Mounted-project/AugMounted-electronics/README.md

# AugMounted-electronics
Electronic repo for the AugMounted line-up
