Mounted-project/AugMounted-electronics/prototype_v1.0.0/AugMounted_Prototype_2_2023-Feb-03_08-58-28AM-000_CustomizedView646584446.png

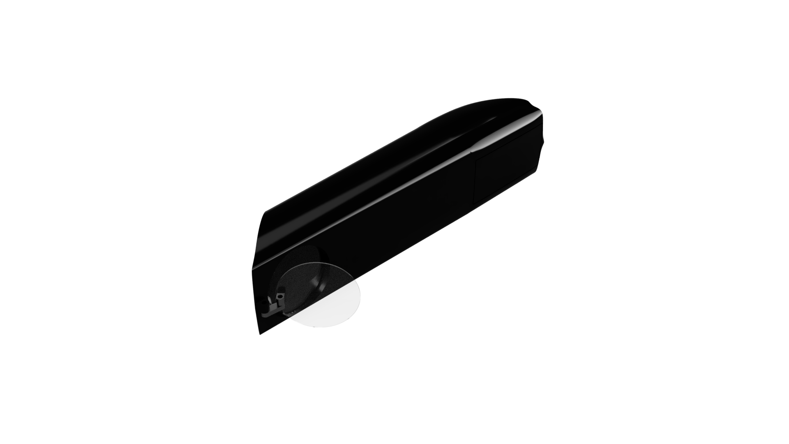
prototype_v1.0.0/AugMounted_Prototype_2_2023-Feb-03_08-58-28AM-000_CustomizedView646584446.png
