Mounted-project/AugMounted-electronics/R&D/HMI-PlugBoard_v1.0.0/00_RESOURCES/BQ24296MRGER.png

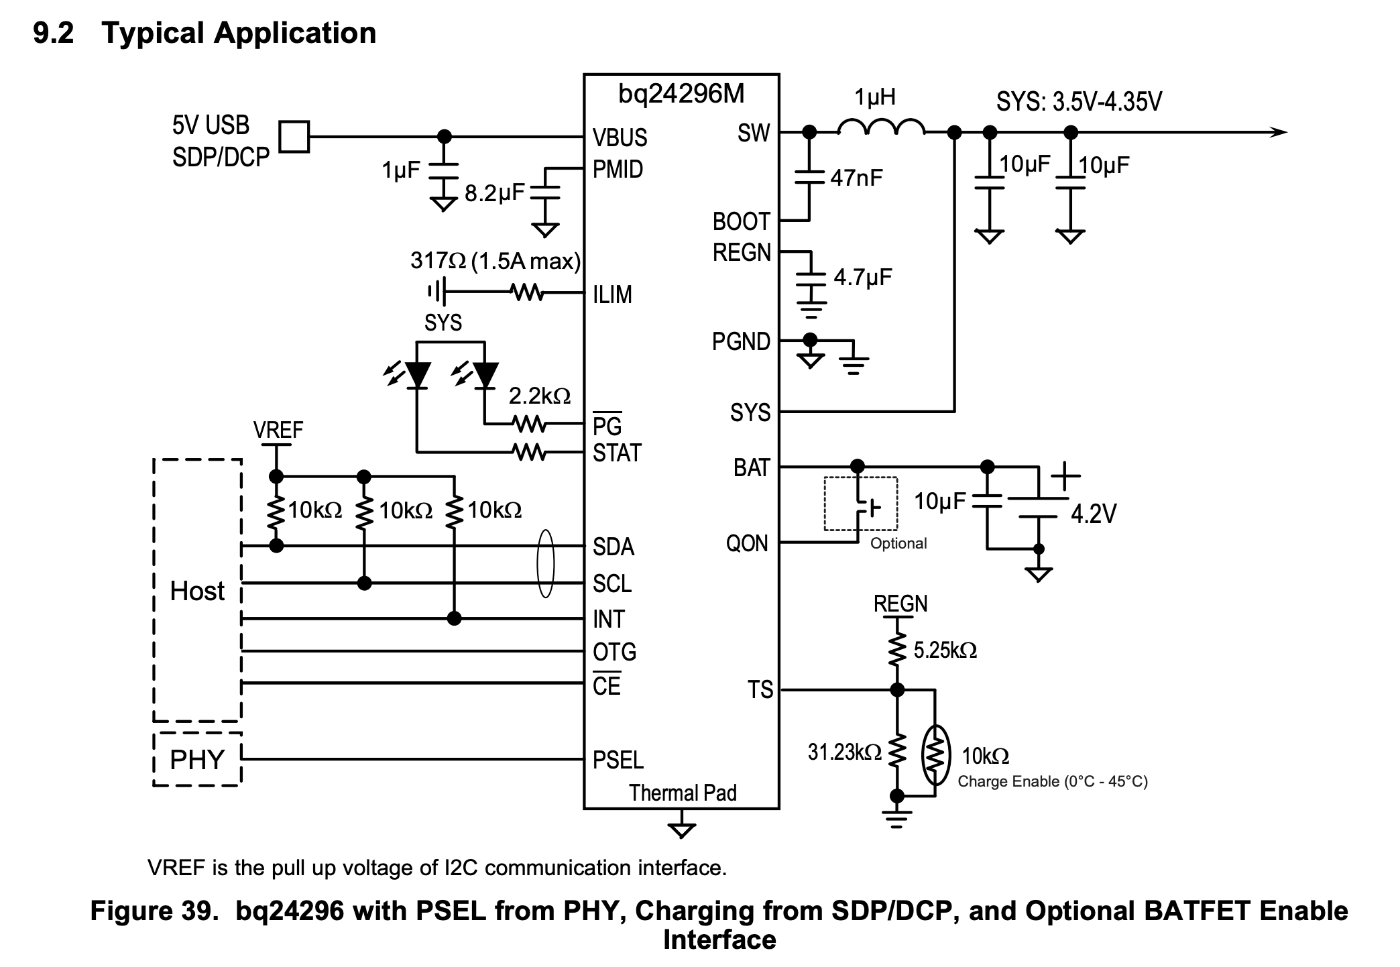
R&D/HMI-PlugBoard_v1.0.0/00_RESOURCES/BQ24296MRGER.png
