Mounted-project/AugMounted-electronics/R&D/HMI-PlugBoard_v1.0.0/00_RESOURCES/LP3987H-18B5F.png

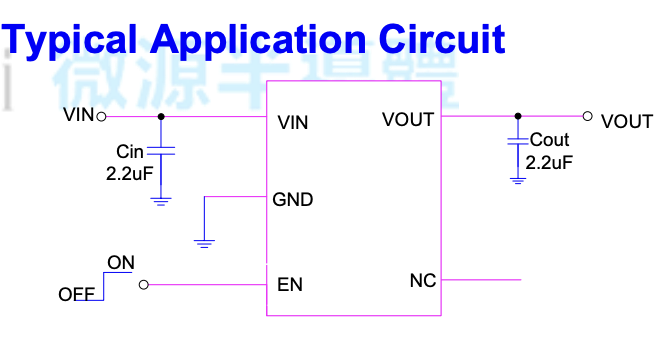
R&D/HMI-PlugBoard_v1.0.0/00_RESOURCES/LP3987H-18B5F.png
