Mounted-project/AugMounted-electronics/R&D/HMI-PlugBoard_v1.0.0/00_RESOURCES/MAX17048.png

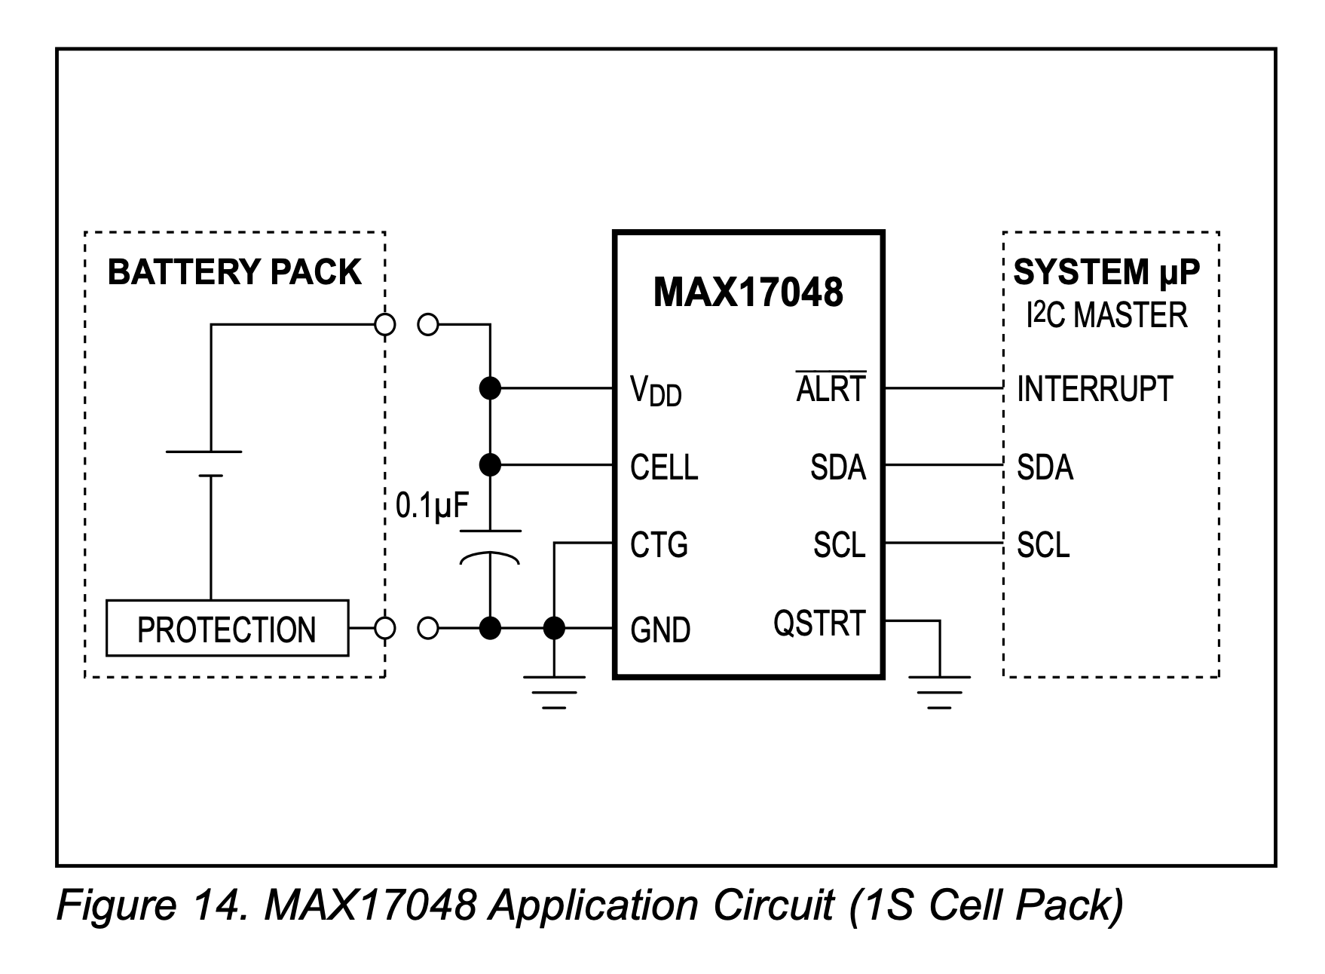
R&D/HMI-PlugBoard_v1.0.0/00_RESOURCES/MAX17048.png
