Mounted-project/AugMounted-electronics/R&D/HMI-PlugBoard_v1.0.0/00_RESOURCES/TPS63001DRCR.png

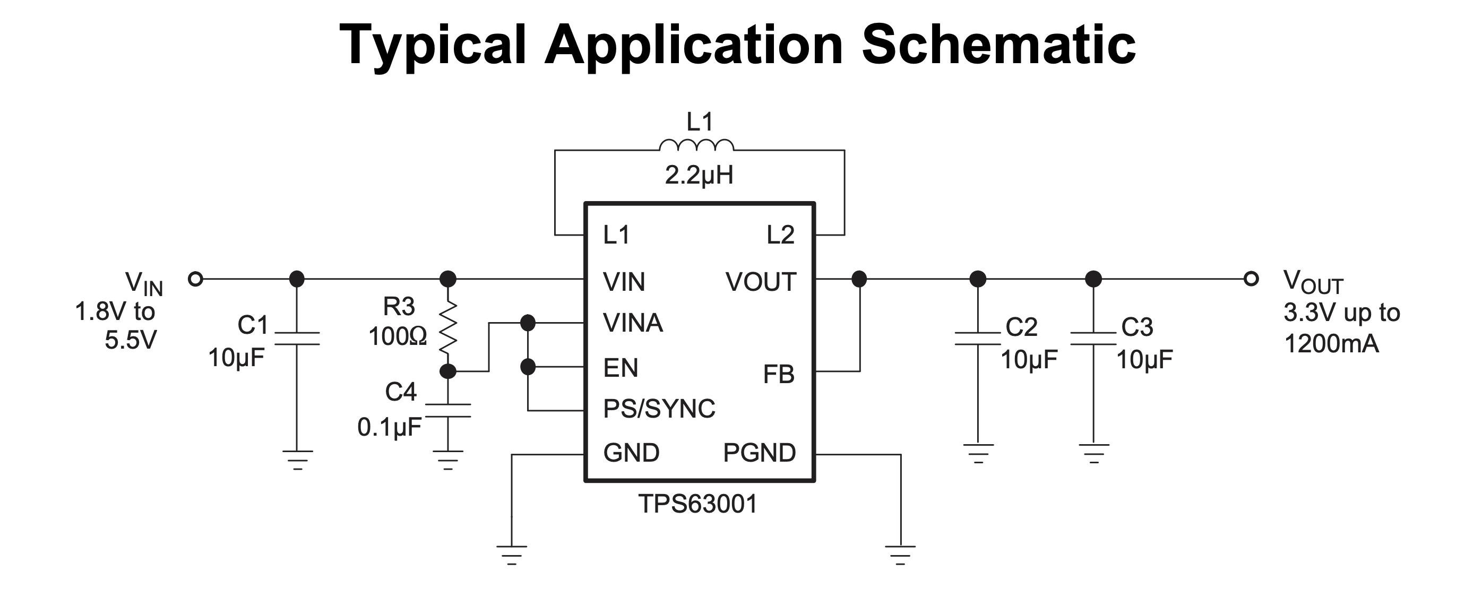
R&D/HMI-PlugBoard_v1.0.0/00_RESOURCES/TPS63001DRCR.png
