Mounted-project/AugMounted-electronics/R&D/HMI-PlugBoard_v1.0.0/00_RESOURCES/TXB0108.png

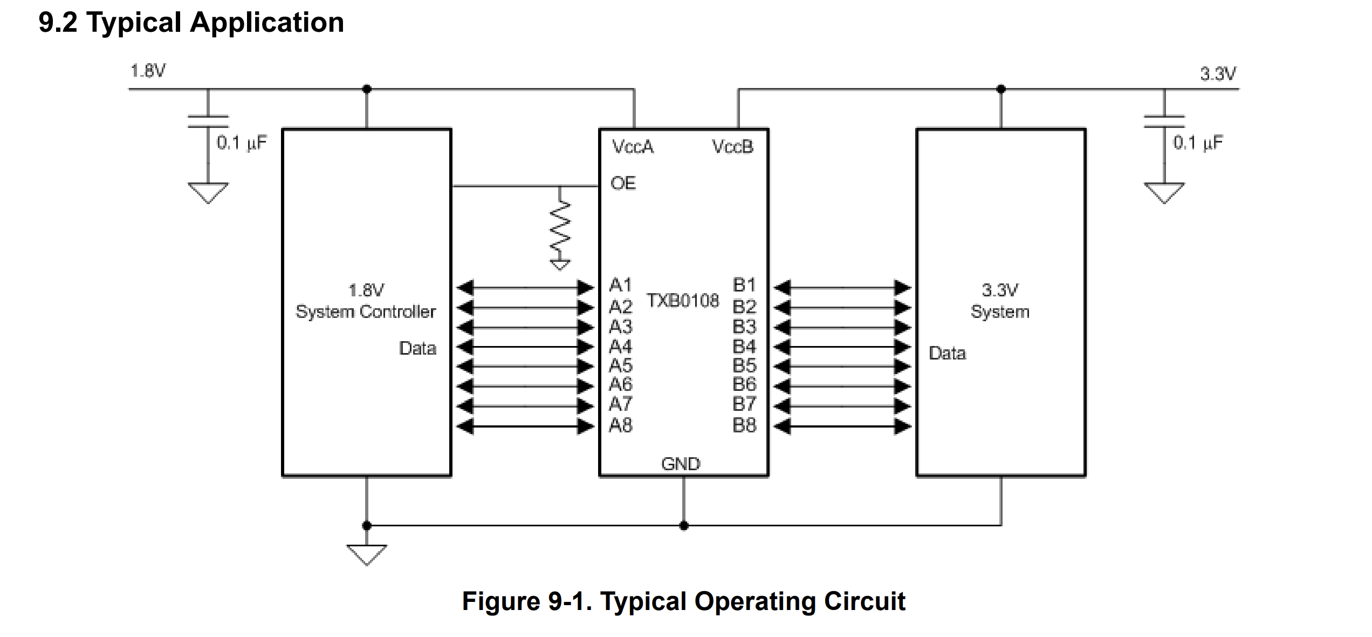
R&D/HMI-PlugBoard_v1.0.0/00_RESOURCES/TXB0108.png
