Mounted-project/AugMounted-electronics/R&D/HMI-PlugBoard_v1.0.0/00_RESOURCES/25mm.3mf

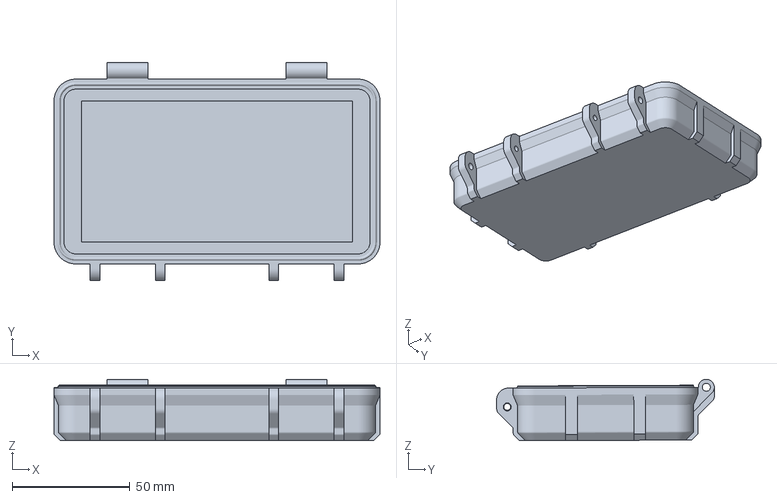
[picture p9: CAD file, 2023-11-28]
R&D/HMI-PlugBoard_v1.0.0/00_RESOURCES/25mm.3mf
138.5 x 92.5 x 26.1 mm
