Mounted-project/AugMounted-electronics/R&D/HMI_v1.0.0/02_OUTPUTS/03_MECHANICAL/HMI_A.step

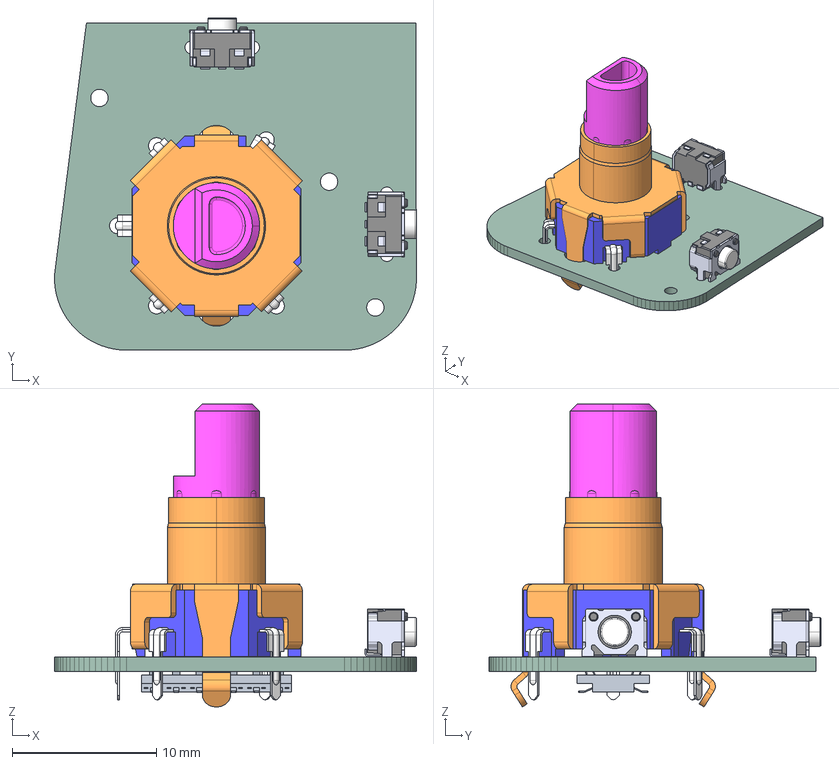
[picture p10: CAD file, 2024-01-17]
R&D/HMI_v1.0.0/02_OUTPUTS/03_MECHANICAL/HMI_A.step
25.1 x 23.0 x 21.0 mm
HMI PCB
