Mounted-project/AugMounted-electronics/mounted-lib/3D/U_MP34DT05TR-A.step

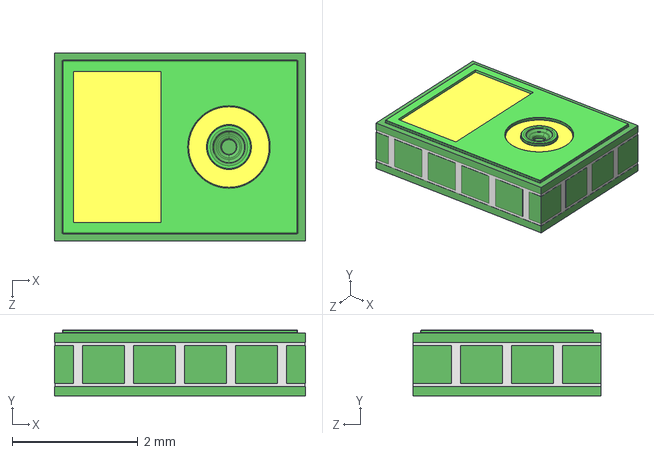
[picture p11: CAD file, 2023-11-28]
mounted-lib/3D/U_MP34DT05TR-A.step
4.00 x 1.05 x 3.00 mm
