Mounted-project/AugMounted-electronics/R&D/HMI-PlugBoard_v1.0.0/00_RESOURCES/outline8.dxf

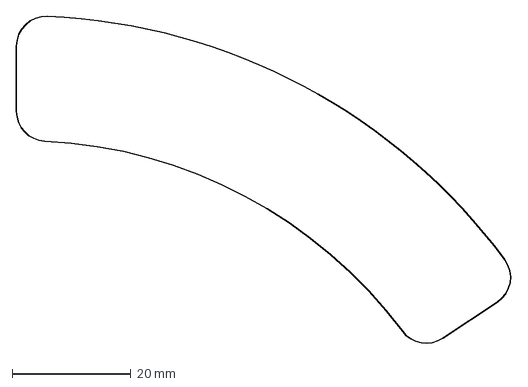
[picture p12: CAD file, 2023-11-24]
R&D/HMI-PlugBoard_v1.0.0/00_RESOURCES/outline8.dxf
83.4 x 55.8 mm
