Mounted-project/AugMounted-electronics/R&D/Zoka-MainBoard_v1.0.0/00_RESOURCES/outline6.dxf

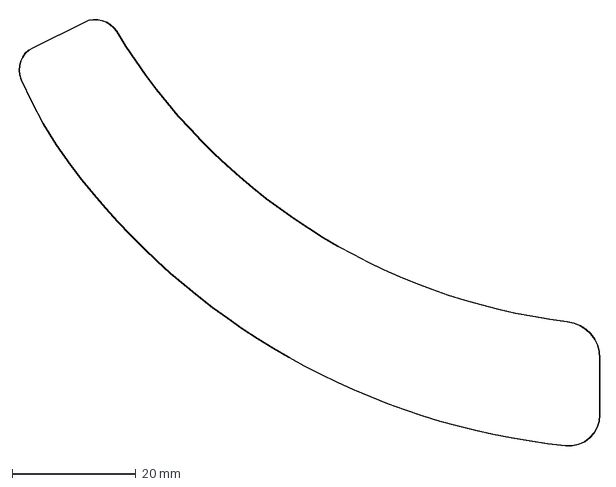
[picture p13: CAD file, 2023-11-24]
R&D/Zoka-MainBoard_v1.0.0/00_RESOURCES/outline6.dxf
94.4 x 69.5 mm
