Mounted-project/AugMounted-electronics/mounted-lib/3D/VQFN-20_TEXAS_INSTRUMENTS.step

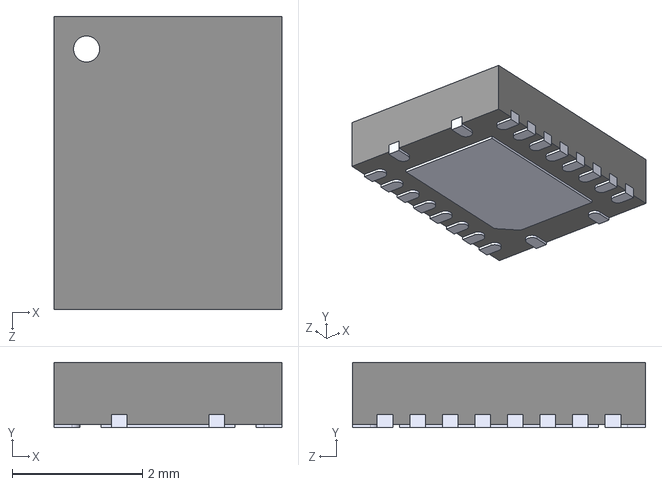
[picture p14: CAD file, 2023-11-24]
mounted-lib/3D/VQFN-20_TEXAS_INSTRUMENTS.step
3.50 x 1.00 x 4.50 mm
