Mounted-project/AugMounted-electronics/mounted-lib/3D/R_0402_1005Metric.step

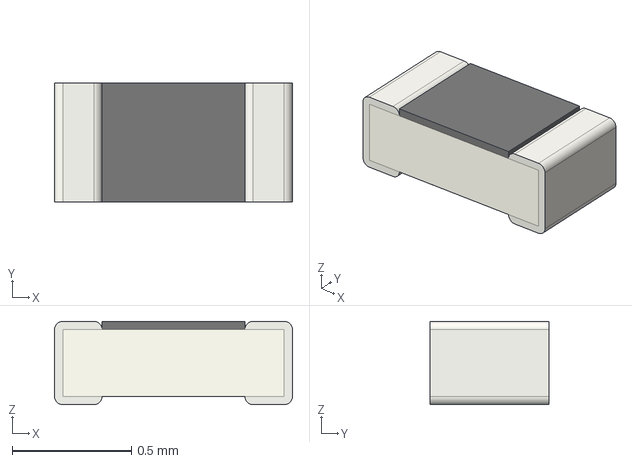
[picture p15: CAD file, 2023-11-24]
mounted-lib/3D/R_0402_1005Metric.step
1.00 x 0.5 x 0.35 mm
