Mounted-project/AugMounted-electronics/R&D/HMI-PlugBoard_v1.0.0/00_RESOURCES/outline5.dxf

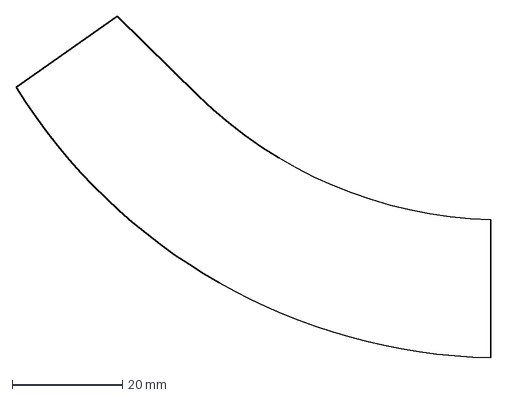
[picture p16: CAD file, 2023-11-23]
R&D/HMI-PlugBoard_v1.0.0/00_RESOURCES/outline5.dxf
86.0 x 61.8 mm
