Mounted-project/AugMounted-electronics/R&D/HMI_v1.0.0/00_RESOURCES/outlne6.dxf

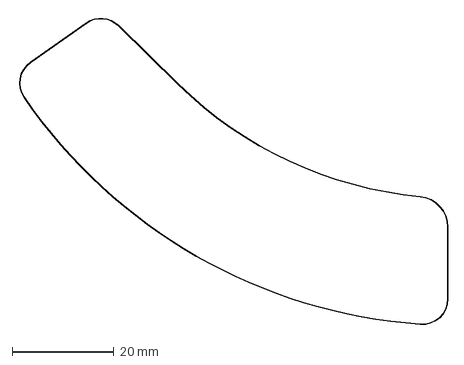
[picture p17: CAD file, 2023-11-23]
R&D/HMI_v1.0.0/00_RESOURCES/outlne6.dxf
84.8 x 60.7 mm
