Mounted-project/AugMounted-electronics/mounted-lib/3D/LED_LTW-010DCG.step

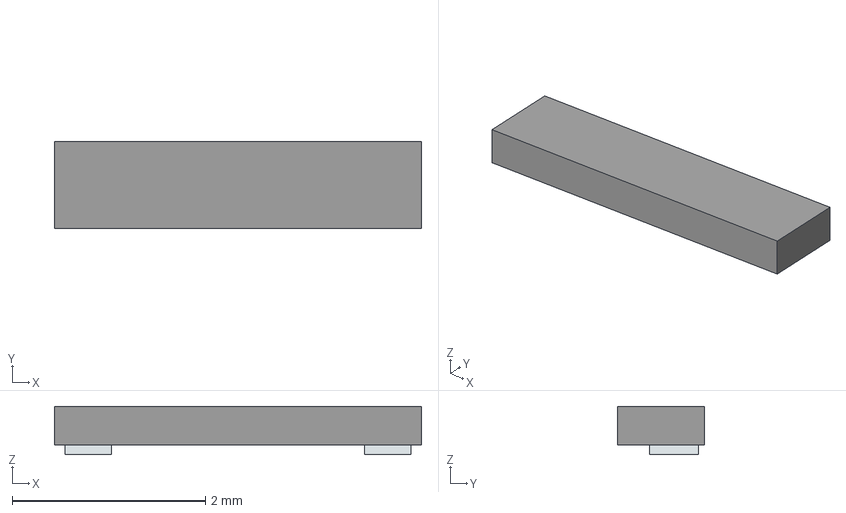
[picture p18: CAD file, 2023-11-23]
mounted-lib/3D/LED_LTW-010DCG.step
3.80 x 0.9 x 0.5 mm
Pins
