Mounted-project/AugMounted-electronics/mounted-lib/3D/LED_MHPC3528CRGBCT.step

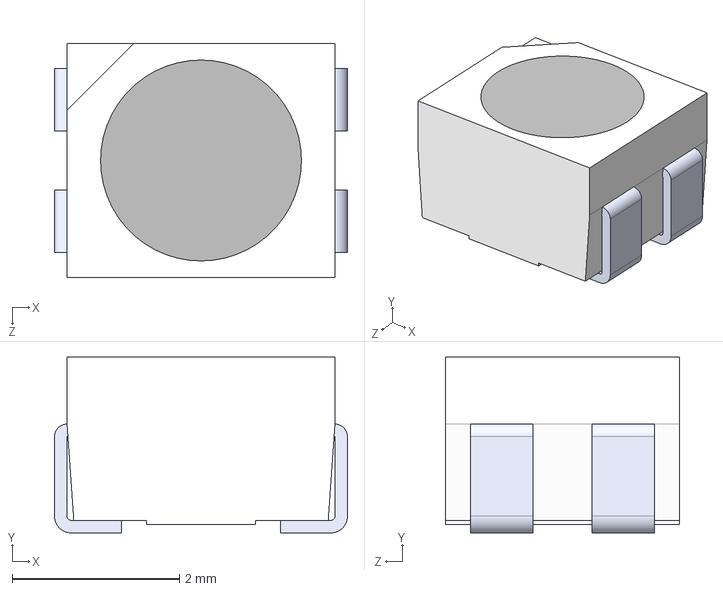
[picture p19: CAD file, 2023-11-23]
mounted-lib/3D/LED_MHPC3528CRGBCT.step
3.50 x 2.10 x 2.80 mm
