Mounted-project/AugMounted-electronics/R&D/HMI-PlugBoard_v1.0.0/00_RESOURCES/outline2.dxf

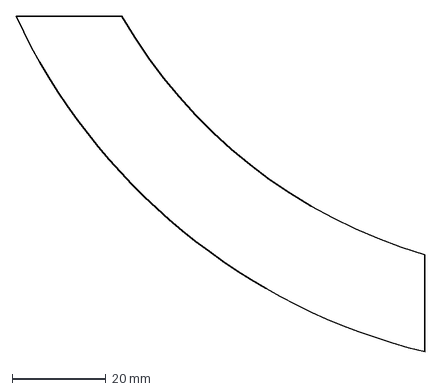
[picture p20: CAD file, 2023-11-23]
R&D/HMI-PlugBoard_v1.0.0/00_RESOURCES/outline2.dxf
87.1 x 71.5 mm
