Mounted-project/AugMounted-electronics/R&D/HMI_v1.0.0/00_RESOURCES/outline3.dxf

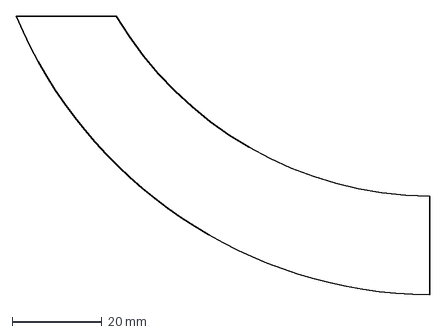
[picture p21: CAD file, 2023-11-23]
R&D/HMI_v1.0.0/00_RESOURCES/outline3.dxf
92.0 x 62.1 mm
