Mounted-project/AugMounted-electronics/R&D/Zoka-MainBoard_v1.0.0/00_RESOURCES/outline4.dxf

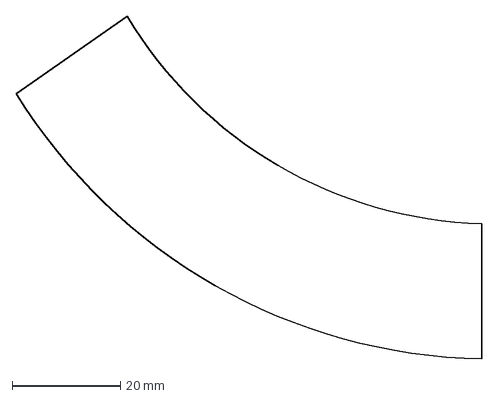
[picture p22: CAD file, 2023-11-23]
R&D/Zoka-MainBoard_v1.0.0/00_RESOURCES/outline4.dxf
86.0 x 63.3 mm
