Mounted-project/AugMounted-electronics/mounted-lib/3D/J_788641001.stp

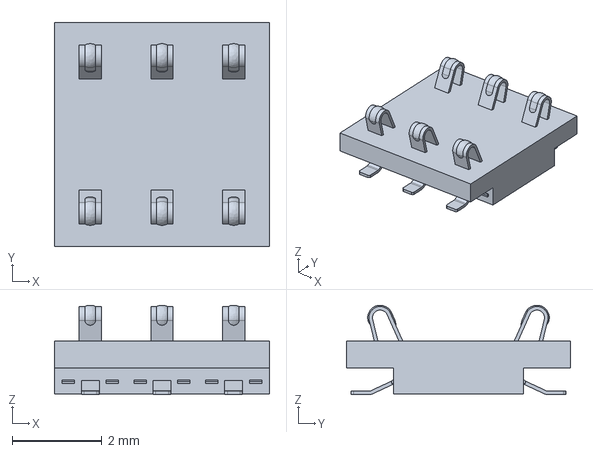
[picture p23: CAD file, 2023-11-23]
mounted-lib/3D/J_788641001.stp
4.80 x 5.00 x 2.00 mm
