Mounted-project/AugMounted-electronics/R&D/Zoka-MainBoard_v1.0.0/00_RESOURCES/outline.dxf

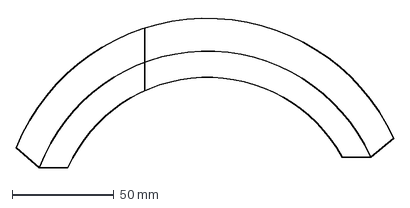
[picture p24: CAD file, 2023-11-23]
R&D/Zoka-MainBoard_v1.0.0/00_RESOURCES/outline.dxf
185.1 x 74.2 mm
