Mounted-project/AugMounted-electronics/mounted-lib/3D/LGA-12_2x2mm_P0.5mm_ST.step

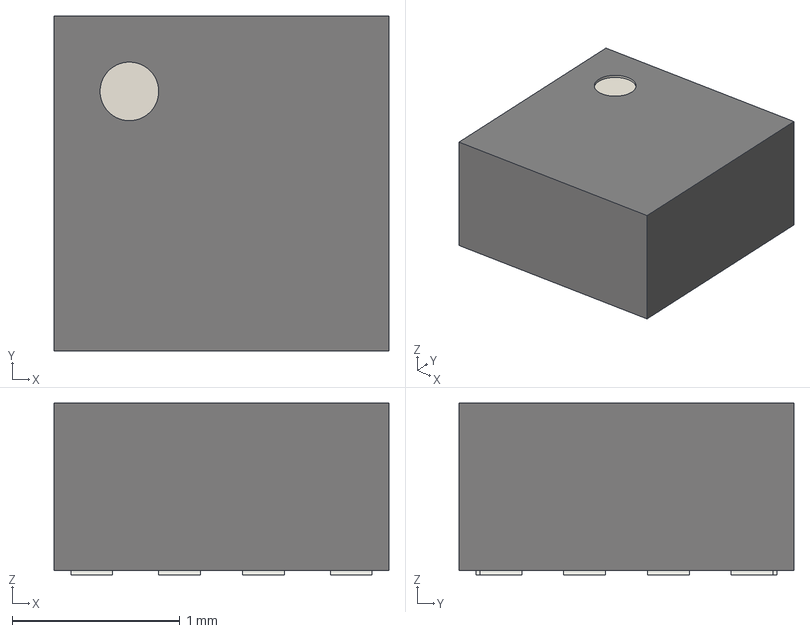
[picture p25: CAD file, 2023-11-17]
mounted-lib/3D/LGA-12_2x2mm_P0.5mm_ST.step
2.00 x 2.00 x 1.02 mm
