Mounted-project/AugMounted-electronics/mounted-lib/3D/SW_SKRTLAE010.step

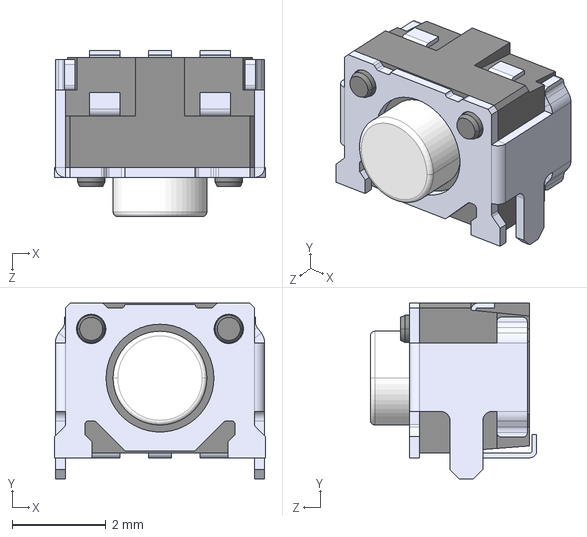
[picture p26: CAD file, 2023-11-16]
mounted-lib/3D/SW_SKRTLAE010.step
4.50 x 3.75 x 3.55 mm
