Mounted-project/AugMounted-electronics/mounted-lib/3D/QFN-28-1EP_6x6mm_P0.65mm_EP4.25x4.25mm_MICROCHIP.step

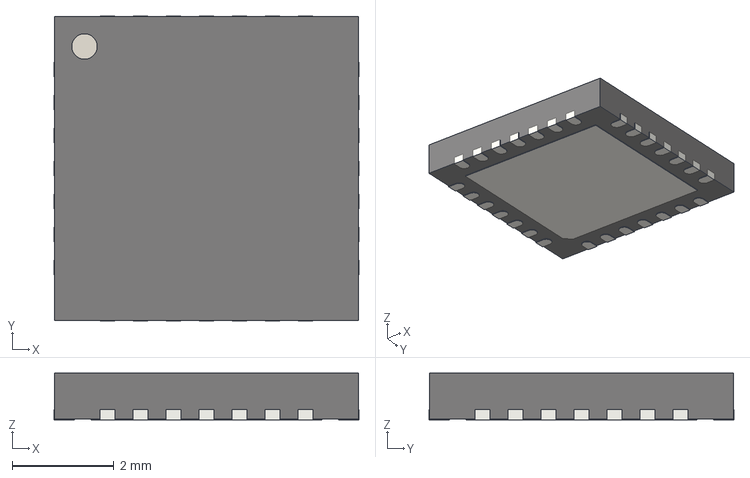
[picture p27: CAD file, 2023-11-16]
mounted-lib/3D/QFN-28-1EP_6x6mm_P0.65mm_EP4.25x4.25mm_MICROCHIP.step
6.00 x 6.00 x 0.92 mm
