Mounted-project/AugMounted-electronics/mounted-lib/3D/SW_EC12D1564404.step

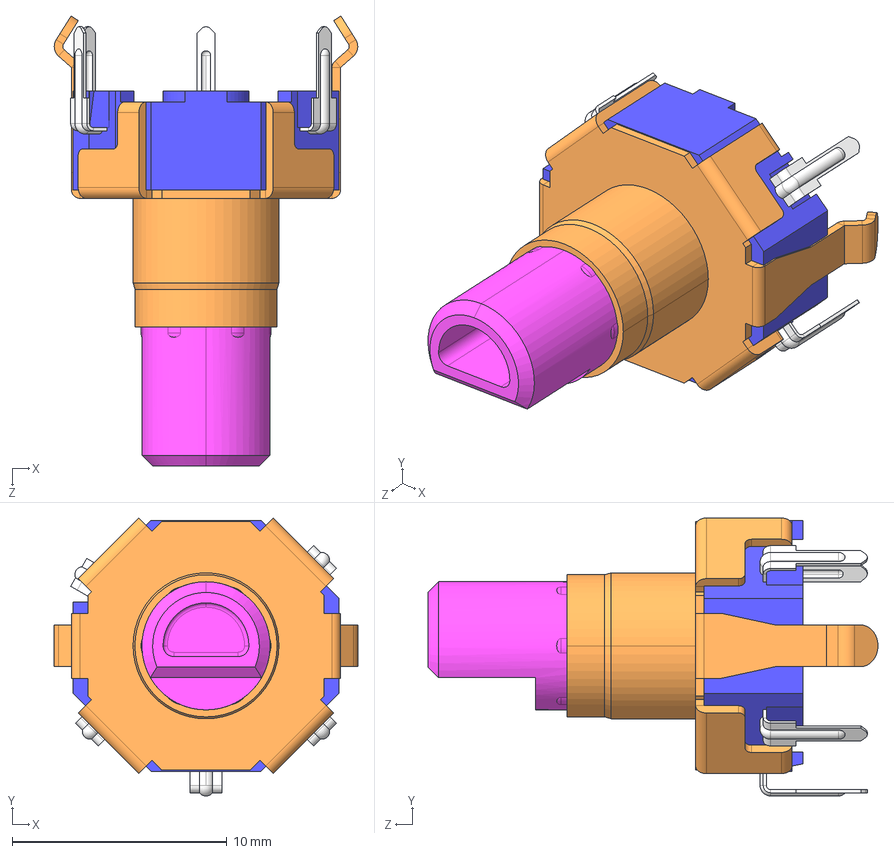
[picture p28: CAD file, 2023-11-15]
mounted-lib/3D/SW_EC12D1564404.step
14.1 x 13.0 x 21.0 mm
