Mounted-project/AugMounted-electronics/mounted-lib/3D/J_JST_S2B-PH-SM4-TB.step

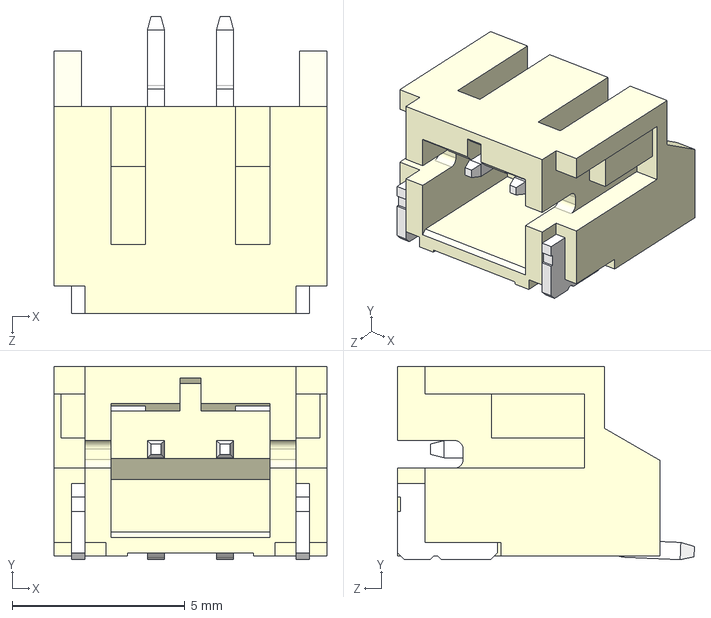
[picture p29: CAD file, 2023-11-15]
mounted-lib/3D/J_JST_S2B-PH-SM4-TB.step
7.90 x 5.60 x 8.60 mm
