Mounted-project/AugMounted-electronics/mounted-lib/3D/L_FNR3015S2R2MT.step

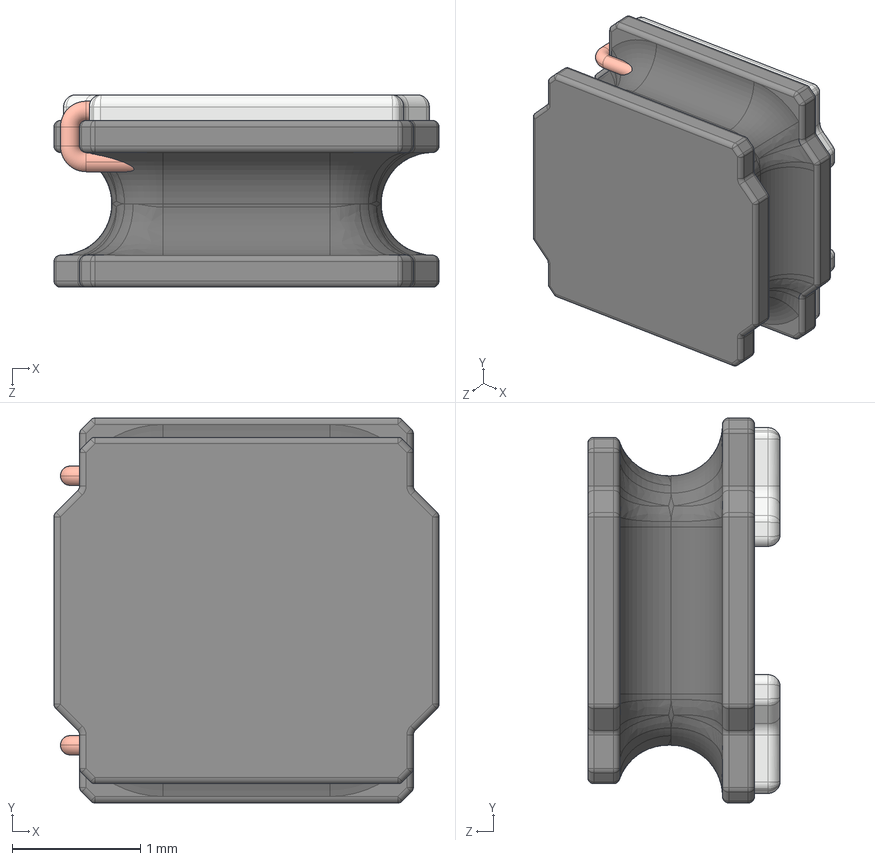
[picture p30: CAD file, 2023-11-15]
mounted-lib/3D/L_FNR3015S2R2MT.step
3.00 x 3.00 x 1.50 mm
