Mounted-project/AugMounted-electronics/mounted-lib/3D/VCNL4040_4X2X1.1_VISHAY.step

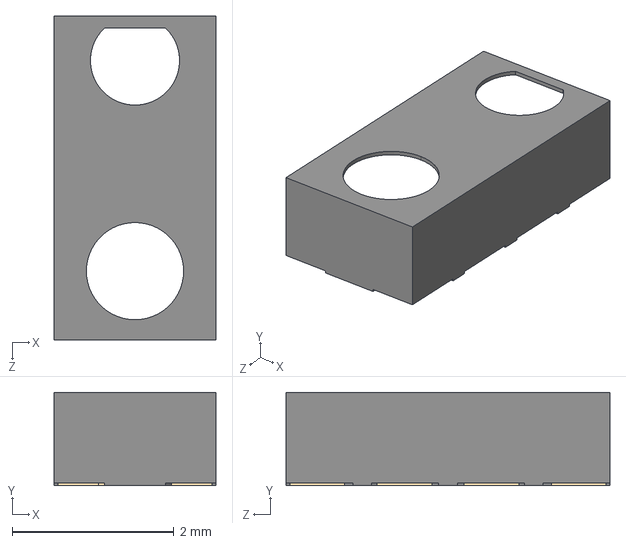
[picture p31: CAD file, 2023-11-15]
mounted-lib/3D/VCNL4040_4X2X1.1_VISHAY.step
2.00 x 1.15 x 4.00 mm
