Mounted-project/AugMounted-electronics/mounted-lib/3D/L_7447789003.step

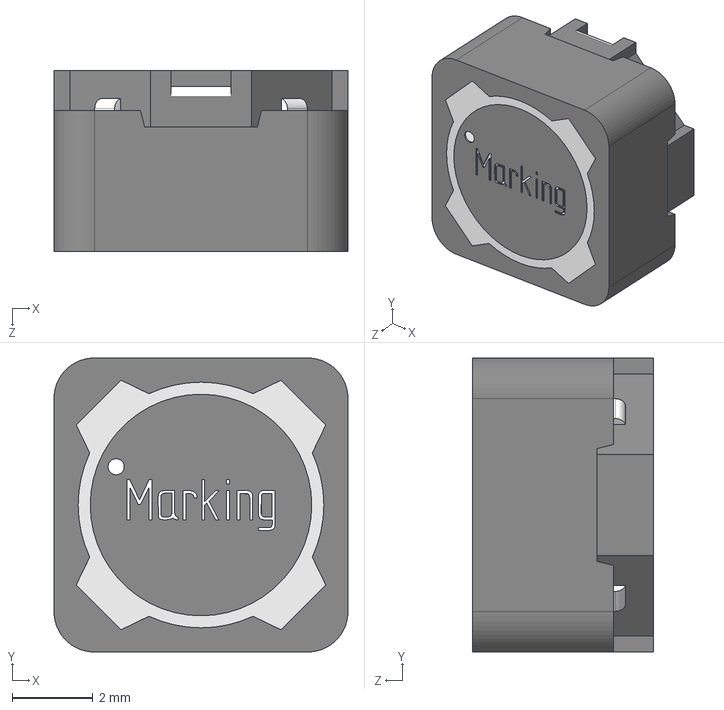
[picture p32: CAD file, 2023-11-08]
mounted-lib/3D/L_7447789003.step
7.30 x 7.30 x 4.50 mm
