Mounted-project/AugMounted-electronics/mounted-lib/3D/VQFN-24_TEXAS_INSTRUMENTS.step

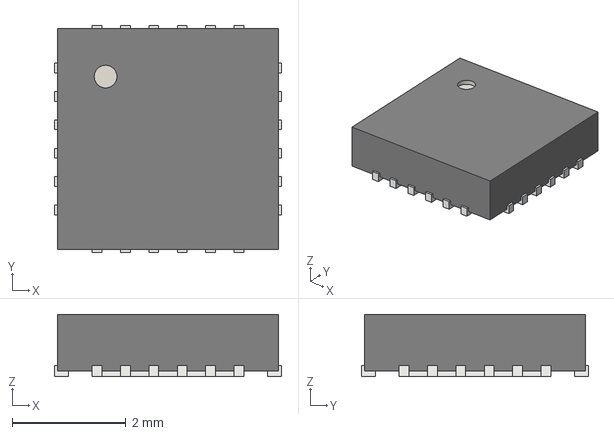
[picture p33: CAD file, 2023-11-05]
mounted-lib/3D/VQFN-24_TEXAS_INSTRUMENTS.step
4.00 x 4.00 x 1.10 mm
