Mounted-project/AugMounted-electronics/mounted-lib/3D/TDFN-8_MAXIM_INTEGRATED.step

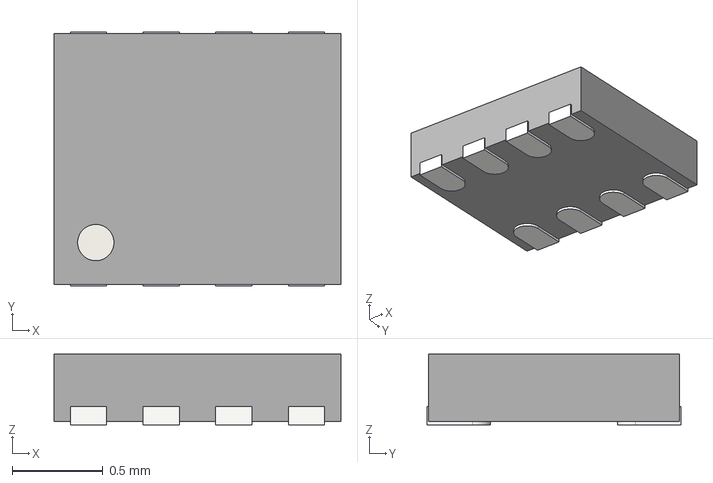
[picture p34: CAD file, 2023-11-05]
mounted-lib/3D/TDFN-8_MAXIM_INTEGRATED.step
1.58 x 1.40 x 0.39 mm
