Mounted-project/AugMounted-electronics/mounted-lib/3D/POWERPAK_SO-8_VISHAY.step

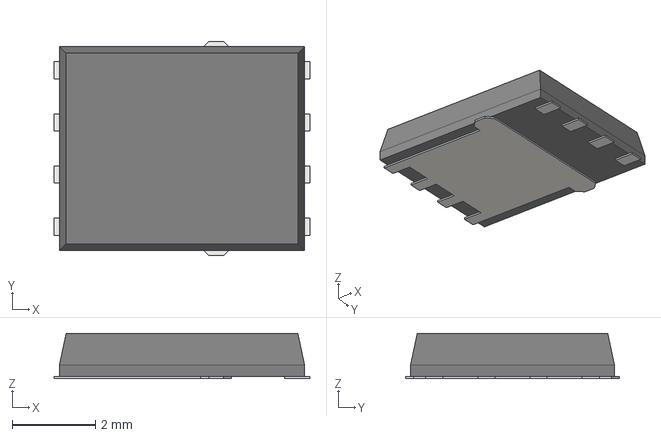
[picture p35: CAD file, 2023-11-05]
mounted-lib/3D/POWERPAK_SO-8_VISHAY.step
6.15 x 5.15 x 1.09 mm
