Mounted-project/AugMounted-electronics/mounted-lib/3D/SOT-323_SC-70_DIODES_INC.step

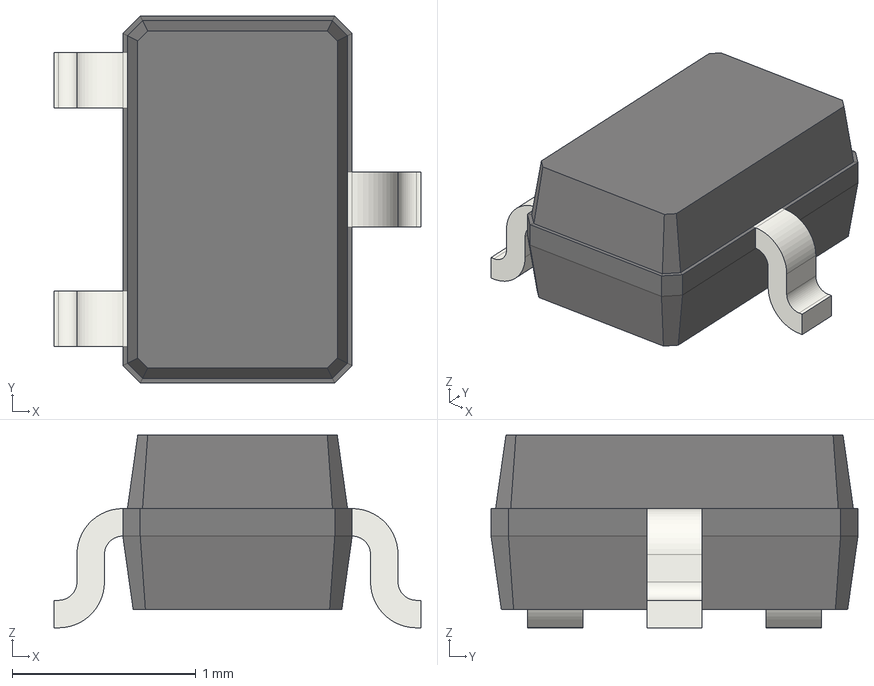
[picture p37: CAD file, 2023-11-05]
mounted-lib/3D/SOT-323_SC-70_DIODES_INC.step
2.00 x 2.00 x 1.05 mm
