Mounted-project/AugMounted-electronics/mounted-lib/3D/F_0684L9400-01.step

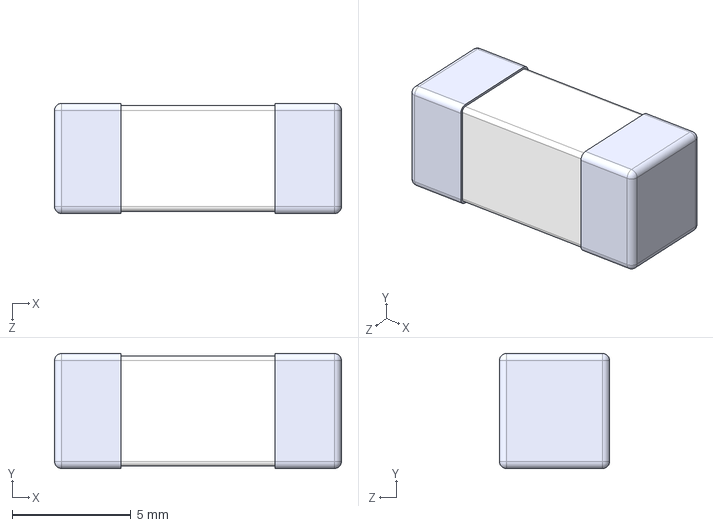
[picture p38: CAD file, 2023-11-05]
mounted-lib/3D/F_0684L9400-01.step
12.1 x 4.85 x 4.65 mm
