Mounted-project/AugMounted-electronics/mounted-lib/3D/C_0603_1608Metric.step

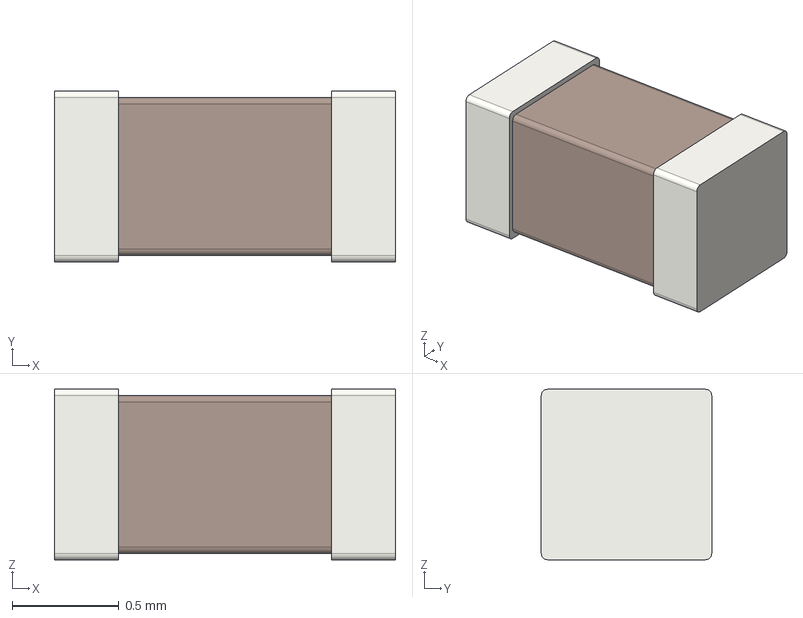
[picture p39: CAD file, 2023-11-05]
mounted-lib/3D/C_0603_1608Metric.step
1.60 x 0.8 x 0.8 mm
