Mounted-project/AugMounted-electronics/mounted-lib/3D/WSON-10_TEXAS_INSTRUMENT.step

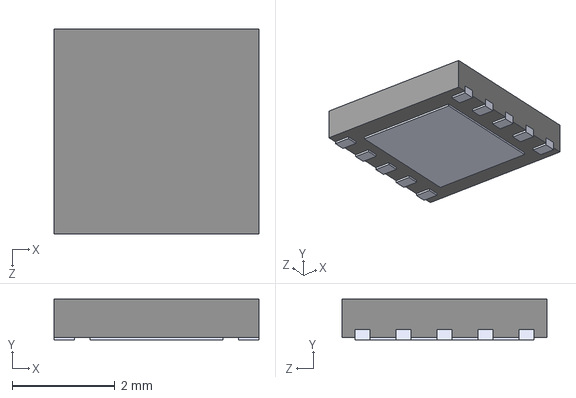
[picture p40: CAD file, 2023-11-05]
mounted-lib/3D/WSON-10_TEXAS_INSTRUMENT.step
4.00 x 0.8 x 4.00 mm
