Mounted-project/AugMounted-electronics/mounted-lib/3D/R_1210_3225Metric.step

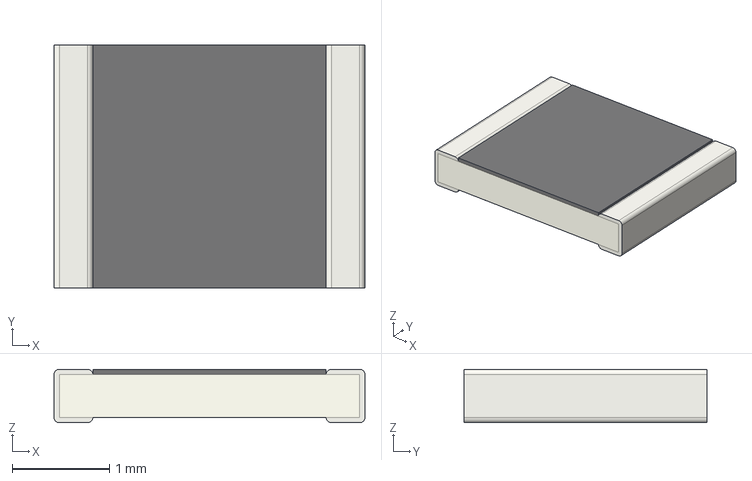
[picture p41: CAD file, 2023-11-05]
mounted-lib/3D/R_1210_3225Metric.step
3.20 x 2.50 x 0.55 mm
