Mounted-project/AugMounted-electronics/mounted-lib/3D/PVSON-N10_TEXAS_INSTRUMENTS.step

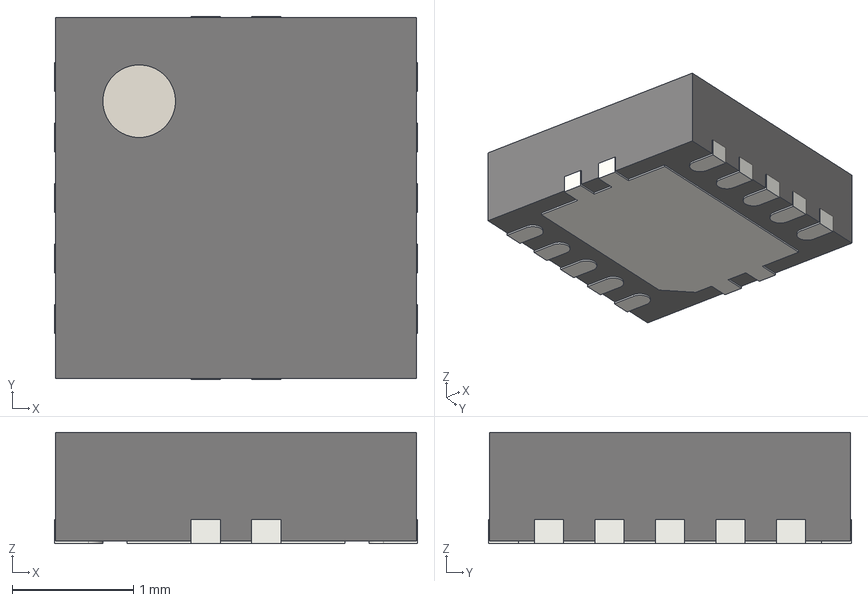
[picture p42: CAD file, 2023-11-05]
mounted-lib/3D/PVSON-N10_TEXAS_INSTRUMENTS.step
3.00 x 3.00 x 0.92 mm
