Mounted-project/AugMounted-electronics/mounted-lib/3D/CP_Elec_8x10.5_KNSCHA.step

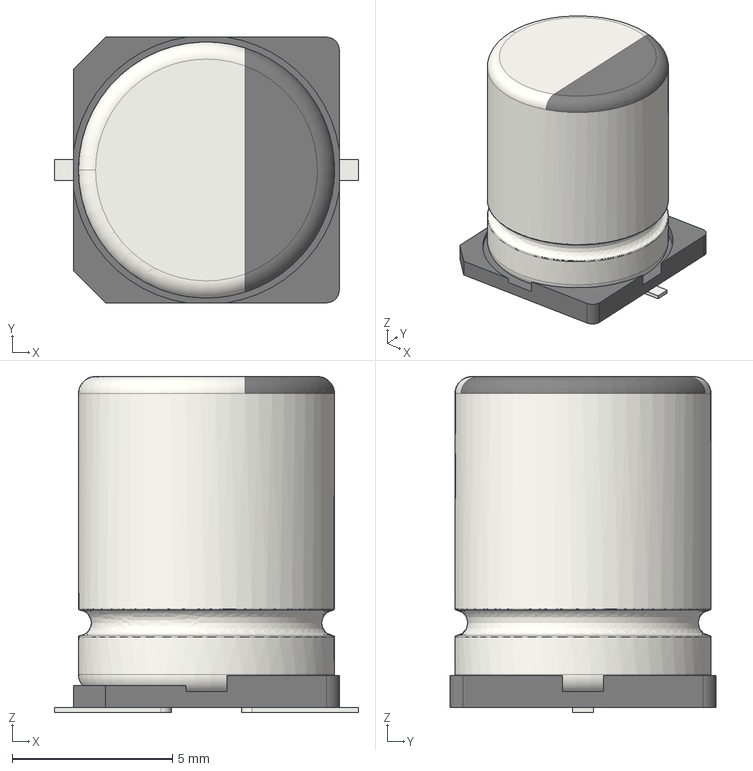
[picture p43: CAD file, 2023-11-05]
mounted-lib/3D/CP_Elec_8x10.5_KNSCHA.step
9.50 x 8.30 x 10.5 mm
