Mounted-project/AugMounted-electronics/mounted-lib/3D/TO-252-3_TabPin2_DIODES_INC.step

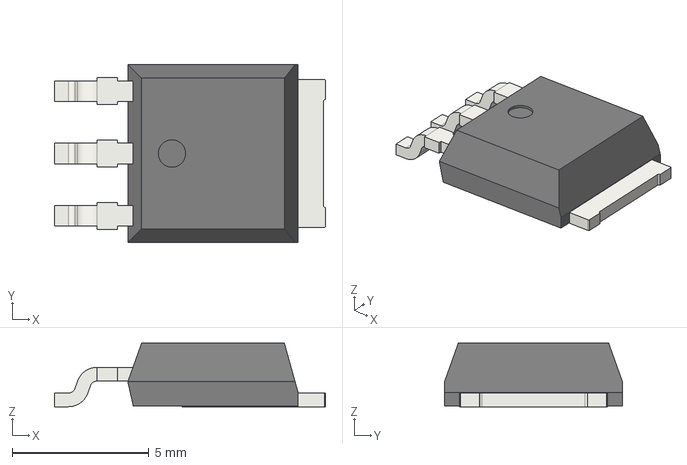
[picture p44: CAD file, 2023-11-05]
mounted-lib/3D/TO-252-3_TabPin2_DIODES_INC.step
9.90 x 6.50 x 2.32 mm
