Mounted-project/AugMounted-electronics/mounted-lib/3D/TL3301CFxxxxG.stp

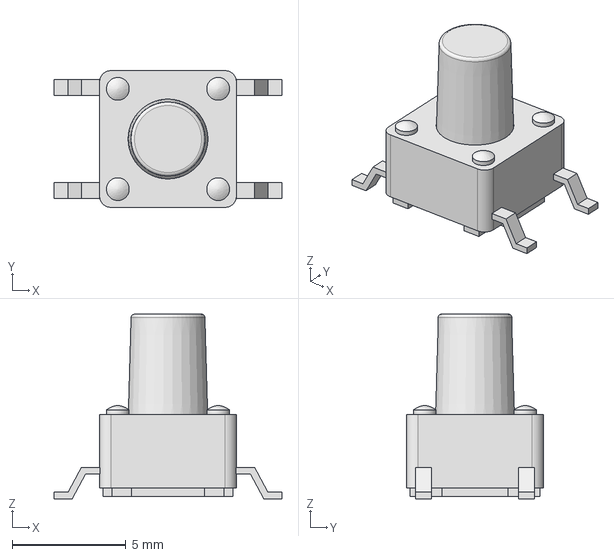
[picture p45: CAD file, 2023-11-05]
mounted-lib/3D/TL3301CFxxxxG.stp
10.00 x 6.00 x 8.10 mm
