Mounted-project/AugMounted-electronics/mounted-lib/3D/SOP-16_3.9x10mm_P1.27mm_WCH.step

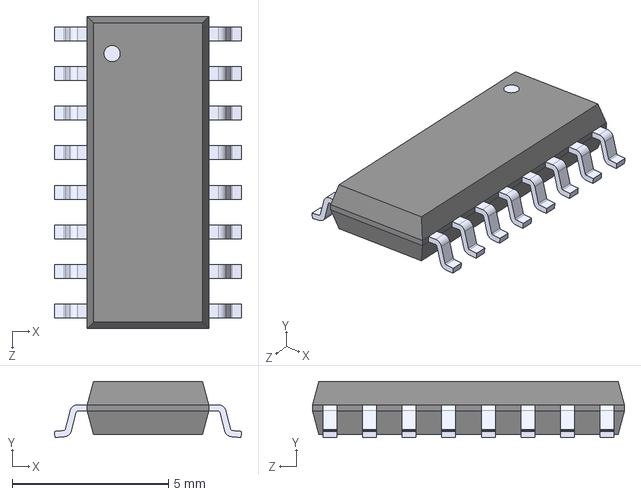
[picture p46: CAD file, 2023-11-05]
mounted-lib/3D/SOP-16_3.9x10mm_P1.27mm_WCH.step
6.00 x 1.80 x 10.0 mm
