Mounted-project/AugMounted-electronics/mounted-lib/3D/J_XT60-F.step

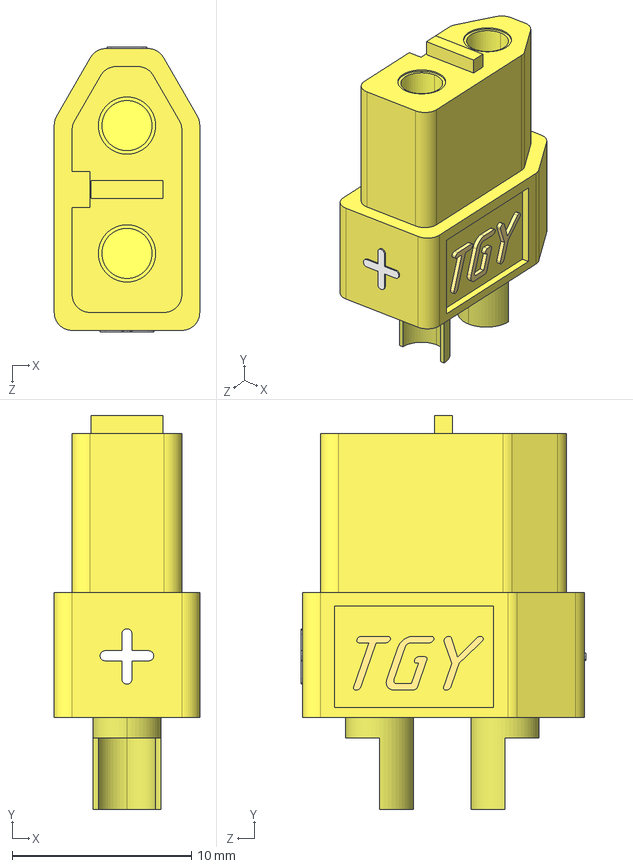
[picture p47: CAD file, 2023-11-05]
mounted-lib/3D/J_XT60-F.step
8.13 x 22.0 x 15.9 mm
