Mounted-project/AugMounted-electronics/mounted-lib/3D/PTS815_SJM_250_SMTR_LFS.stp

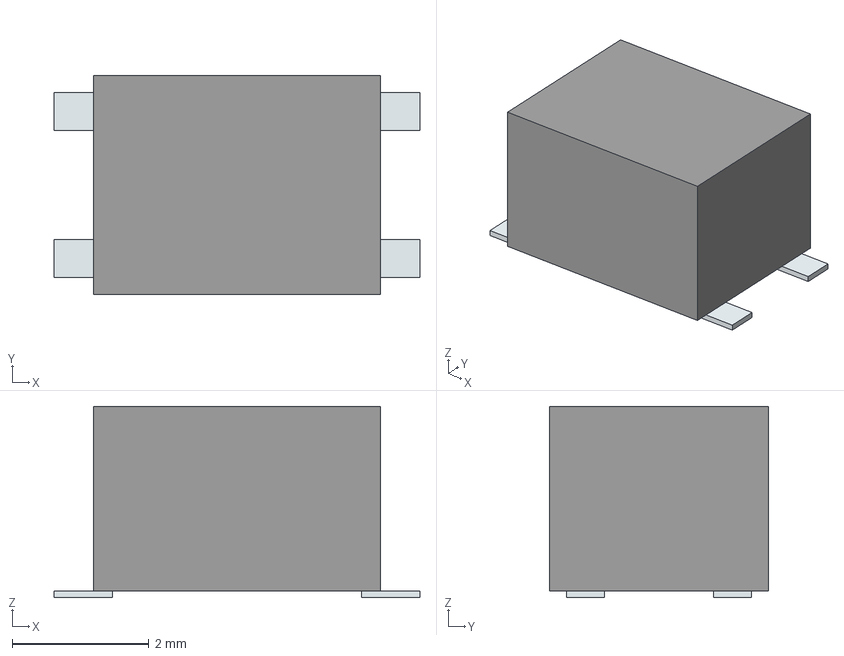
[picture p48: CAD file, 2023-11-05]
mounted-lib/3D/PTS815_SJM_250_SMTR_LFS.stp
5.36 x 3.20 x 2.80 mm
Pins
