Mounted-project/AugMounted-electronics/mounted-lib/3D/J_FH43B-61S-0.2SHW.stp

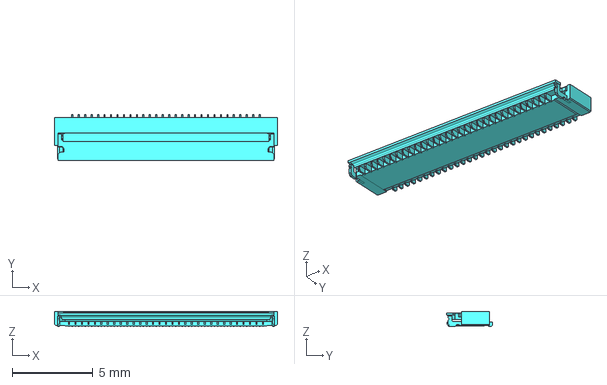
[picture p49: CAD file, 2023-11-05]
mounted-lib/3D/J_FH43B-61S-0.2SHW.stp
13.8 x 2.85 x 0.9 mm
