Mounted-project/AugMounted-electronics/mounted-lib/3D/R_2512_6332Metric.step

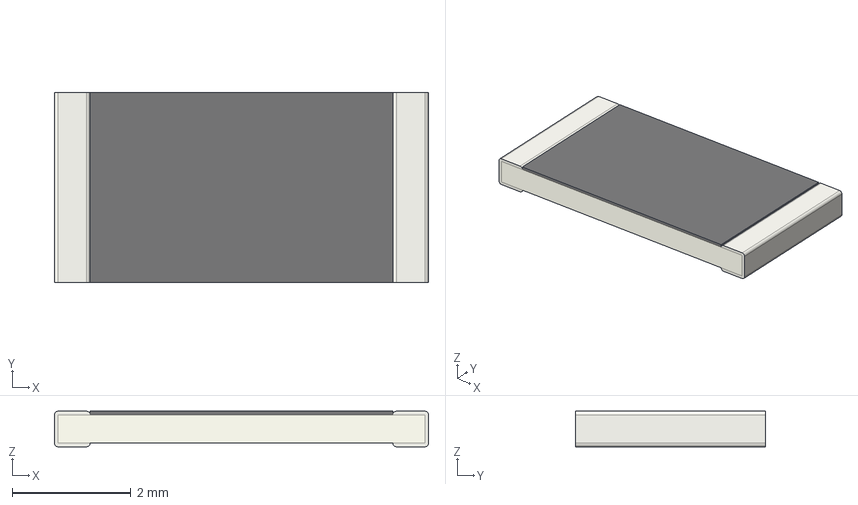
[picture p50: CAD file, 2023-11-05]
mounted-lib/3D/R_2512_6332Metric.step
6.30 x 3.20 x 0.6 mm
