Mounted-project/AugMounted-electronics/mounted-lib/3D/SOT-23-5_TI_DBV0005A.step

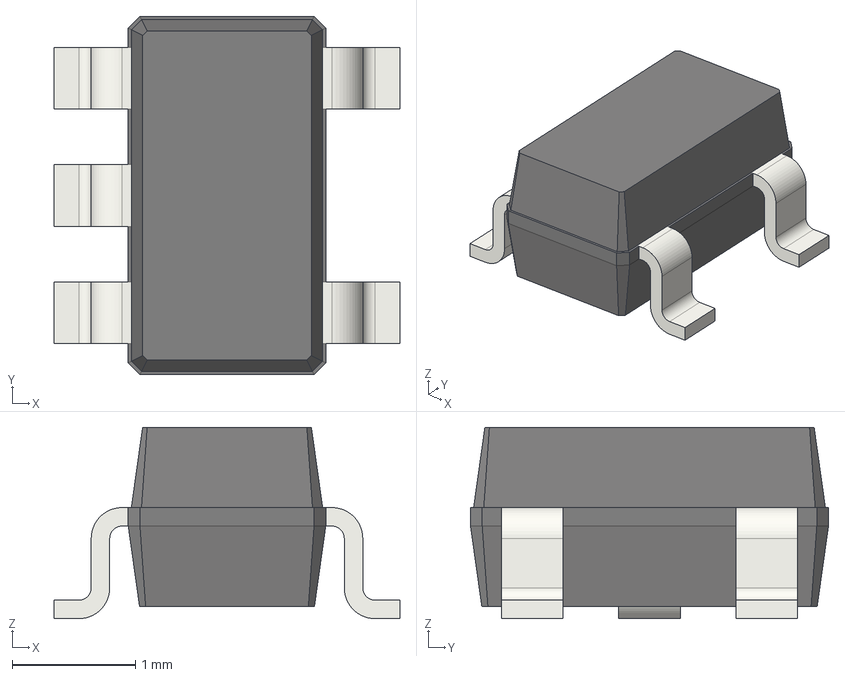
[picture p51: CAD file, 2023-11-05]
mounted-lib/3D/SOT-23-5_TI_DBV0005A.step
2.80 x 2.90 x 1.55 mm
