Mounted-project/AugMounted-electronics/mounted-lib/3D/SC-70-6_TI.step

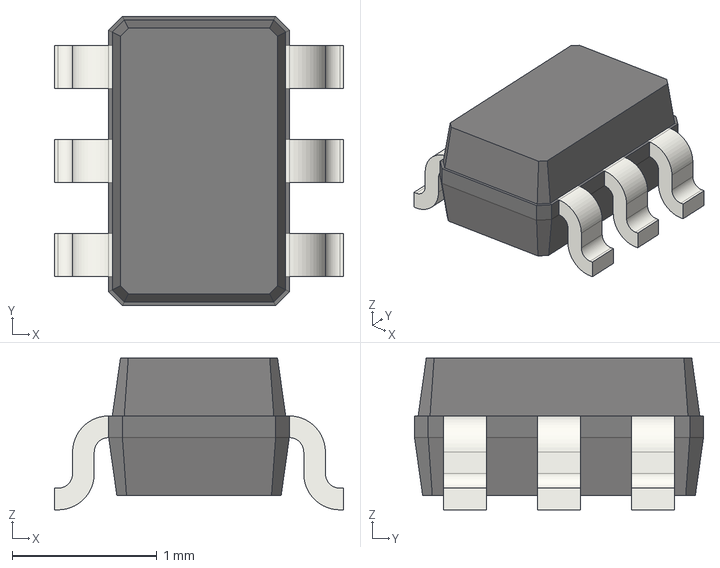
[picture p52: CAD file, 2023-11-05]
mounted-lib/3D/SC-70-6_TI.step
2.00 x 2.00 x 1.05 mm
