Mounted-project/AugMounted-electronics/mounted-lib/3D/P70-2300045X.step

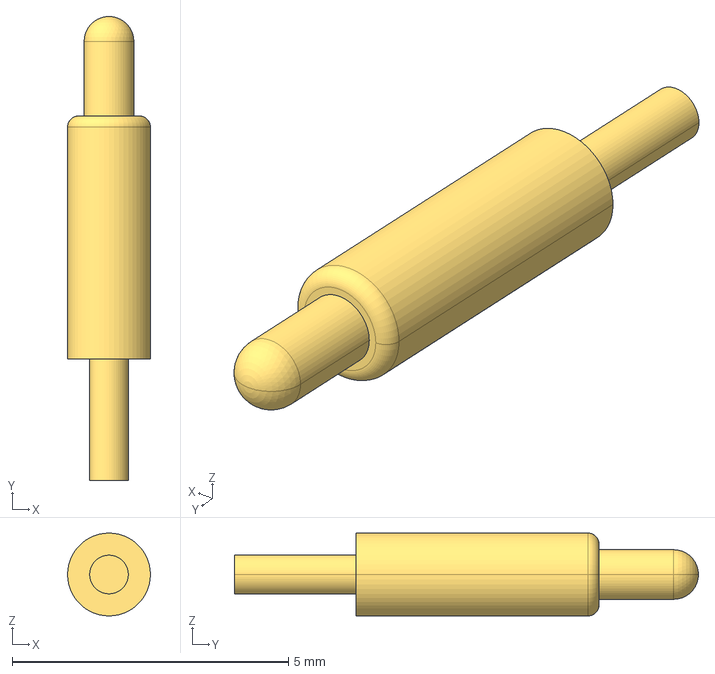
[picture p53: CAD file, 2023-11-05]
mounted-lib/3D/P70-2300045X.step
1.50 x 8.40 x 1.50 mm
