Mounted-project/AugMounted-electronics/mounted-lib/3D/TSSOP-20_4.4x6.5mm_P0.65mm_TEXAS_INSTRUMENTS.step

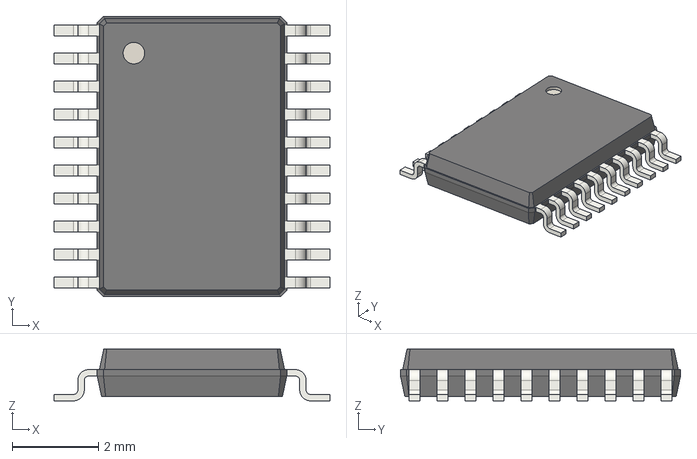
[picture p54: CAD file, 2023-11-05]
mounted-lib/3D/TSSOP-20_4.4x6.5mm_P0.65mm_TEXAS_INSTRUMENTS.step
6.40 x 6.50 x 1.20 mm
