Mounted-project/AugMounted-electronics/mounted-lib/3D/F_C1F_BELFUSE.STEP

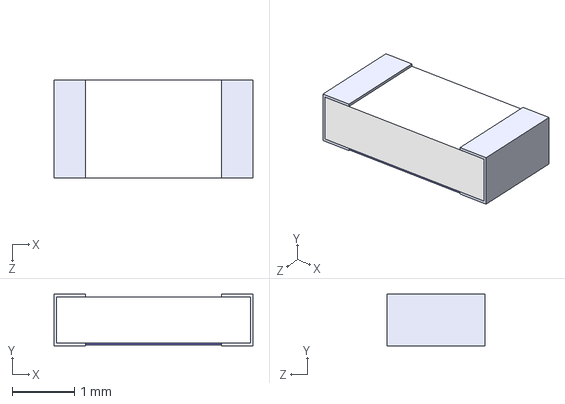
[picture p55: CAD file, 2023-11-05]
mounted-lib/3D/F_C1F_BELFUSE.STEP
3.20 x 0.83 x 1.58 mm
