Mounted-project/AugMounted-electronics/mounted-lib/3D/TQFP-48_7x7mm_P0.5mm.step

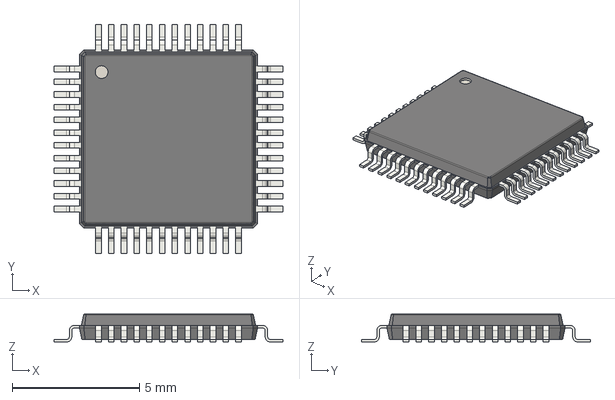
[picture p56: CAD file, 2023-11-05]
mounted-lib/3D/TQFP-48_7x7mm_P0.5mm.step
9.00 x 9.00 x 1.10 mm
