Mounted-project/AugMounted-electronics/mounted-lib/3D/SOIC-8_TI.step

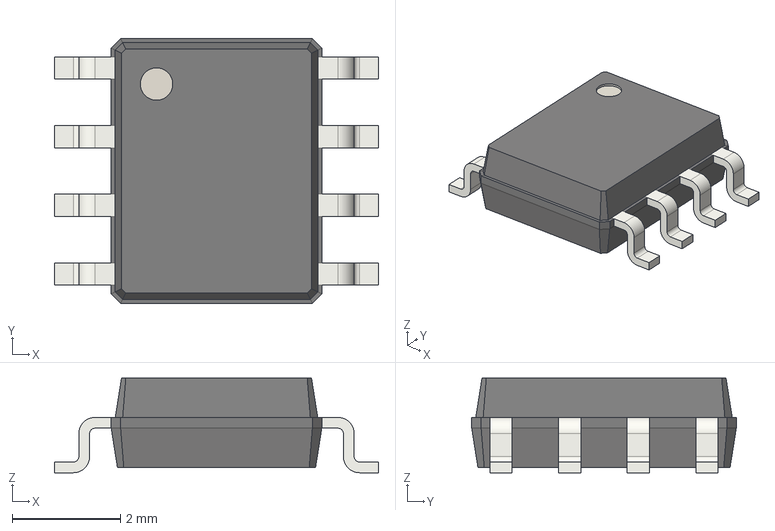
[picture p57: CAD file, 2023-11-05]
mounted-lib/3D/SOIC-8_TI.step
6.00 x 4.90 x 1.75 mm
