Mounted-project/AugMounted-electronics/mounted-lib/3D/ESP32-WROVER-E.STEP

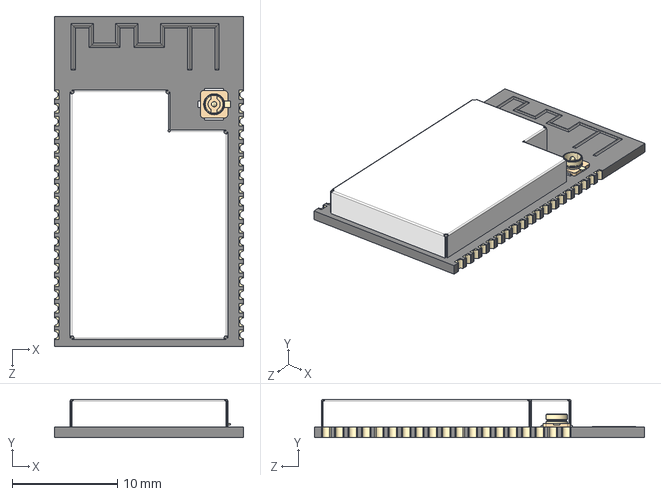
[picture p58: CAD file, 2023-11-05]
mounted-lib/3D/ESP32-WROVER-E.STEP
18.0 x 3.65 x 31.4 mm
