Mounted-project/AugMounted-electronics/mounted-lib/3D/J_GROVE_SMD_RIGHT_ANGLE.step

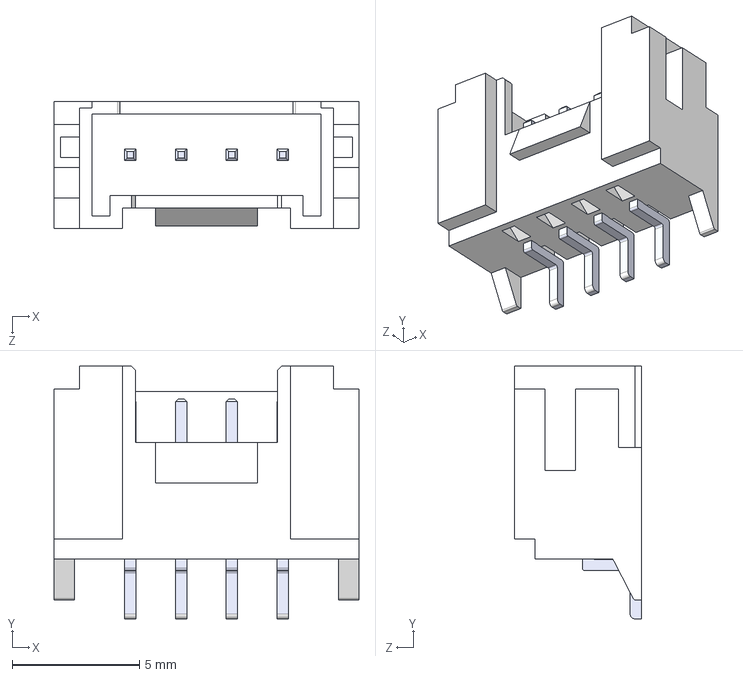
[picture p59: CAD file, 2023-11-05]
mounted-lib/3D/J_GROVE_SMD_RIGHT_ANGLE.step
12.0 x 9.95 x 5.00 mm
