Mounted-project/AugMounted-electronics/mounted-lib/3D/SRR1260.step

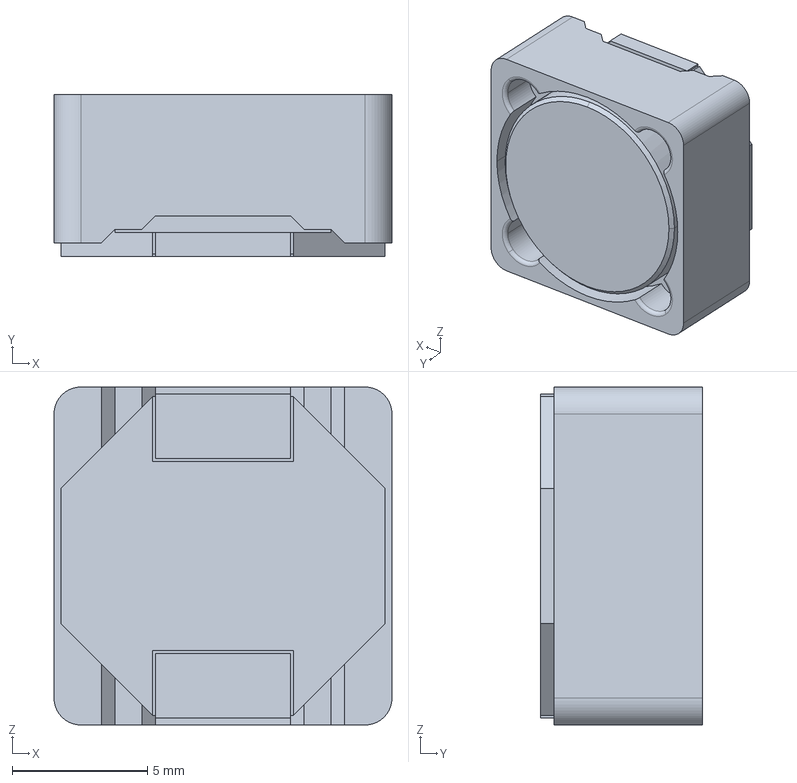
[picture p60: CAD file, 2023-11-05]
mounted-lib/3D/SRR1260.step
12.5 x 6.00 x 12.5 mm
