Mounted-project/AugMounted-electronics/mounted-lib/3D/SRN1060.step

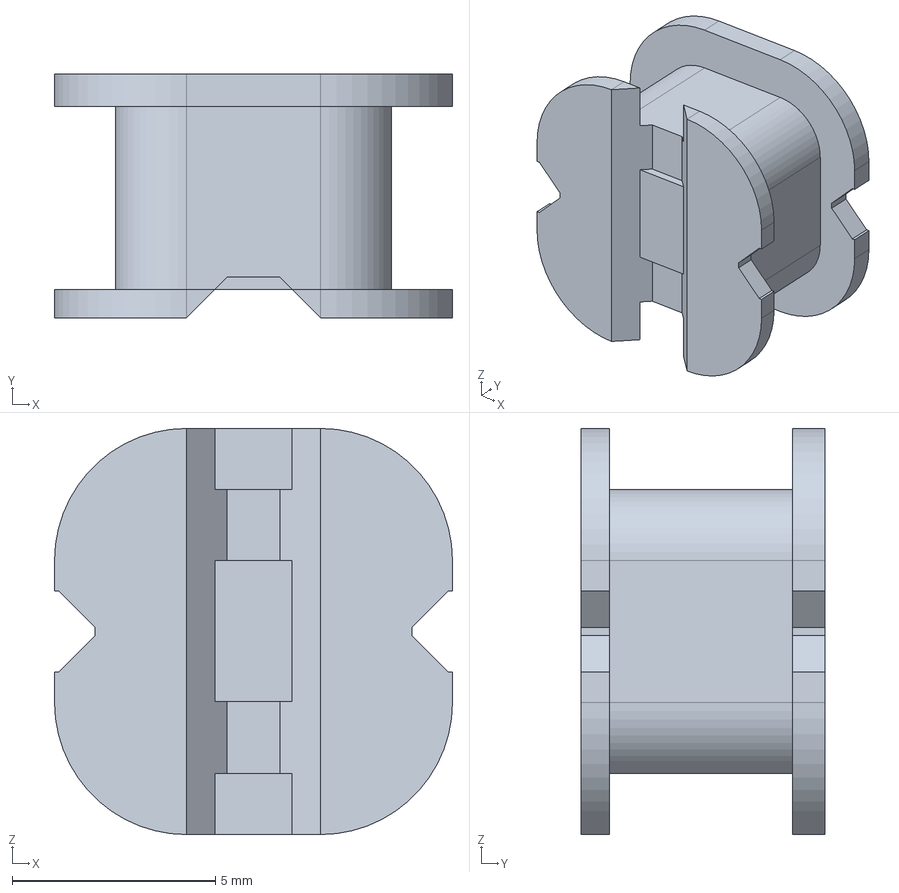
[picture p61: CAD file, 2023-11-05]
mounted-lib/3D/SRN1060.step
9.80 x 6.00 x 10.0 mm
