Mounted-project/AugMounted-electronics/mounted-lib/3D/SOT-23-6.stp

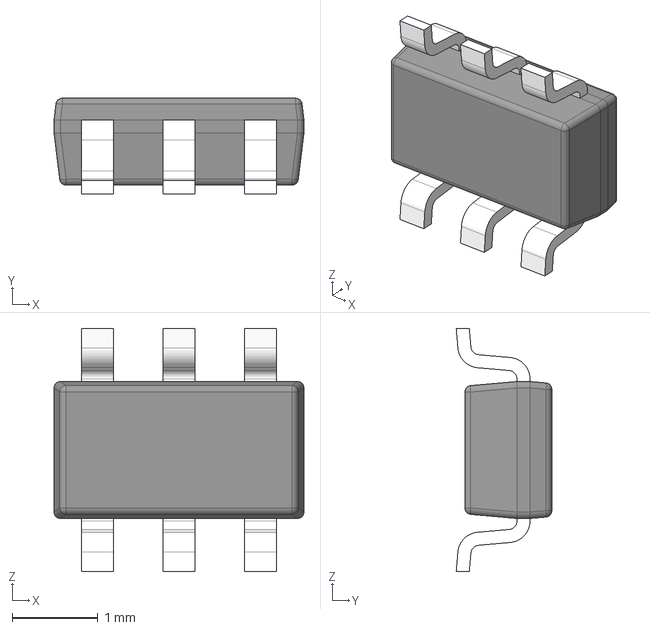
[picture p62: CAD file, 2023-11-05]
mounted-lib/3D/SOT-23-6.stp
2.92 x 1.12 x 2.84 mm
BODY_MF06A
LEAD_MF06A x 6
