Mounted-project/AugMounted-electronics/mounted-lib/3D/FE_0603_742792653.stp

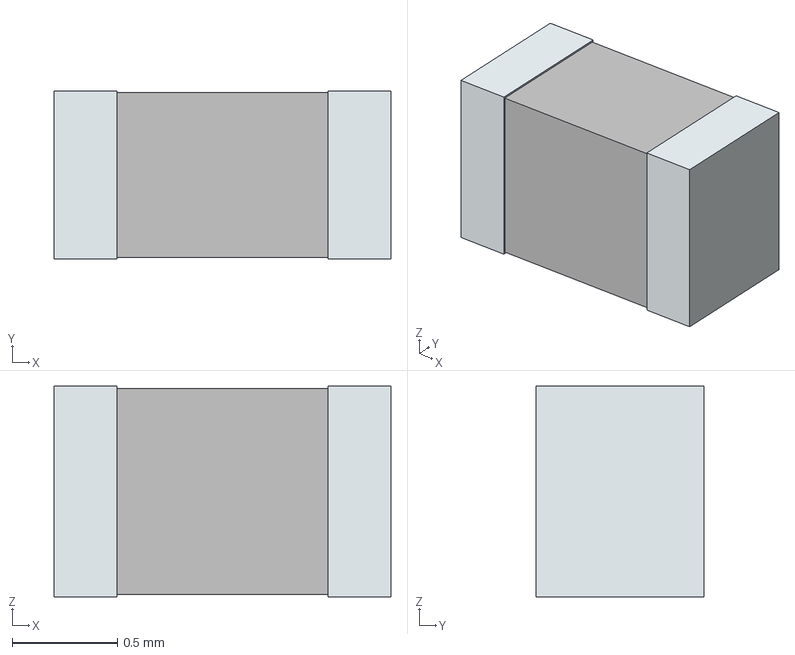
[picture p63: CAD file, 2023-11-05]
mounted-lib/3D/FE_0603_742792653.stp
1.60 x 0.8 x 1.00 mm
term1
term2
