Mounted-project/AugMounted-electronics/mounted-lib/3D/J_7-5530843-7_EDGE_SIDE.step

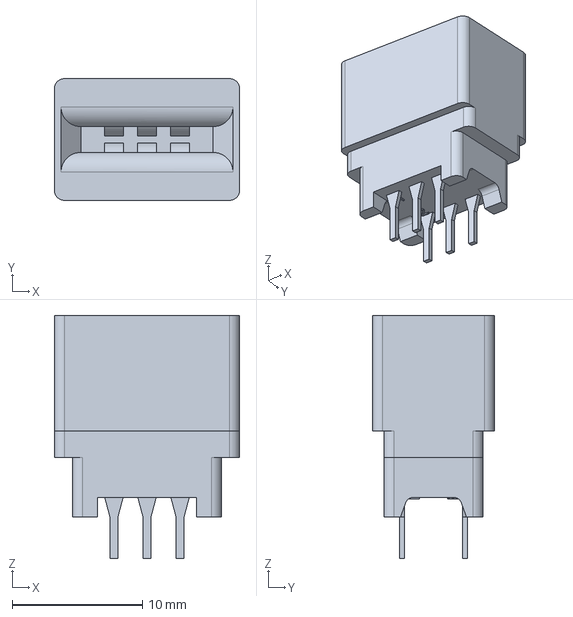
[picture p64: CAD file, 2023-11-05]
mounted-lib/3D/J_7-5530843-7_EDGE_SIDE.step
14.2 x 9.35 x 18.7 mm
