Mounted-project/AugMounted-electronics/mounted-lib/3D/BM04B-SRSS-TB.STEP

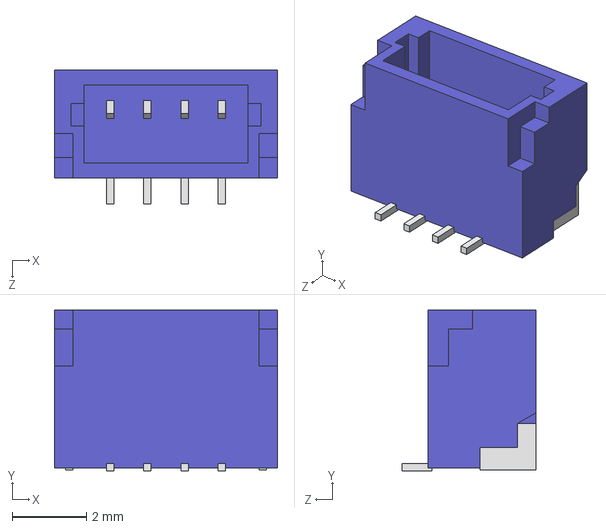
[picture p65: CAD file, 2023-11-05]
mounted-lib/3D/BM04B-SRSS-TB.STEP
6.00 x 4.32 x 3.60 mm
