Mounted-project/AugMounted-electronics/mounted-lib/3D/L_7447714101.step

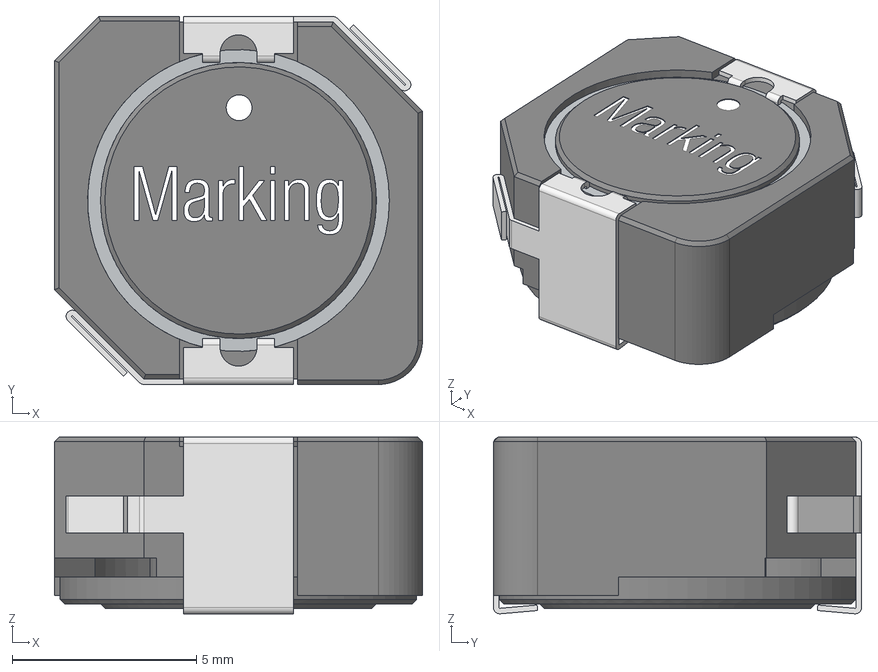
[picture p66: CAD file, 2023-11-05]
mounted-lib/3D/L_7447714101.step
10.0 x 10.0 x 4.80 mm
shielding ring
core
base x 2
glue
