Mounted-project/AugMounted-electronics/mounted-lib/3D/D_SOD-123_VISHAY.step

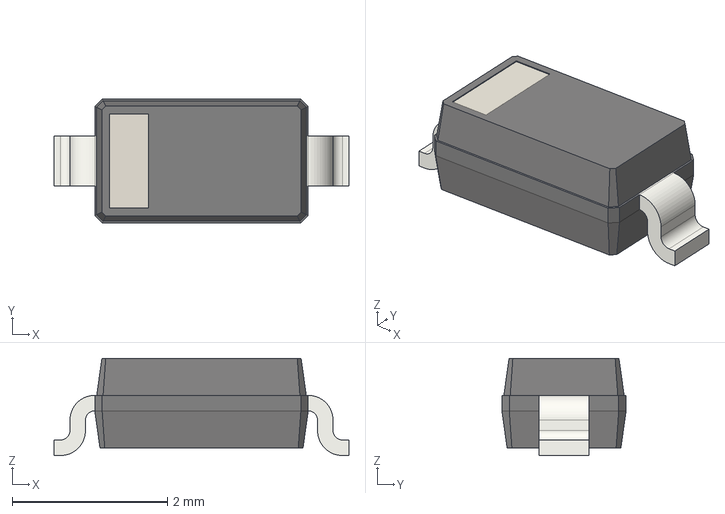
[picture p67: CAD file, 2023-11-05]
mounted-lib/3D/D_SOD-123_VISHAY.step
3.80 x 1.60 x 1.25 mm
