Mounted-project/AugMounted-electronics/mounted-lib/3D/D_SMA_BOURNS.step

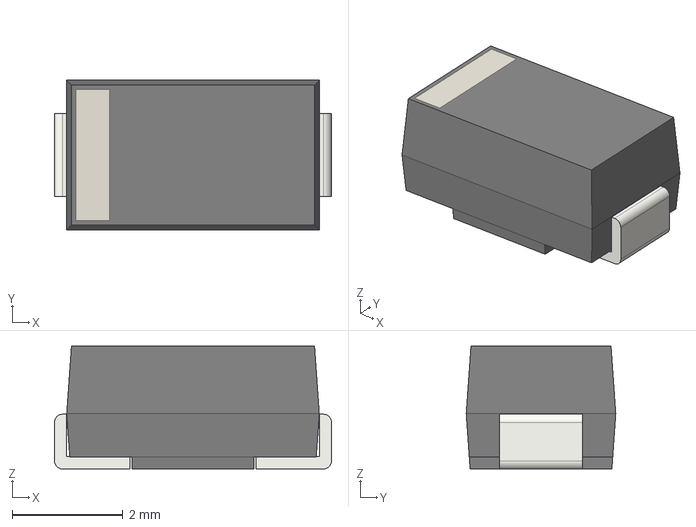
[picture p68: CAD file, 2023-11-05]
mounted-lib/3D/D_SMA_BOURNS.step
5.00 x 2.70 x 2.22 mm
