Mounted-project/AugMounted-electronics/mounted-lib/3D/J_217177-0001.step

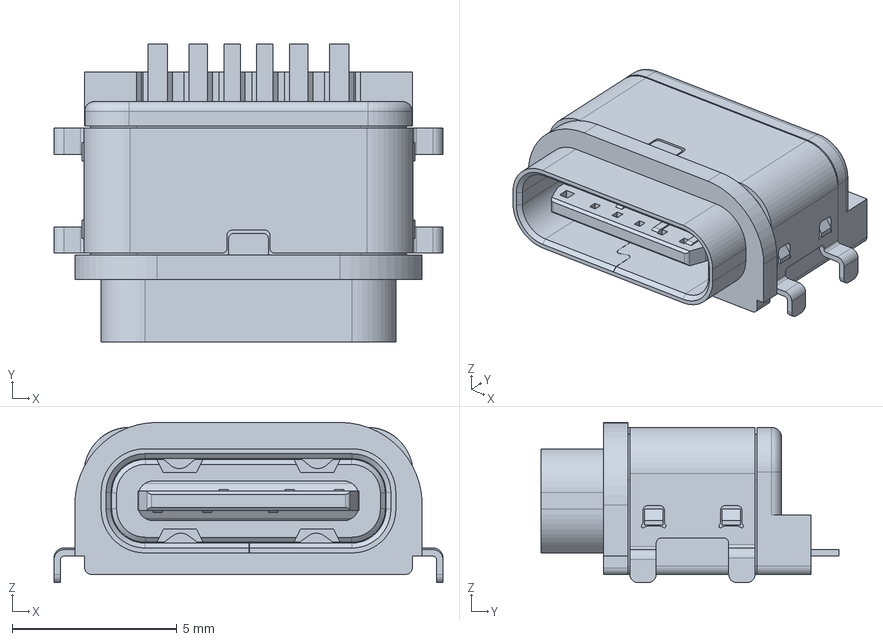
[picture p69: CAD file, 2023-11-05]
mounted-lib/3D/J_217177-0001.step
11.8 x 9.05 x 4.86 mm
