Mounted-project/AugMounted-electronics/mounted-lib/3D/HVSON-8.STEP

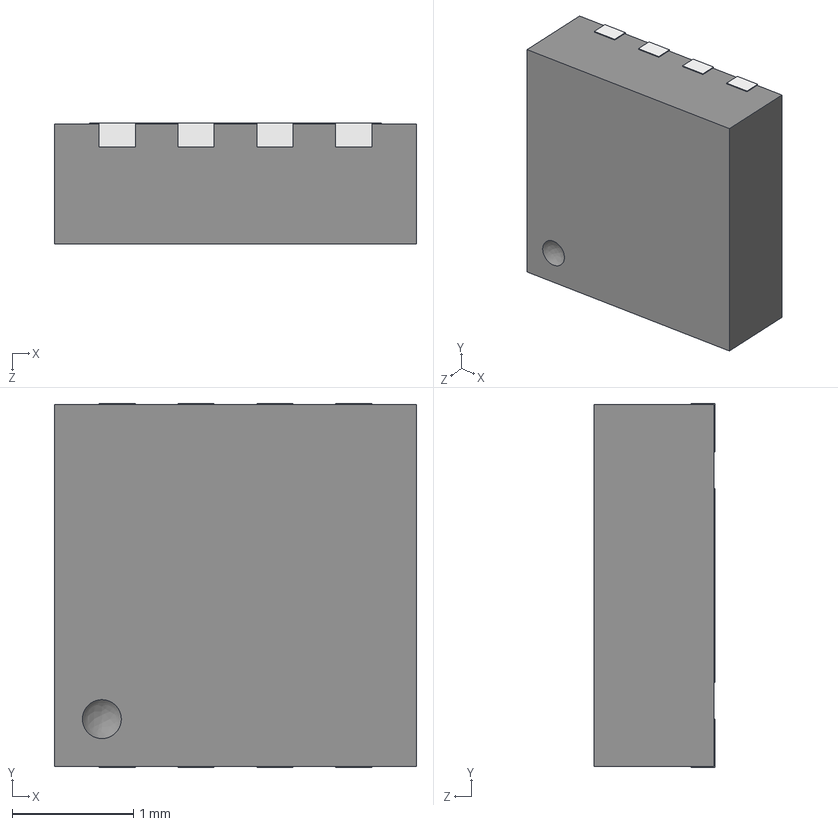
[picture p70: CAD file, 2023-11-05]
mounted-lib/3D/HVSON-8.STEP
2.98 x 3.00 x 1.00 mm
