Mounted-project/AugMounted-electronics/mounted-lib/3D/UDFN-8_MICROCHIP.step

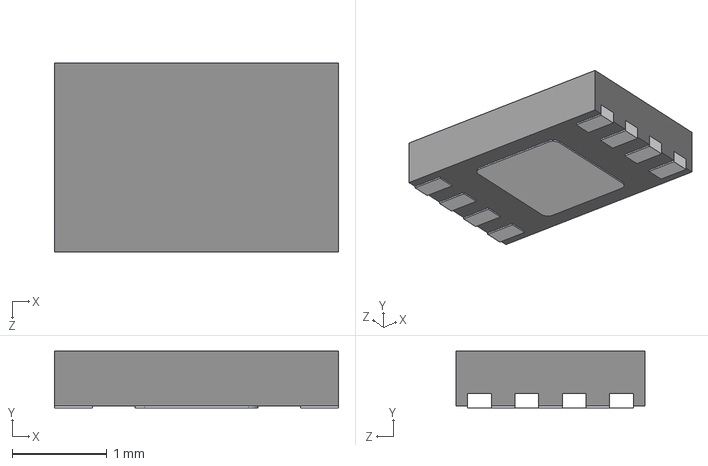
[picture p71: CAD file, 2023-11-05]
mounted-lib/3D/UDFN-8_MICROCHIP.step
3.00 x 0.6 x 2.00 mm
