Mounted-project/AugMounted-electronics/mounted-lib/3D/SOT-223-3_TabPin2_ONSEMI.step

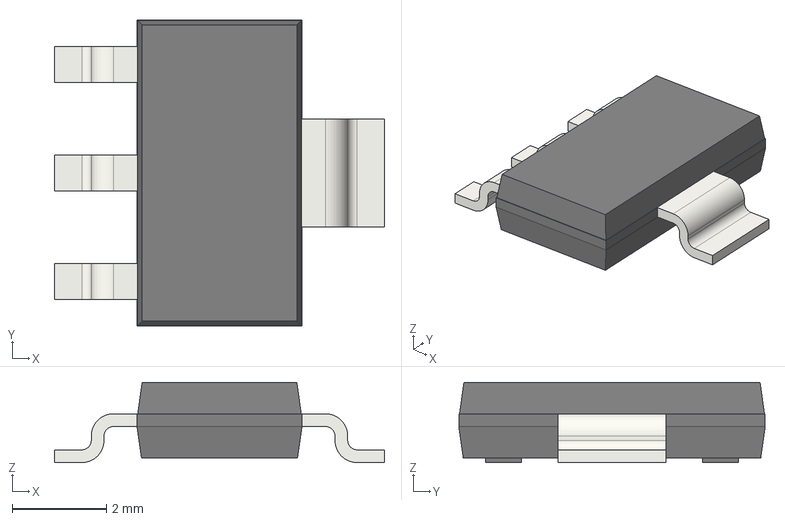
[picture p72: CAD file, 2023-11-05]
mounted-lib/3D/SOT-223-3_TabPin2_ONSEMI.step
7.00 x 6.50 x 1.70 mm
