Mounted-project/AugMounted-electronics/mounted-lib/3D/TYPE-C-31-M-13.STEP

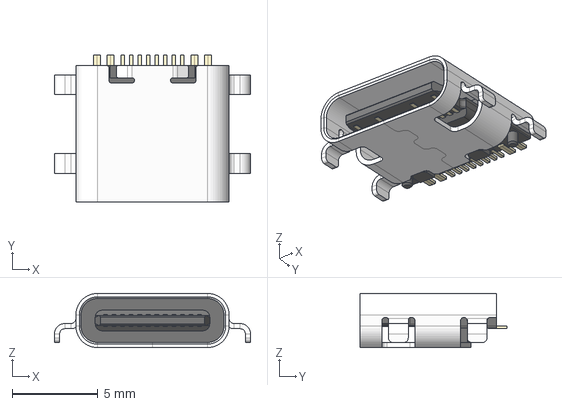
[picture p73: CAD file, 2023-11-05]
mounted-lib/3D/TYPE-C-31-M-13.STEP
11.5 x 8.56 x 3.16 mm
Shroud
Plastic Body & Connector
