Mounted-project/AugMounted-electronics/mounted-lib/3D/C_0805_2012Metric.step

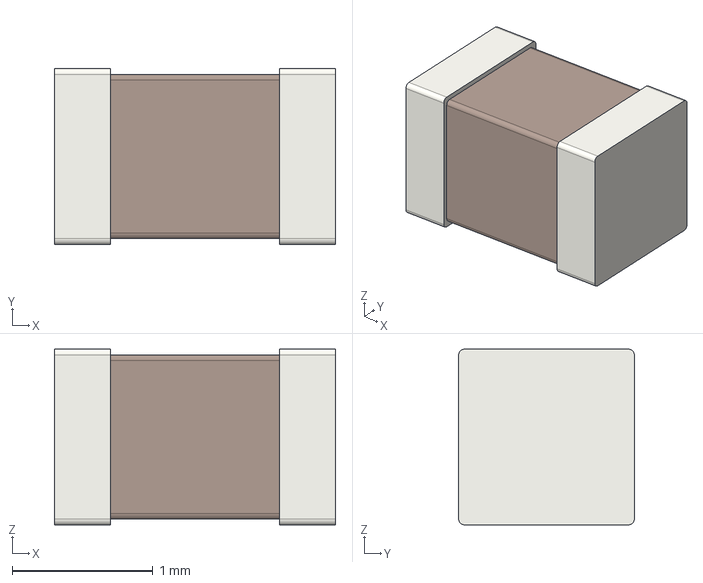
[picture p74: CAD file, 2023-11-05]
mounted-lib/3D/C_0805_2012Metric.step
2.00 x 1.25 x 1.25 mm
