Mounted-project/AugMounted-electronics/mounted-lib/3D/TSSOP-16-1EP_4.4x5mm_P0.65mm_TEXAS_INSTRUMENT.step

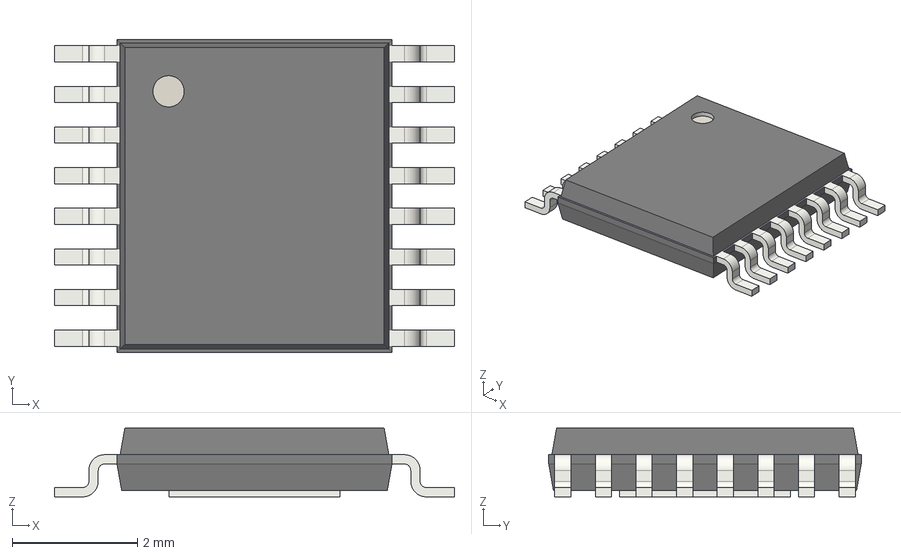
[picture p75: CAD file, 2023-11-05]
mounted-lib/3D/TSSOP-16-1EP_4.4x5mm_P0.65mm_TEXAS_INSTRUMENT.step
6.40 x 5.00 x 1.10 mm
