Mounted-project/AugMounted-electronics/mounted-lib/3D/J_XT60PB-F.step

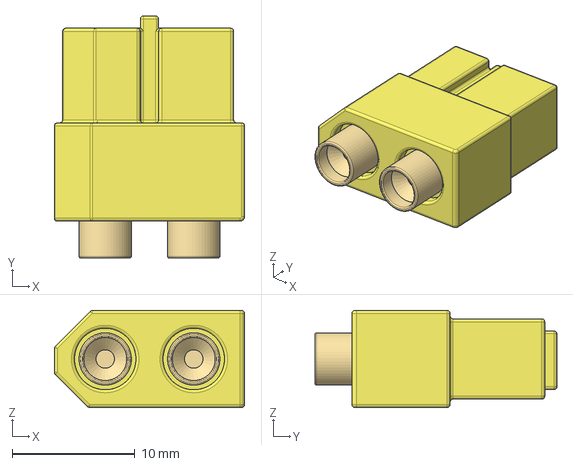
[picture p76: CAD file, 2023-11-05]
mounted-lib/3D/J_XT60PB-F.step
15.5 x 19.7 x 7.90 mm
