Mounted-project/AugMounted-electronics/mounted-lib/3D/SSOP-28_TERMINUS_TECH.step

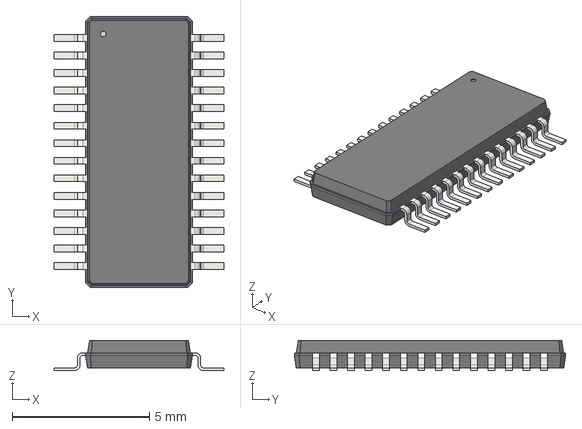
[picture p77: CAD file, 2023-11-05]
mounted-lib/3D/SSOP-28_TERMINUS_TECH.step
6.20 x 9.90 x 1.10 mm
