Mounted-project/AugMounted-electronics/mounted-lib/3D/L_PA5432.822NLT.step

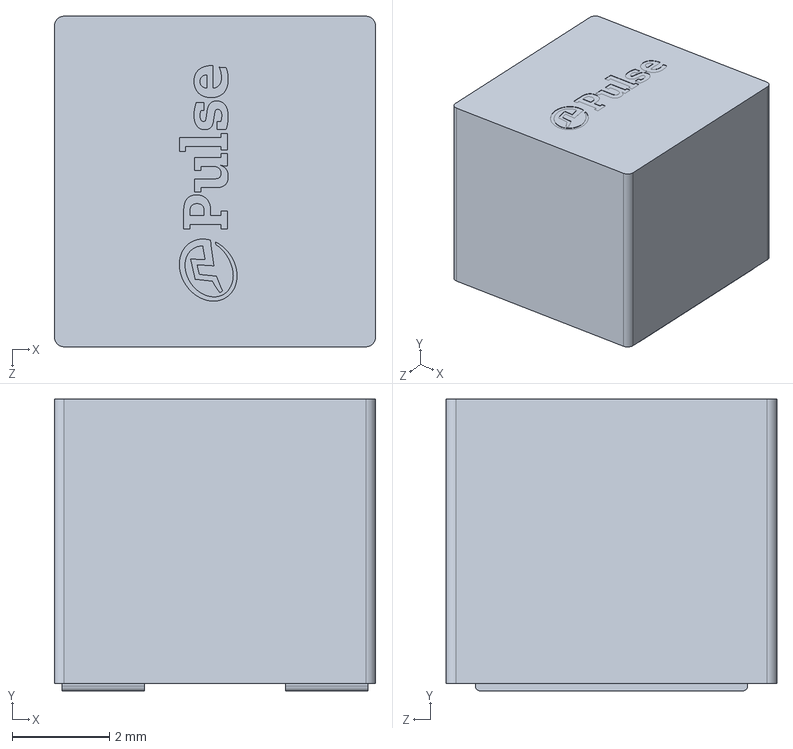
[picture p78: CAD file, 2023-11-05]
mounted-lib/3D/L_PA5432.822NLT.step
6.60 x 6.00 x 6.80 mm
