Mounted-project/AugMounted-electronics/mounted-lib/3D/R_0805_2012Metric.step

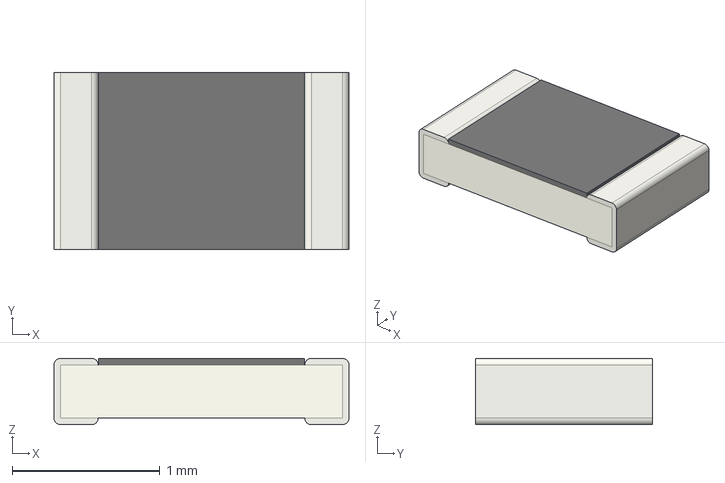
[picture p79: CAD file, 2023-11-05]
mounted-lib/3D/R_0805_2012Metric.step
2.00 x 1.20 x 0.45 mm
