Mounted-project/AugMounted-electronics/mounted-lib/3D/J_DWM-13-53-L-D-200.stp

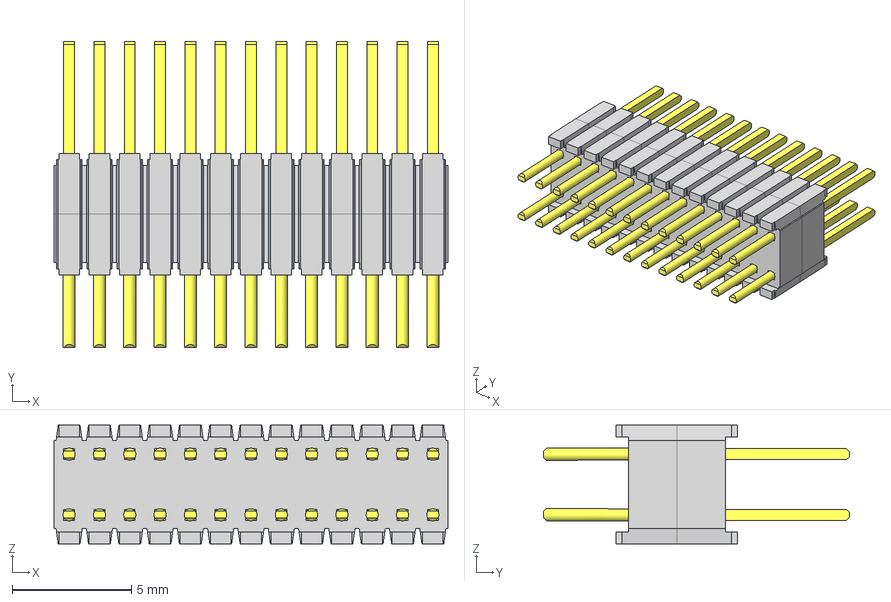
[picture p80: CAD file, 2023-11-05]
mounted-lib/3D/J_DWM-13-53-L-D-200.stp
16.5 x 12.8 x 4.98 mm
DWM-113-D_stacker x 2
T-1M6-13-53-D-200_DWM
