Mounted-project/AugMounted-electronics/mounted-lib/3D/HTSSOP-20_TEXAS_INSTRUMENT.step

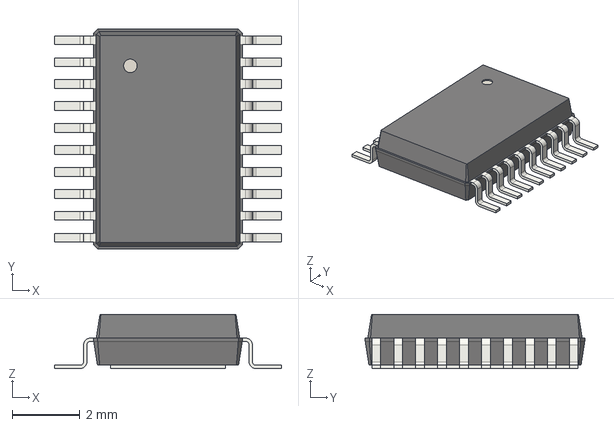
[picture p81: CAD file, 2023-11-05]
mounted-lib/3D/HTSSOP-20_TEXAS_INSTRUMENT.step
6.72 x 6.50 x 1.60 mm
