Mounted-project/AugMounted-electronics/mounted-lib/3D/SO6-4_TOSHIBA_11-4M1S.STEP

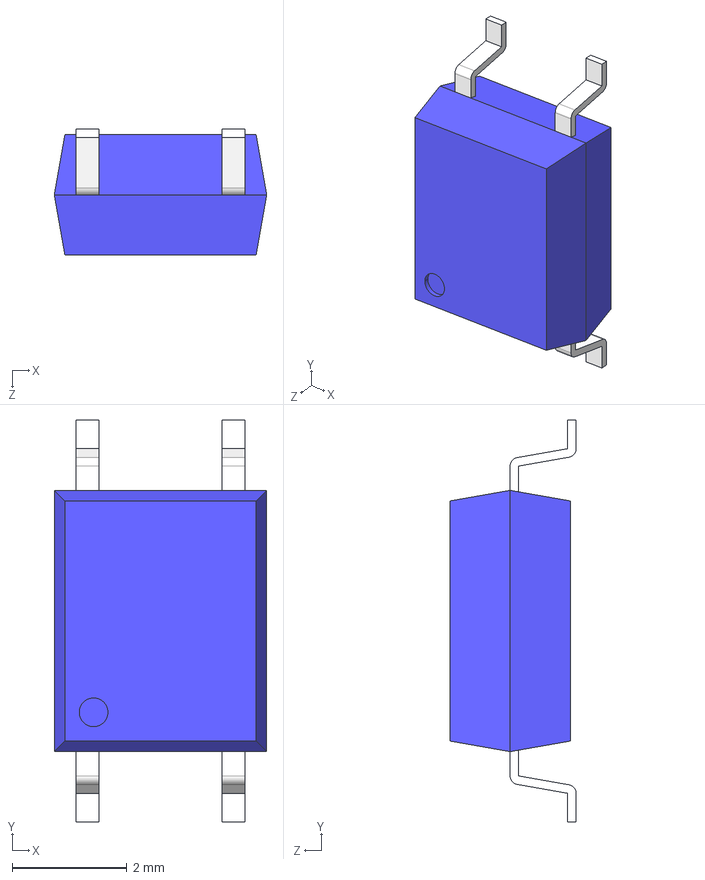
[picture p82: CAD file, 2023-11-05]
mounted-lib/3D/SO6-4_TOSHIBA_11-4M1S.STEP
3.70 x 7.00 x 2.20 mm
