Mounted-project/AugMounted-electronics/mounted-lib/3D/C_0402_1005Metric.step

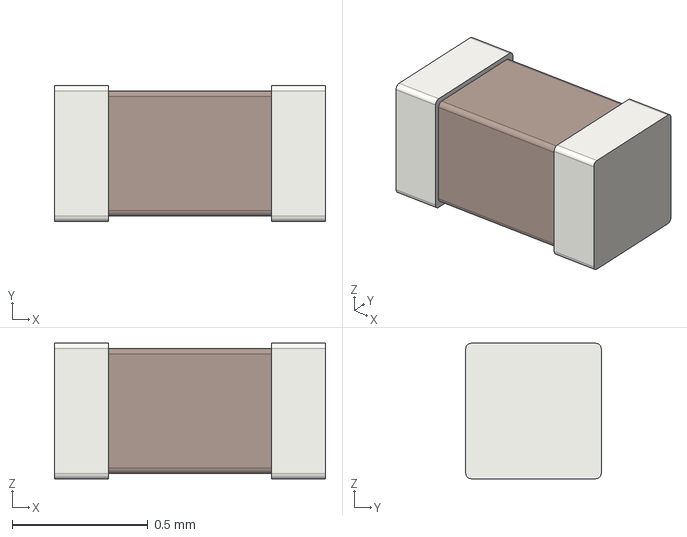
[picture p83: CAD file, 2023-11-05]
mounted-lib/3D/C_0402_1005Metric.step
1.00 x 0.5 x 0.5 mm
