Mounted-project/AugMounted-electronics/mounted-lib/3D/D_SMF_VISHAY.step

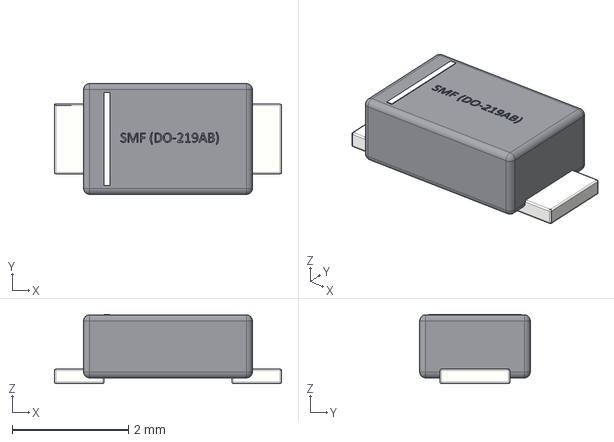
[picture p84: CAD file, 2023-11-05]
mounted-lib/3D/D_SMF_VISHAY.step
3.90 x 1.90 x 1.19 mm
