Mounted-project/AugMounted-electronics/mounted-lib/3D/HTSSOP-14-1EP_TI_PWP0014A.step

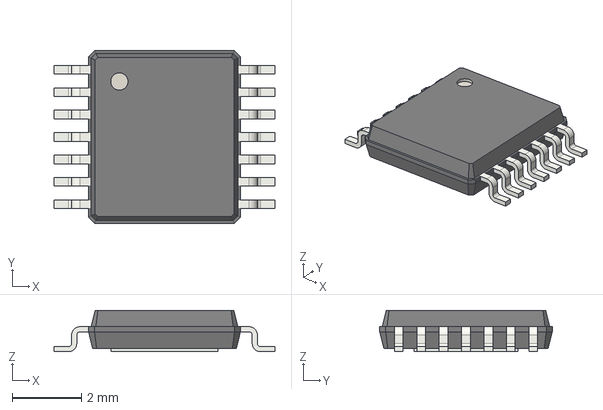
[picture p85: CAD file, 2023-11-05]
mounted-lib/3D/HTSSOP-14-1EP_TI_PWP0014A.step
6.40 x 5.00 x 1.20 mm
