Mounted-project/AugMounted-electronics/mounted-lib/3D/C_0201_0603Metric.step

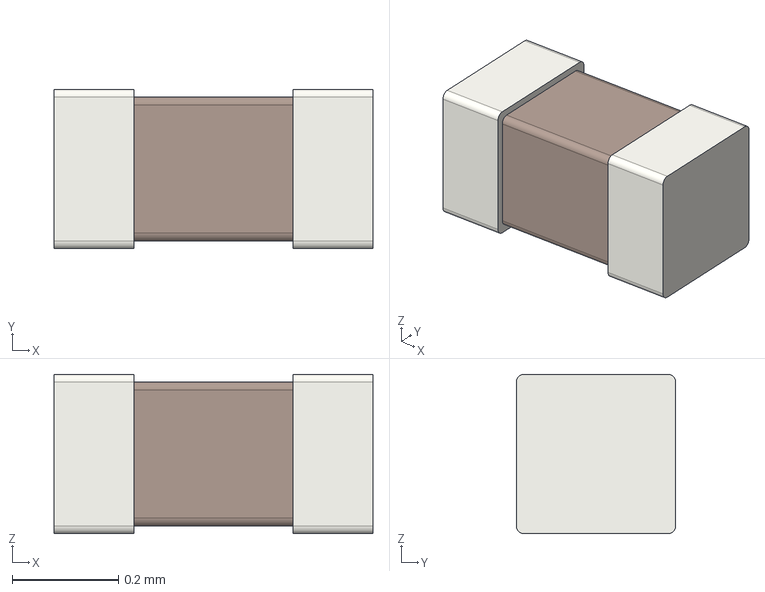
[picture p86: CAD file, 2023-11-05]
mounted-lib/3D/C_0201_0603Metric.step
0.6 x 0.3 x 0.3 mm
