Mounted-project/AugMounted-electronics/mounted-lib/3D/LFCSP-10_ANALOG_DEVICES.step

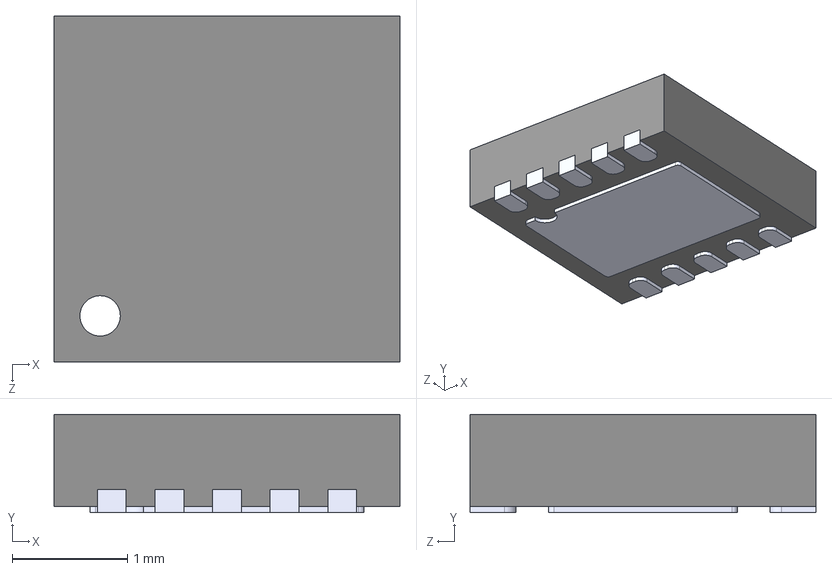
[picture p87: CAD file, 2023-11-05]
mounted-lib/3D/LFCSP-10_ANALOG_DEVICES.step
3.00 x 0.85 x 3.00 mm
