Mounted-project/AugMounted-electronics/mounted-lib/3D/F_2410_BELFUSE.step

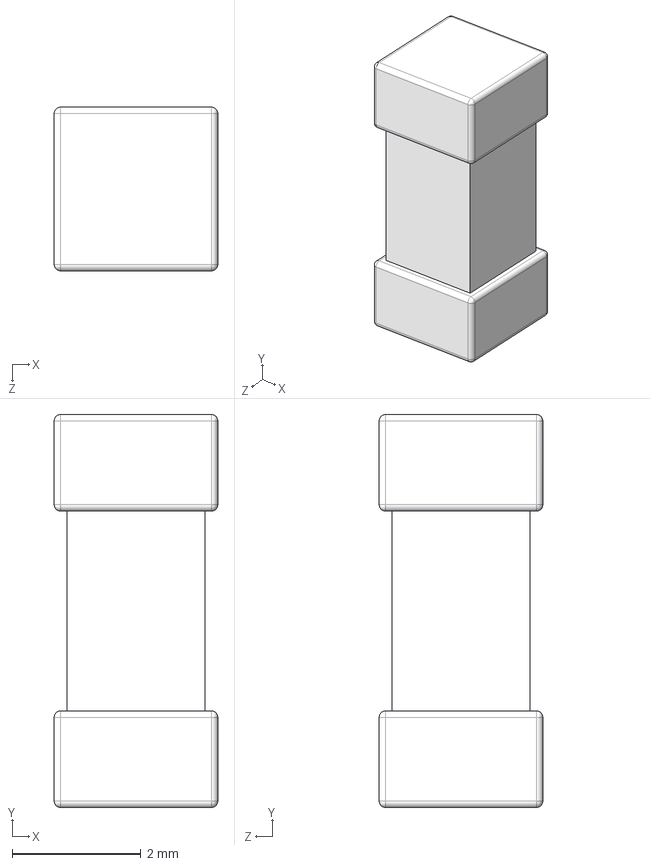
[picture p88: CAD file, 2023-11-05]
mounted-lib/3D/F_2410_BELFUSE.step
2.54 x 6.10 x 2.54 mm
