Mounted-project/AugMounted-electronics/mounted-lib/3D/R_0603_1608Metric.step

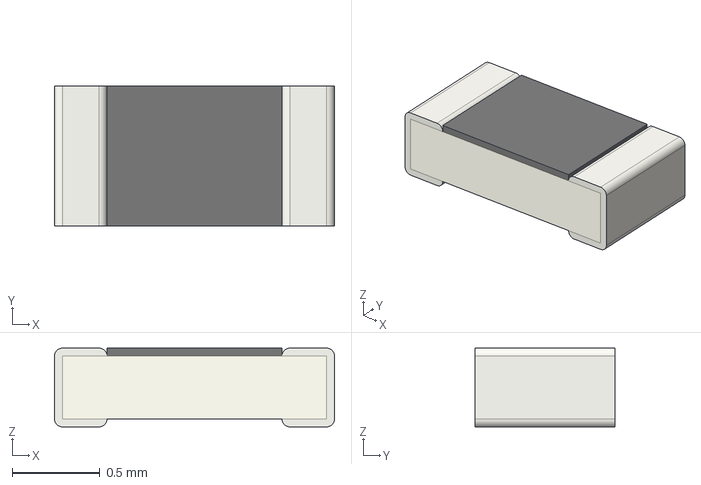
[picture p89: CAD file, 2023-11-05]
mounted-lib/3D/R_0603_1608Metric.step
1.60 x 0.8 x 0.45 mm
