Mounted-project/AugMounted-electronics/mounted-lib/3D/SPAN02C-05.step

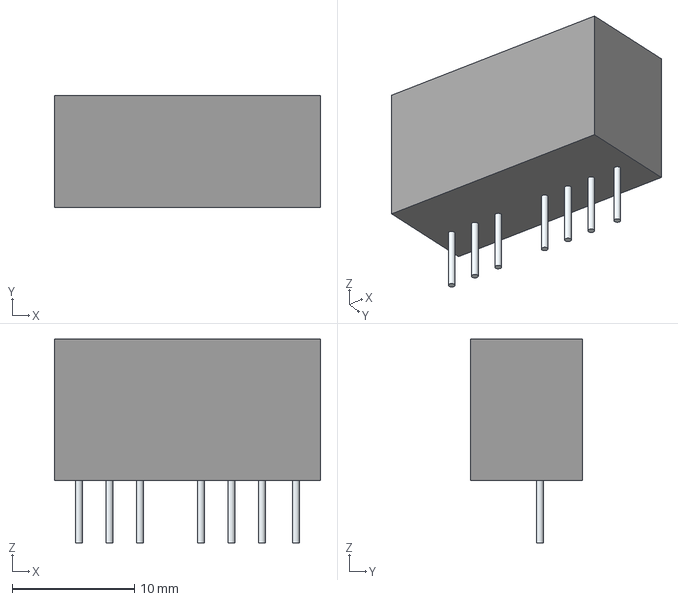
[picture p90: CAD file, 2023-11-05]
mounted-lib/3D/SPAN02C-05.step
21.8 x 9.20 x 16.7 mm
Leads
