Mounted-project/AugMounted-electronics/mounted-lib/3D/K_EE2-5NU.step

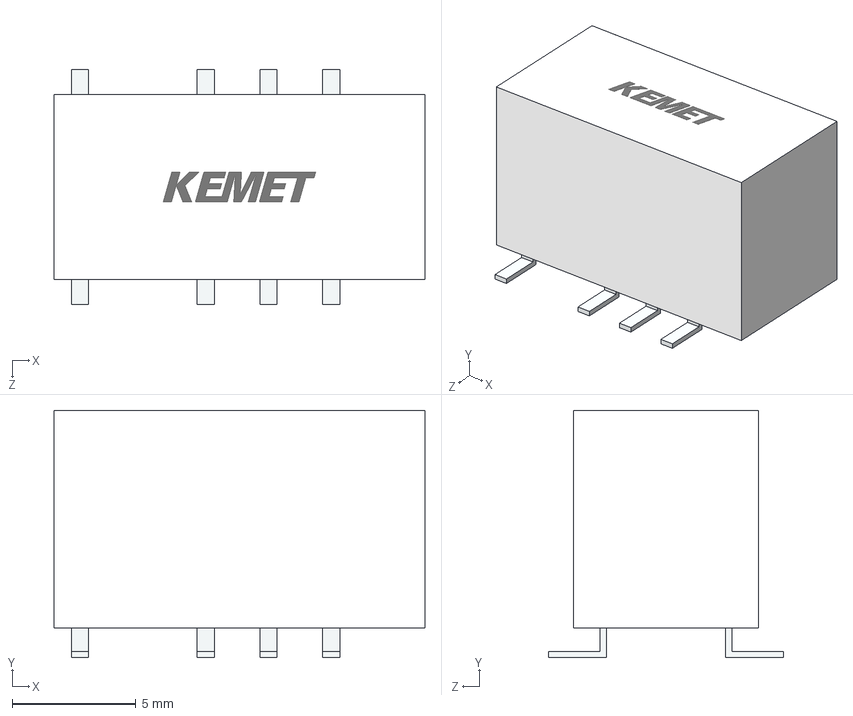
[picture p91: CAD file, 2023-11-05]
mounted-lib/3D/K_EE2-5NU.step
15.0 x 10.0 x 9.50 mm
