Mounted-project/AugMounted-electronics/mounted-lib/3D/SW_TL3360.step

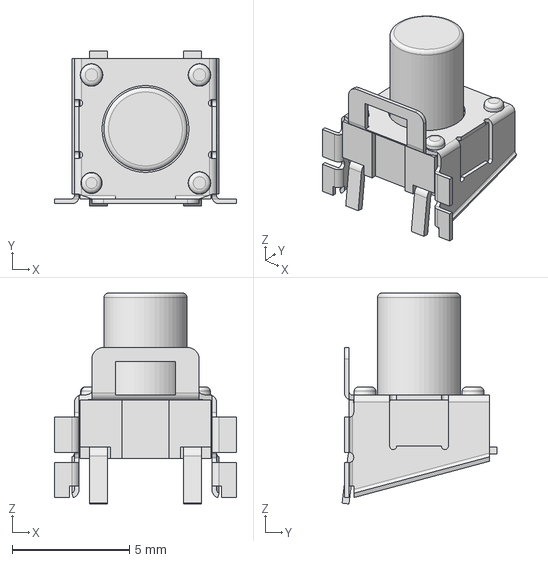
[picture p92: CAD file, 2023-11-05]
mounted-lib/3D/SW_TL3360.step
7.77 x 6.60 x 8.99 mm
