Mounted-project/AugMounted-electronics/mounted-lib/3D/C_1206_3216Metric.step

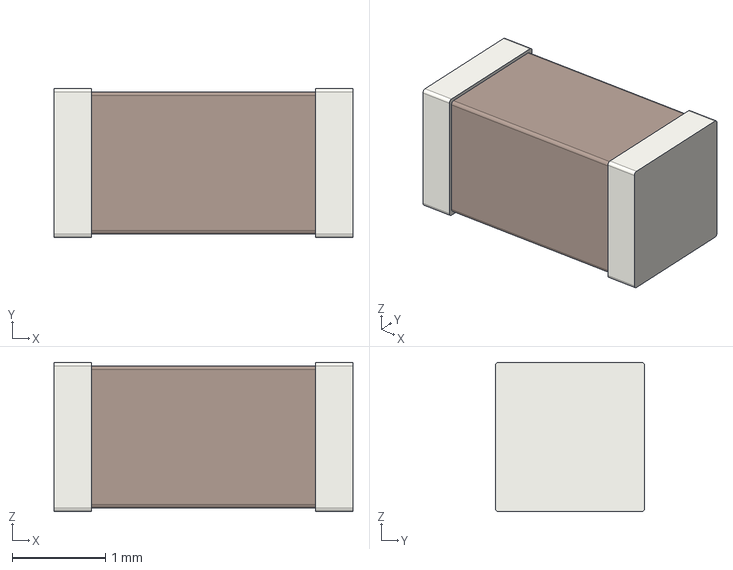
[picture p93: CAD file, 2023-11-05]
mounted-lib/3D/C_1206_3216Metric.step
3.20 x 1.60 x 1.60 mm
