Mounted-project/AugMounted-electronics/mounted-lib/3D/L_SRF2012A.step

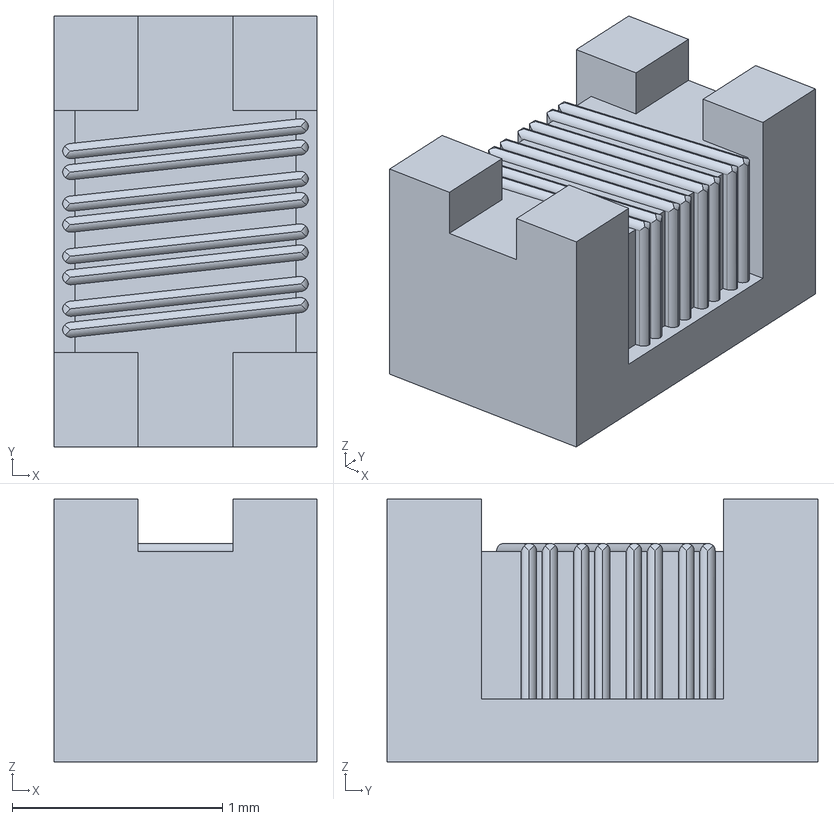
[picture p94: CAD file, 2023-11-05]
mounted-lib/3D/L_SRF2012A.step
1.25 x 2.05 x 1.25 mm
