Mounted-project/AugMounted-electronics/mounted-lib/3D/L_6xxx_MURATA.step

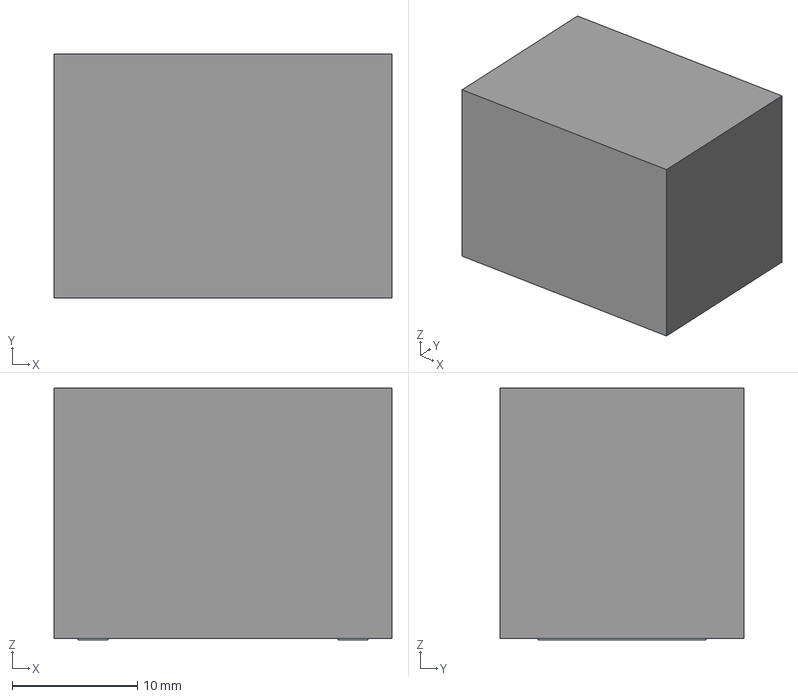
[picture p95: CAD file, 2023-11-05]
mounted-lib/3D/L_6xxx_MURATA.step
27.0 x 19.5 x 20.1 mm
Pins
