Mounted-project/AugMounted-electronics/mounted-lib/3D/CLX6F-FKC-CKNNQDGBB7A363 v2.step

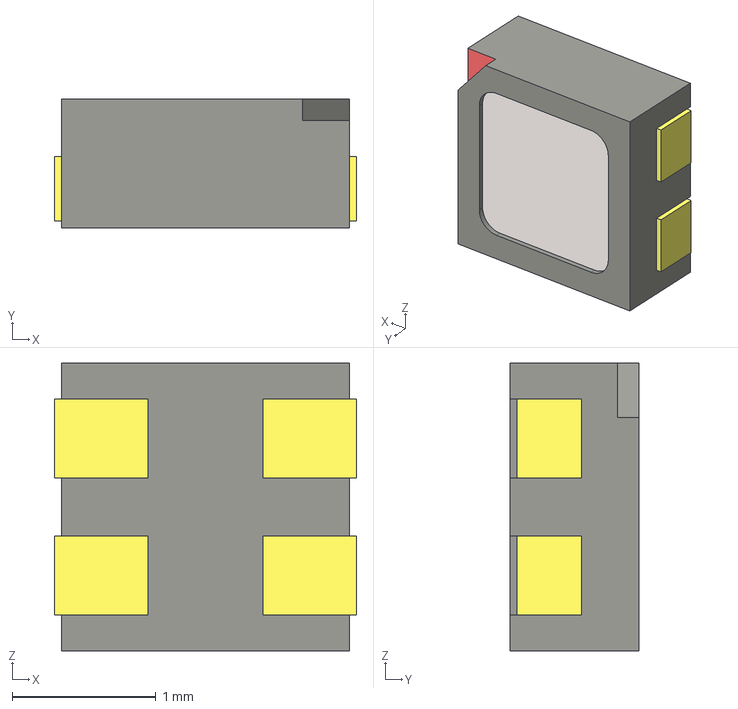
[picture p96: CAD file, 2023-11-05]
mounted-lib/3D/CLX6F-FKC-CKNNQDGBB7A363 v2.step
2.10 x 0.9 x 2.00 mm
