Mounted-project/AugMounted-electronics/mounted-lib/3D/LED_WS2812B.step

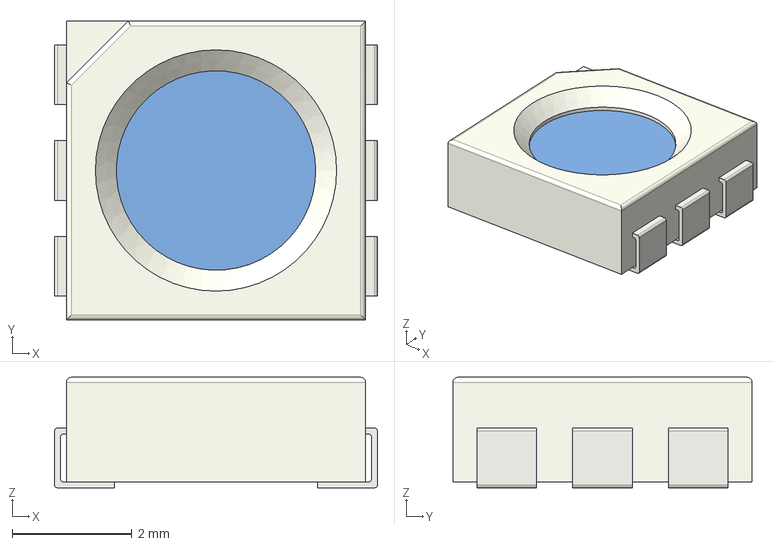
[picture p97: CAD file, 2023-11-05]
mounted-lib/3D/LED_WS2812B.step
5.40 x 5.00 x 1.85 mm
