Mounted-project/AugMounted-electronics/mounted-lib/3D/J_GROVE_SMD_STRAIGHT.step

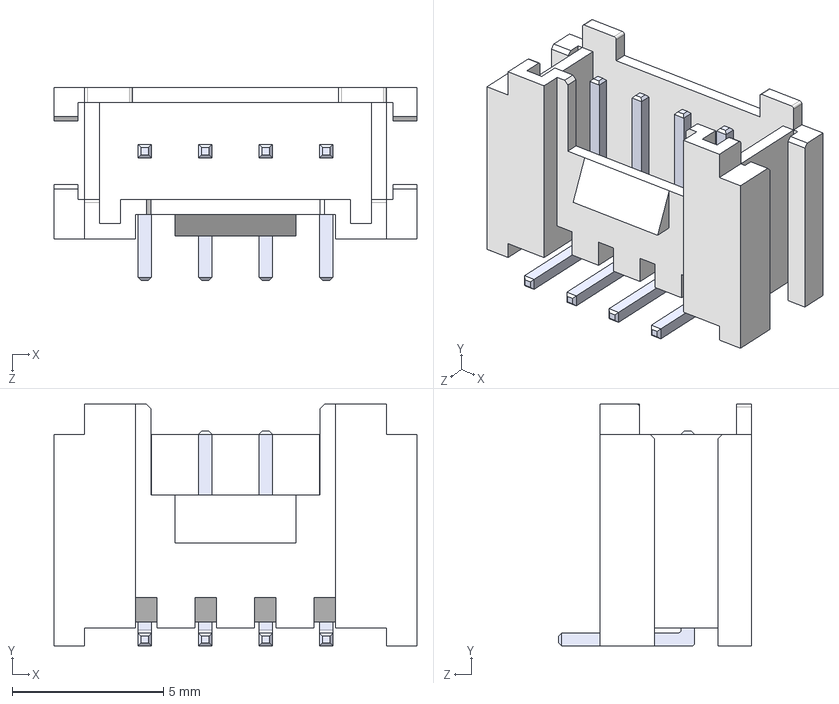
[picture p98: CAD file, 2023-11-05]
mounted-lib/3D/J_GROVE_SMD_STRAIGHT.step
12.0 x 8.00 x 6.38 mm
