Mounted-project/AugMounted-electronics/mounted-lib/3D/J_XT60PW-F.step

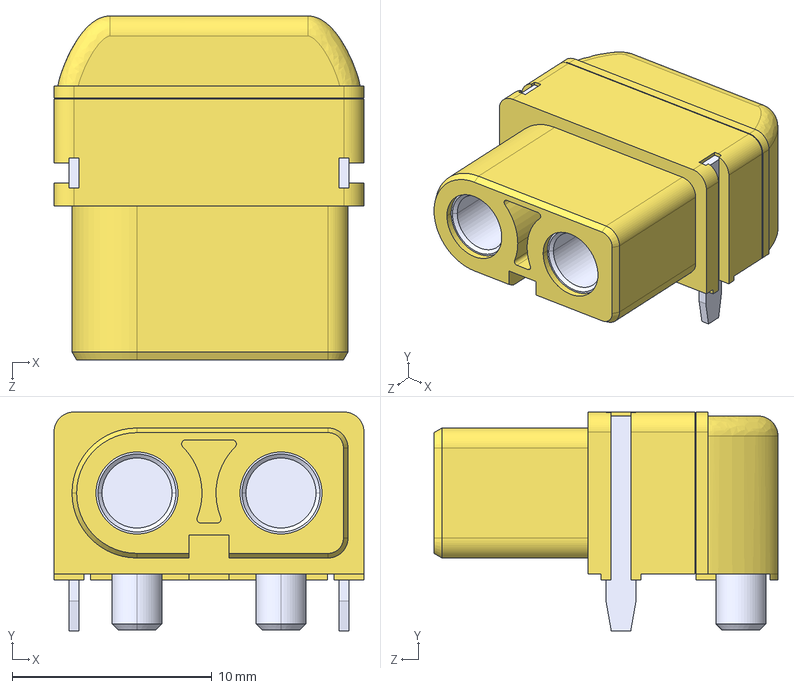
[picture p99: CAD file, 2023-11-05]
mounted-lib/3D/J_XT60PW-F.step
15.5 x 10.9 x 17.2 mm
