Mounted-project/AugMounted-electronics/mounted-lib/3D/SOT-23_TOSHIBA.step

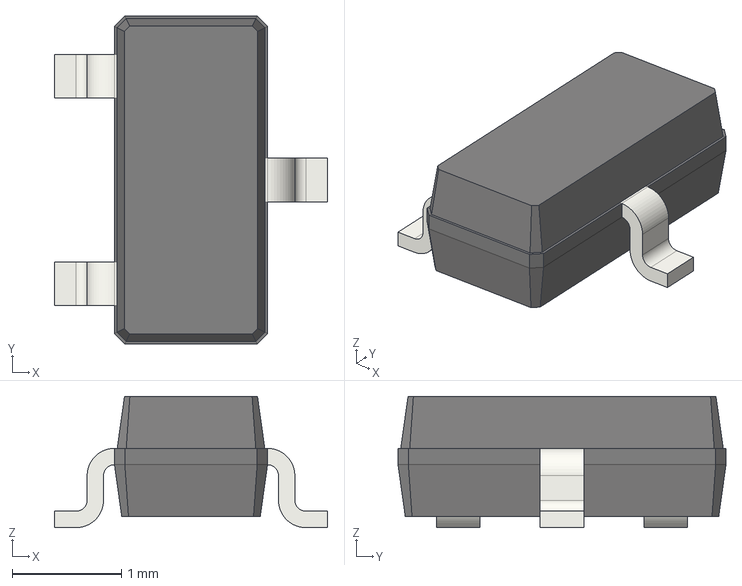
[picture p100: CAD file, 2023-11-05]
mounted-lib/3D/SOT-23_TOSHIBA.step
2.50 x 3.00 x 1.20 mm
