Mounted-project/AugMounted-electronics/mounted-lib/3D/J_62684-402100ALF.stp

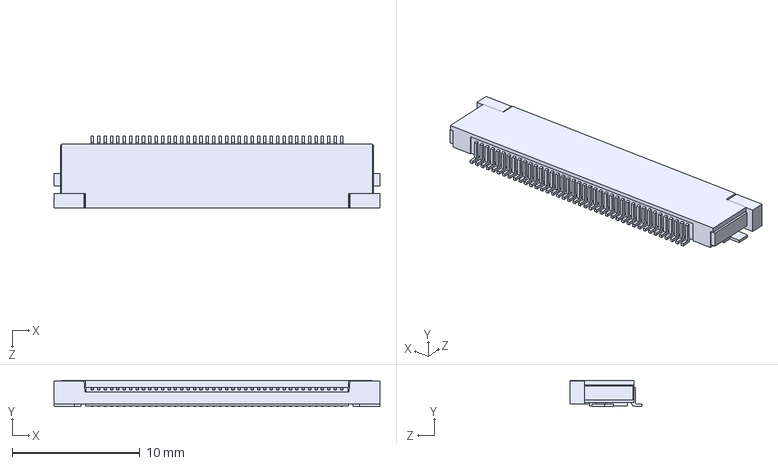
[picture p101: CAD file, 2023-11-05]
mounted-lib/3D/J_62684-402100ALF.stp
25.5 x 2.05 x 5.60 mm
