Mounted-project/AugMounted-electronics/mounted-lib/3D/J_ERF8-010-01-X-D-RA-XX.step

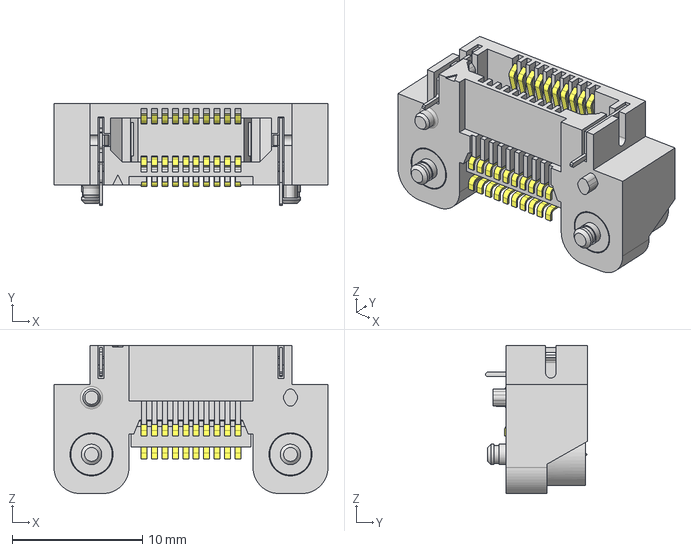
[picture p102: CAD file, 2023-11-05]
mounted-lib/3D/J_ERF8-010-01-X-D-RA-XX.step
21.0 x 7.80 x 11.3 mm
_ERF8-010-01-D-RA_terminal
_ERF8-010-01-D-RA_pin
