Mounted-project/AugMounted-electronics/mounted-lib/3D/BM02B-SRSS-TB.STEP

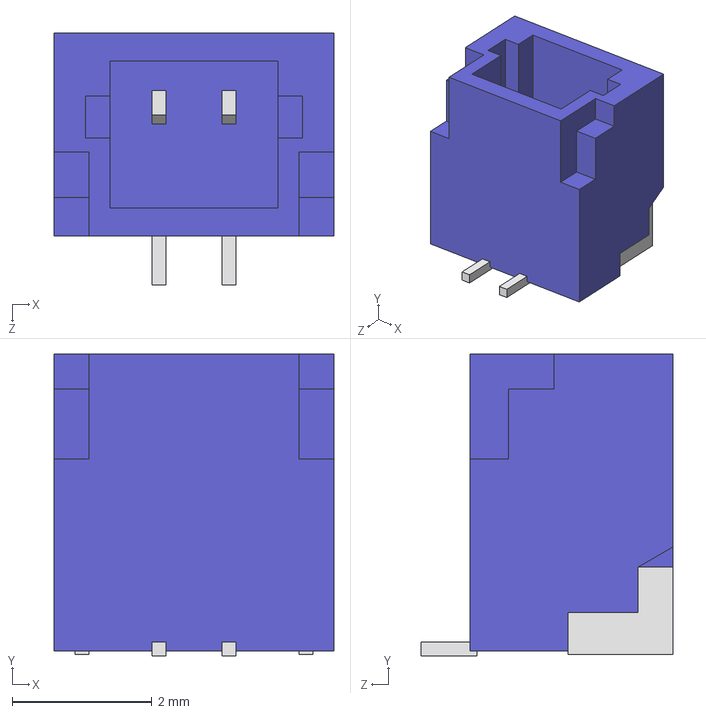
[picture p103: CAD file, 2023-11-05]
mounted-lib/3D/BM02B-SRSS-TB.STEP
4.00 x 4.32 x 3.60 mm
