Mounted-project/AugMounted-electronics/mounted-lib/3D/DFN-8_Microchip.step

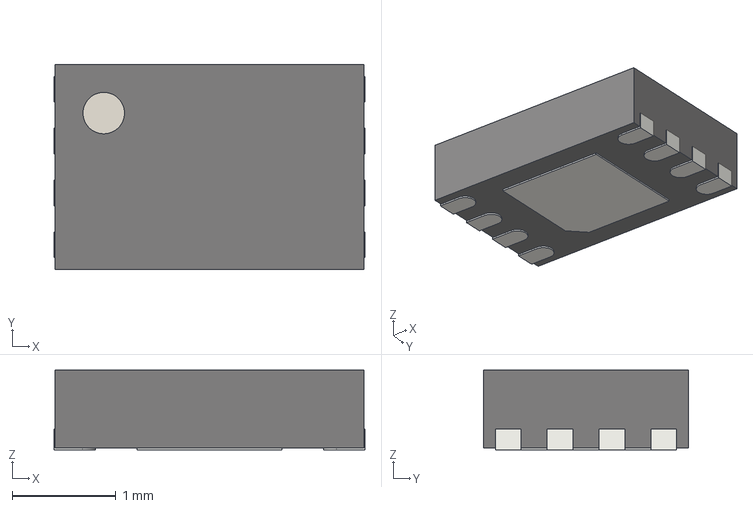
[picture p104: CAD file, 2023-11-05]
mounted-lib/3D/DFN-8_Microchip.step
3.00 x 1.98 x 0.77 mm
