Mounted-project/AugMounted-electronics/mounted-lib/3D/TSSOP-14_4.4x5mm_P0.65mm_MICROCHIP.step

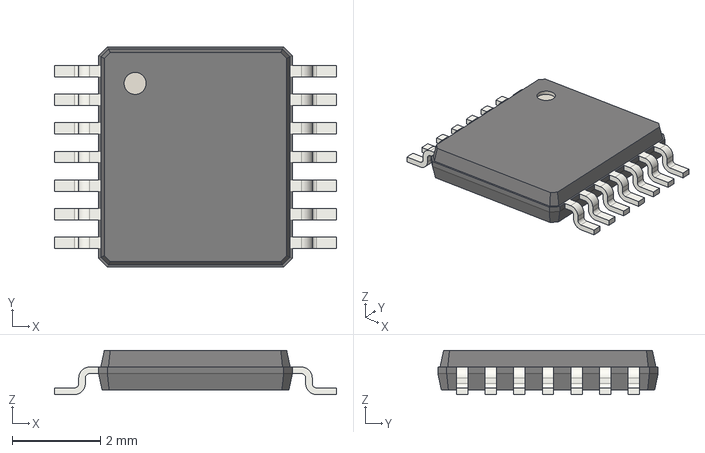
[picture p105: CAD file, 2023-11-05]
mounted-lib/3D/TSSOP-14_4.4x5mm_P0.65mm_MICROCHIP.step
6.40 x 5.00 x 1 mm
