Mounted-project/AugMounted-electronics/mounted-lib/3D/J_XT30UPB-F.step

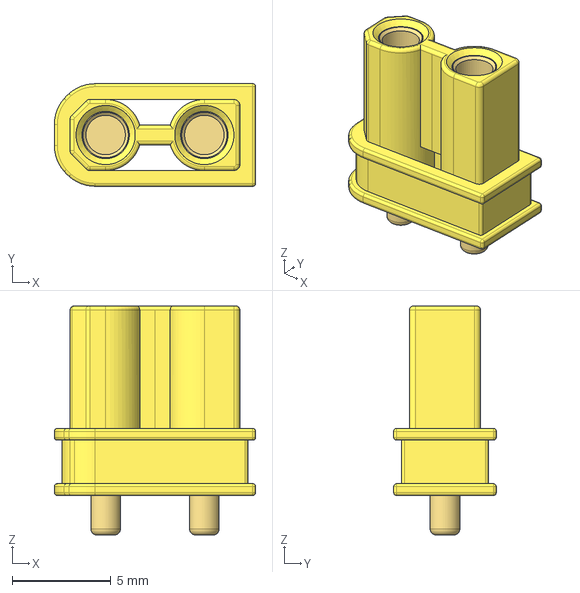
[picture p106: CAD file, 2023-11-05]
mounted-lib/3D/J_XT30UPB-F.step
10.2 x 5.20 x 11.6 mm
