Mounted-project/AugMounted-electronics/mounted-lib/3D/SSOP-20_5.3x7.2mm_P0.65mm.step

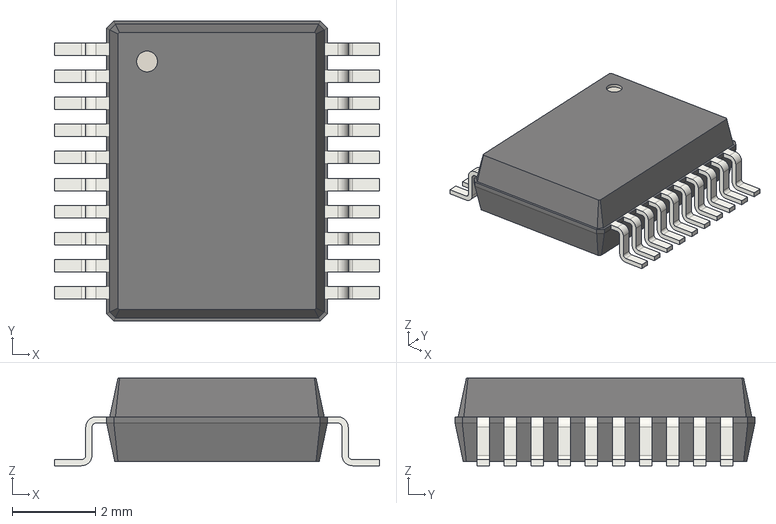
[picture p107: CAD file, 2023-11-05]
mounted-lib/3D/SSOP-20_5.3x7.2mm_P0.65mm.step
7.80 x 7.20 x 2.10 mm
