Mounted-project/AugMounted-electronics/mounted-lib/3D/J_XT60-M.STEP

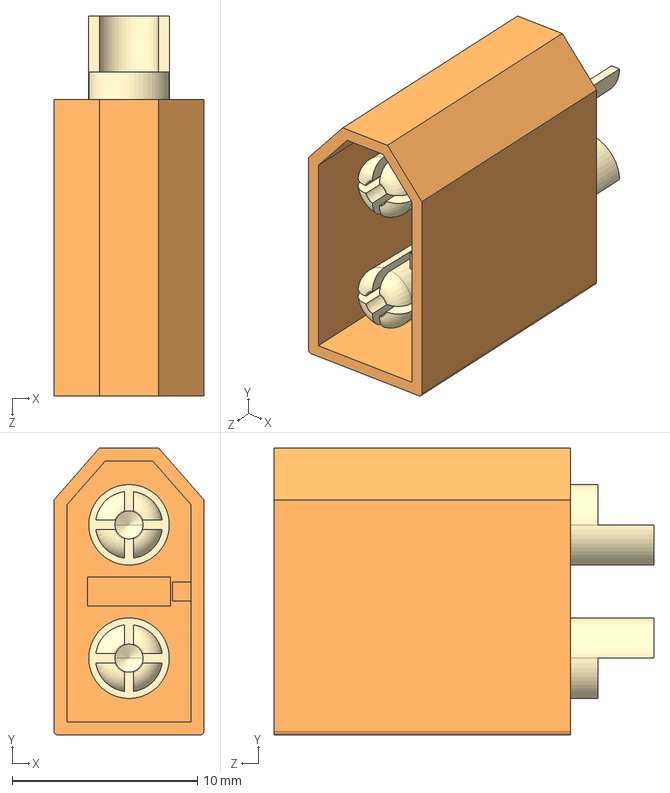
[picture p108: CAD file, 2023-11-05]
mounted-lib/3D/J_XT60-M.STEP
8.10 x 15.5 x 20.5 mm
