Mounted-project/AugMounted-electronics/mounted-lib/3D/SOIC-16_3.9x9.9mm_P1.27mm_NEXPERIA.step

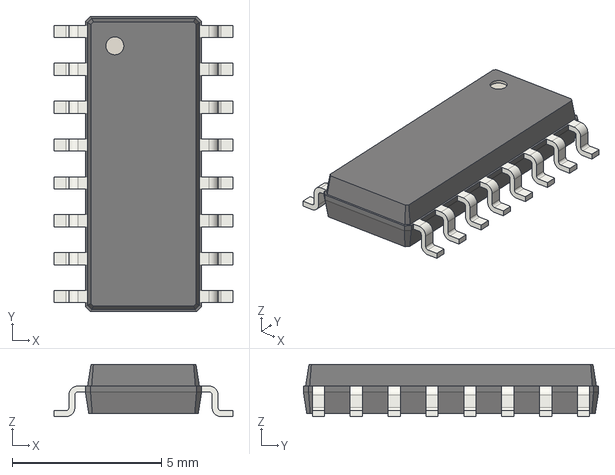
[picture p109: CAD file, 2023-11-05]
mounted-lib/3D/SOIC-16_3.9x9.9mm_P1.27mm_NEXPERIA.step
6.00 x 9.90 x 1.75 mm
