Mounted-project/AugMounted-electronics/mounted-lib/3D/J_RSM-113-02-L-D.step

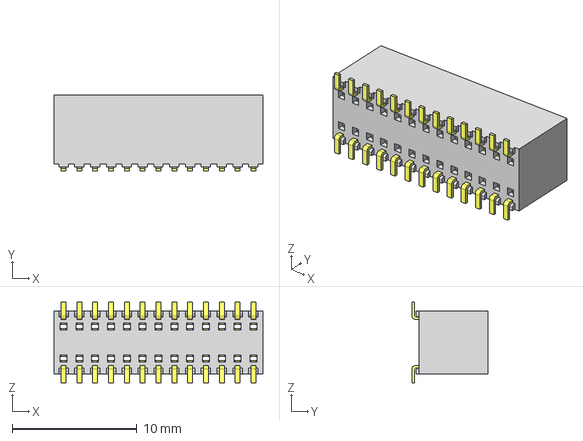
[picture p110: CAD file, 2023-11-05]
mounted-lib/3D/J_RSM-113-02-L-D.step
16.8 x 6.10 x 6.48 mm
_RSM-113-02-D_socket
_C-64-02-13-D
