Mounted-project/AugMounted-electronics/(list of files, cad)

Other CAD files:
mounted-lib/3D/QFN-24-1EP_4x4mm_P0.5mm_EP2.7x2.7mm_CYPRESS_SEMICON.step
mounted-lib/3D/68710814522.step
mounted-lib/3D/TFM252012ALMA1R0MTAA.step
