Mounted-project/AugMounted-electronics/R&D/HMI-PlugBoard_v1.0.0/02_OUTPUTS/02_PCB_ASSEMBLY/README.md

# CONFIDENTIAL

<p class="callout danger">The contents of this folder is confidential. Do not distribute outside of Gouach without permission.</p>

# CONTENT

This folder contains the board assembly files for Gouach's manufacturing team:
- Bill Of Materials (BOM)
  - **- STRICTLY CONFIDENTIAL**, NEVER DISCLOSE TO BOARD MANUFACTURERS, CLIENTS... KEEP INTERNAL -
  - Named like: BOM_Contact_Blackpack_13s4p_v1.1.0_2022-10-02.xlsx (or csv...)
- PnP placement files
  - **- STRICTLY CONFIDENTIAL**
  - Named like: PKP_Contact_Blackpack_13s4p_v1.1.0_2022-10-02-top/-bottom.pos (top)
- Assembly drawing PDF
  - -> "F.Fab" and "B.Fab" layers + "Edge.Cuts" showing all the component Refs to help in the assembly process
  - Named like: ASSEMBLY_Contact_Blackpack_13s4p_v1.1.0_2022-10-02.pdf
