Mounted-project/AugMounted-electronics/R&D/Zoka-PlugBoard_v1.0.0/01_SOURCES/Zoka-PlugBoard.kicad_pcb

## KiCad design R&D/Zoka-PlugBoard_v1.0.0/01_SOURCES/Zoka-PlugBoard.kicad_pcb (2024-01-17)

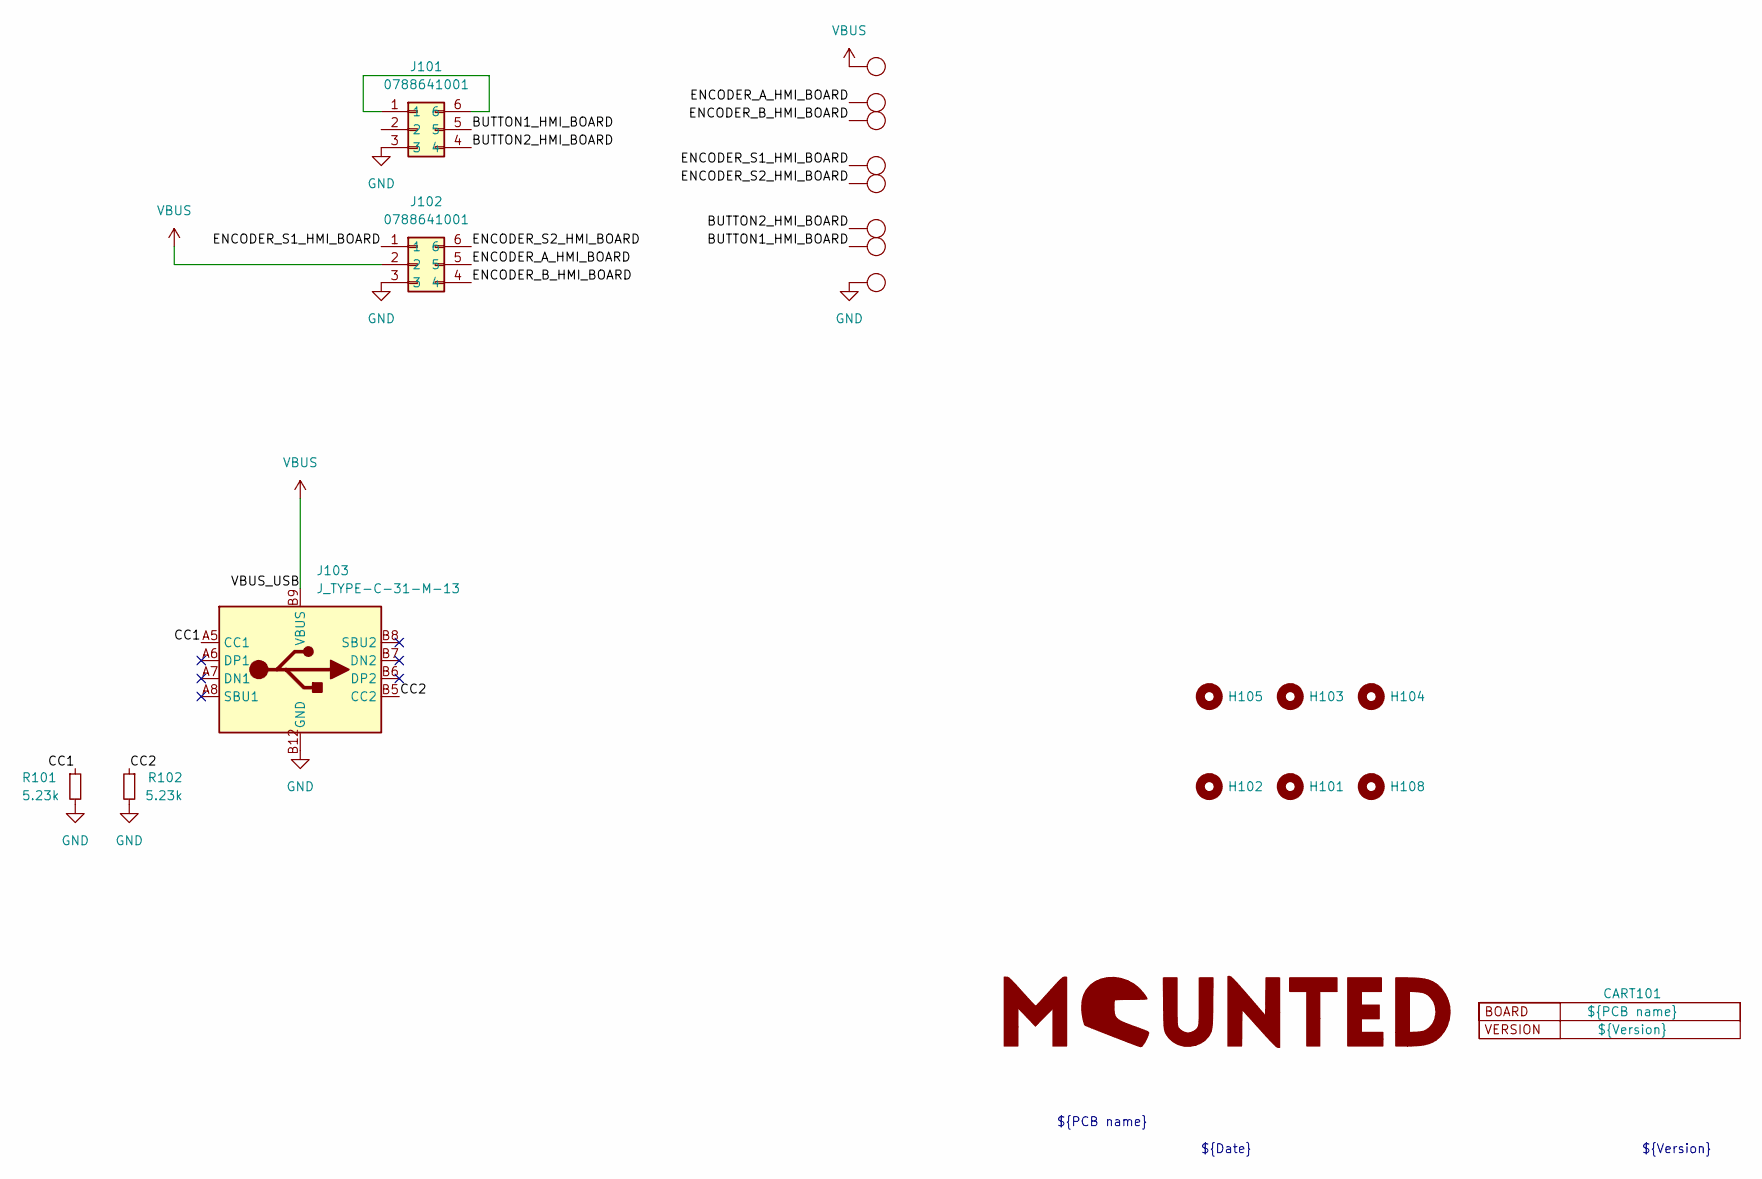
[picture p111: schematic Zoka-PlugBoard.kicad_sch]

Parts:
CART101: Cartouche_IO
H101, H102, H103, H104, H105, H108: H_MOUNTING_HOLE_M1; MountingHole_1.2mm_M1
J101, J102: J_0788641001; J_788641001; MPN 0788641001
J103: J_TYPE-C-31-M-13; MPN TYPE-C-31-M-13
LOGO101: mounted_logo
R101, R102: R_0603_5.23k_1%_0.1W; R_0402_1005Metric; Tolerance 1%
TP101, TP102, TP103, TP104, TP105, TP106, TP107, TP108: TESTPOINT_1.5MM

Connections:
/BUTTON1_HMI_BOARD: J101.5, TP106.1
/BUTTON2_HMI_BOARD: J101.4, TP105.1
/CC1: J103.A5 (CC1), R101.1
/CC2: J103.B5 (CC2), R102.1
/ENCODER_A_HMI_BOARD: J102.5, TP101.1
/ENCODER_B_HMI_BOARD: J102.4, TP102.1
/ENCODER_S1_HMI_BOARD: J102.1, TP103.1
/ENCODER_S2_HMI_BOARD: J102.6, TP104.1
GND: J101.3, J102.3, J103.A1 (GND), J103.A12 (GND), J103.B1 (GND), J103.B12 (GND), J103.GND, R101.2, R102.2, TP107.1
unnamed: J101.1, J101.6
VBUS: J102.2, J103.A4 (VBUS), J103.A9 (VBUS), J103.B4 (VBUS), J103.B9 (VBUS), TP108.1

Notes on the sheet:
${PCB name}
${Date}
${Version}

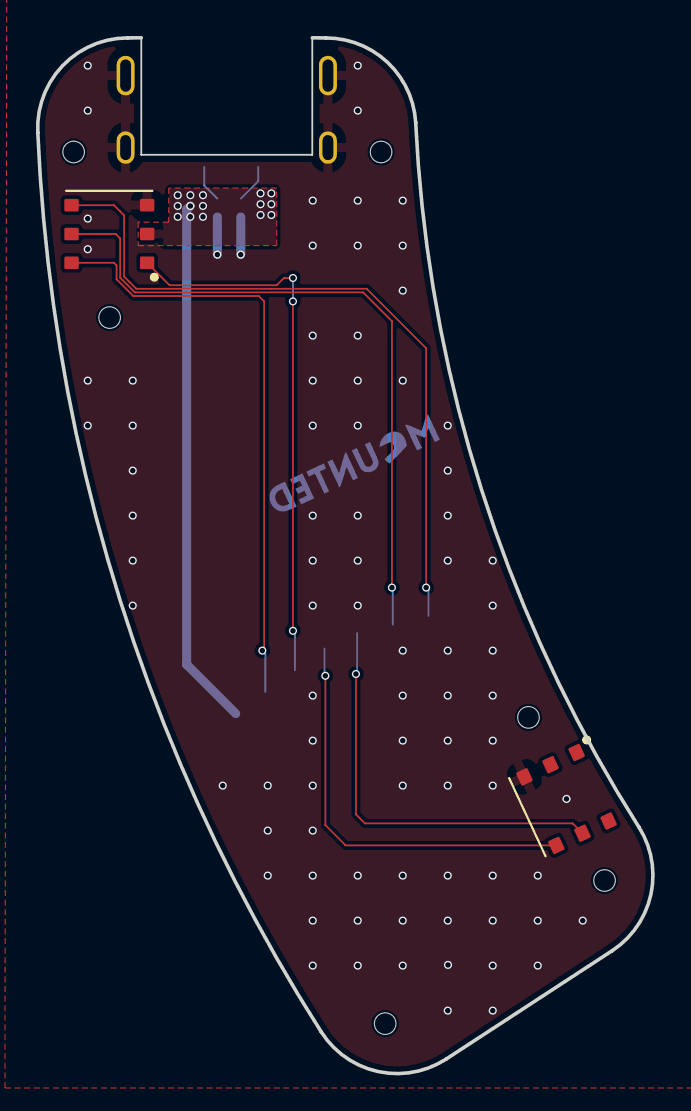
[picture p112: board Zoka-PlugBoard.kicad_pcb from above]

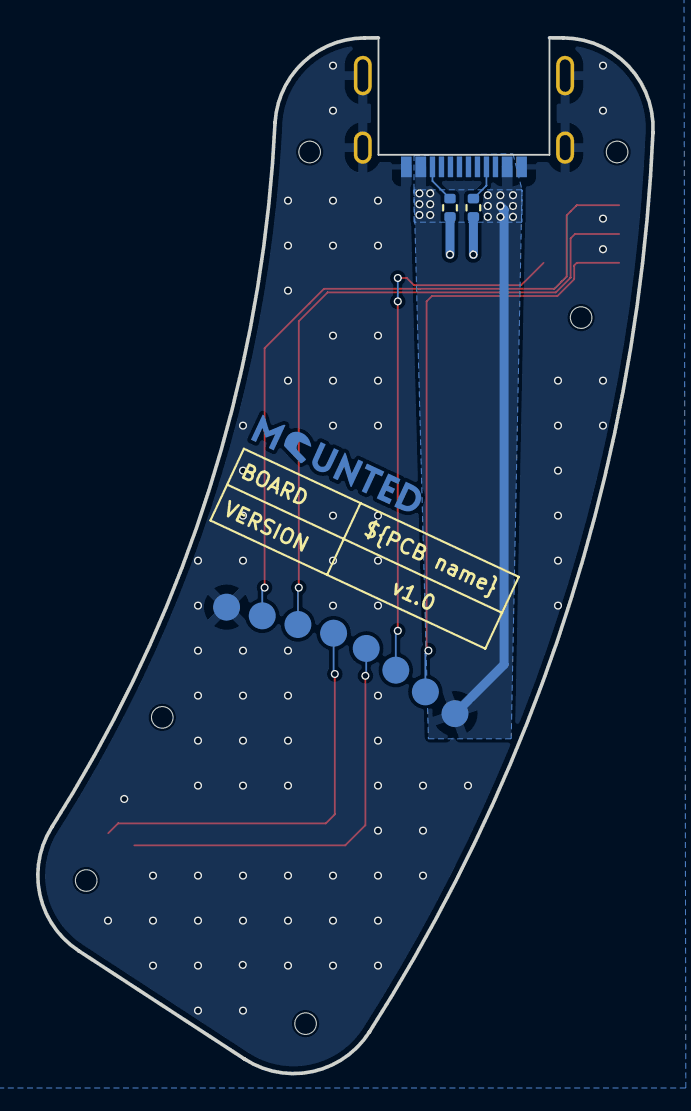
[picture p113: board Zoka-PlugBoard.kicad_pcb from below]

Board: 4 copper layers, 34.2 x 57.5 mm, 21 parts (13 on the bottom side), 11 nets.
