Mounted-project/AugMounted-electronics/R&D/Zoka-MainBoard_v1.0.0/01_SOURCES/Zoka-MainBoard.kicad_pcb

## KiCad design R&D/Zoka-MainBoard_v1.0.0/01_SOURCES/Zoka-MainBoard.kicad_pcb (2024-01-17)

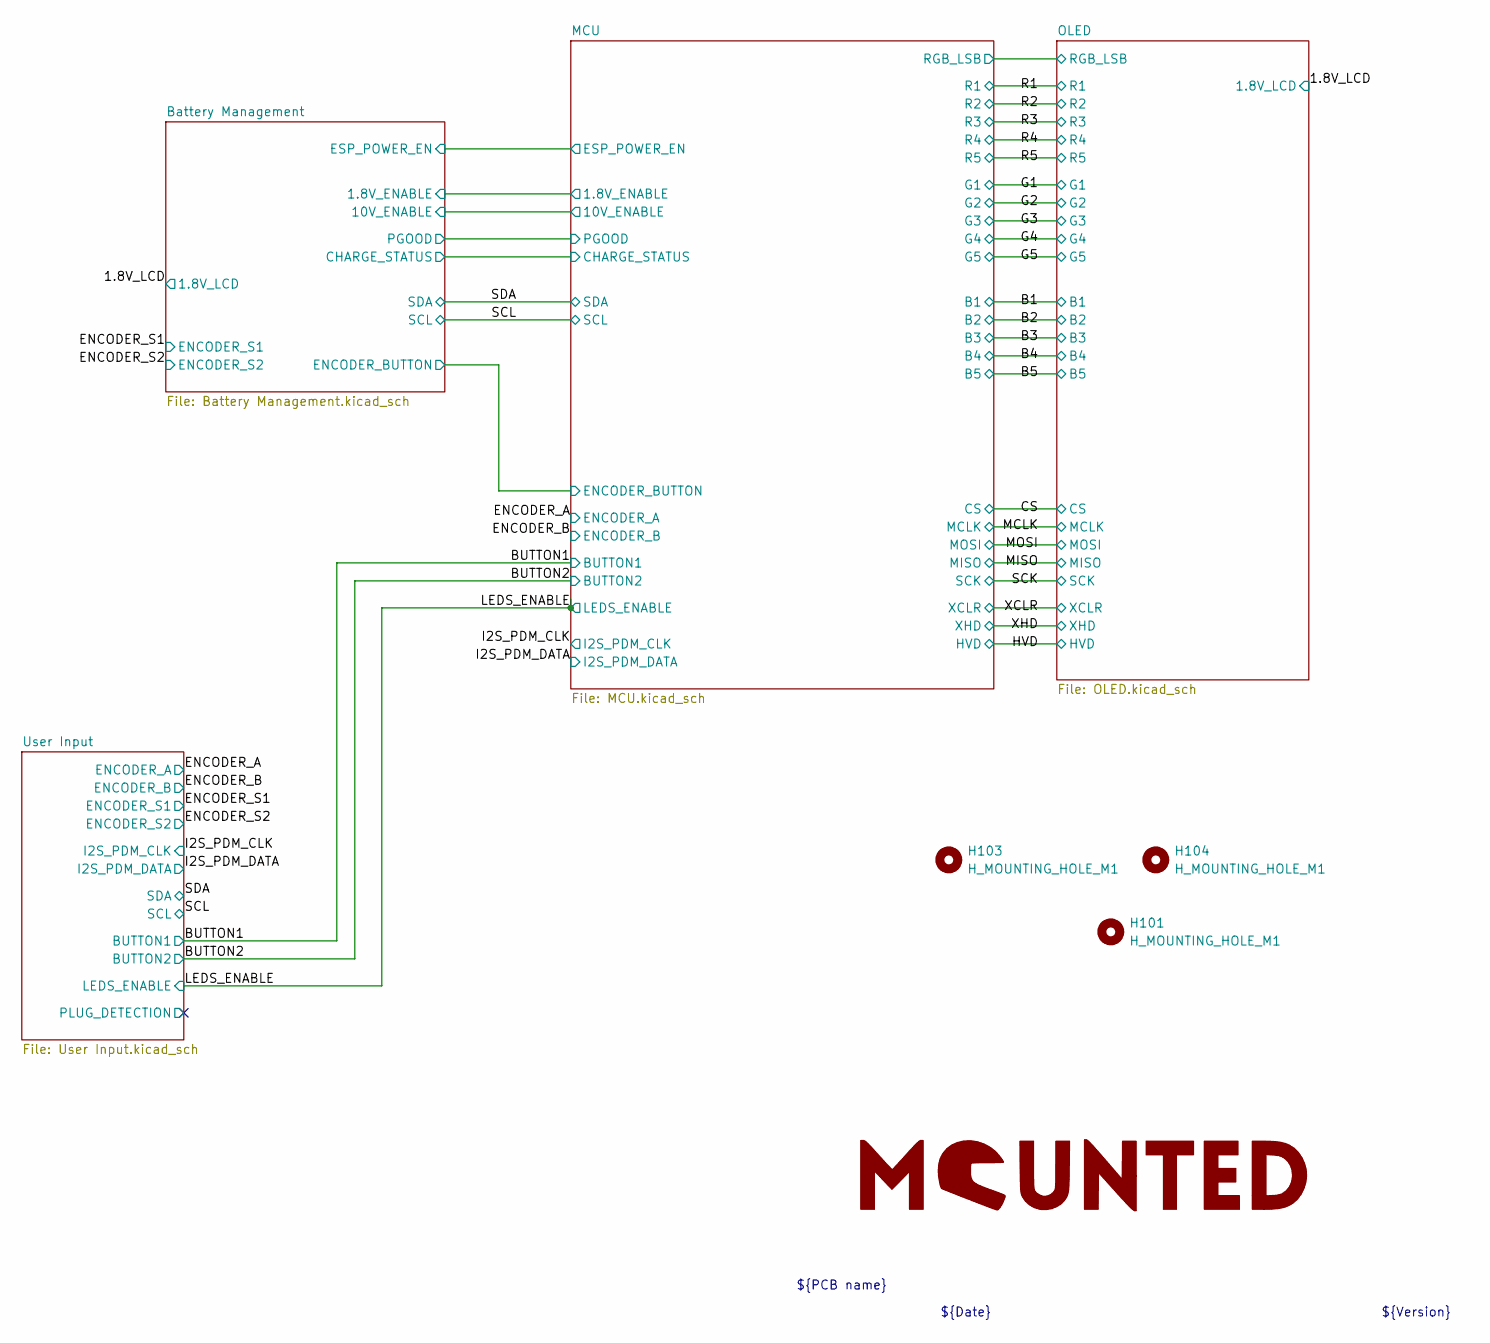
[picture p114: schematic Zoka-MainBoard.kicad_sch]

Parts:
H101, H103, H104: H_MOUNTING_HOLE_M1; MountingHole_1.2mm_M1
LOGO101: mounted_logo

Notes on the sheet:
${PCB name}
${Date}
${Version}

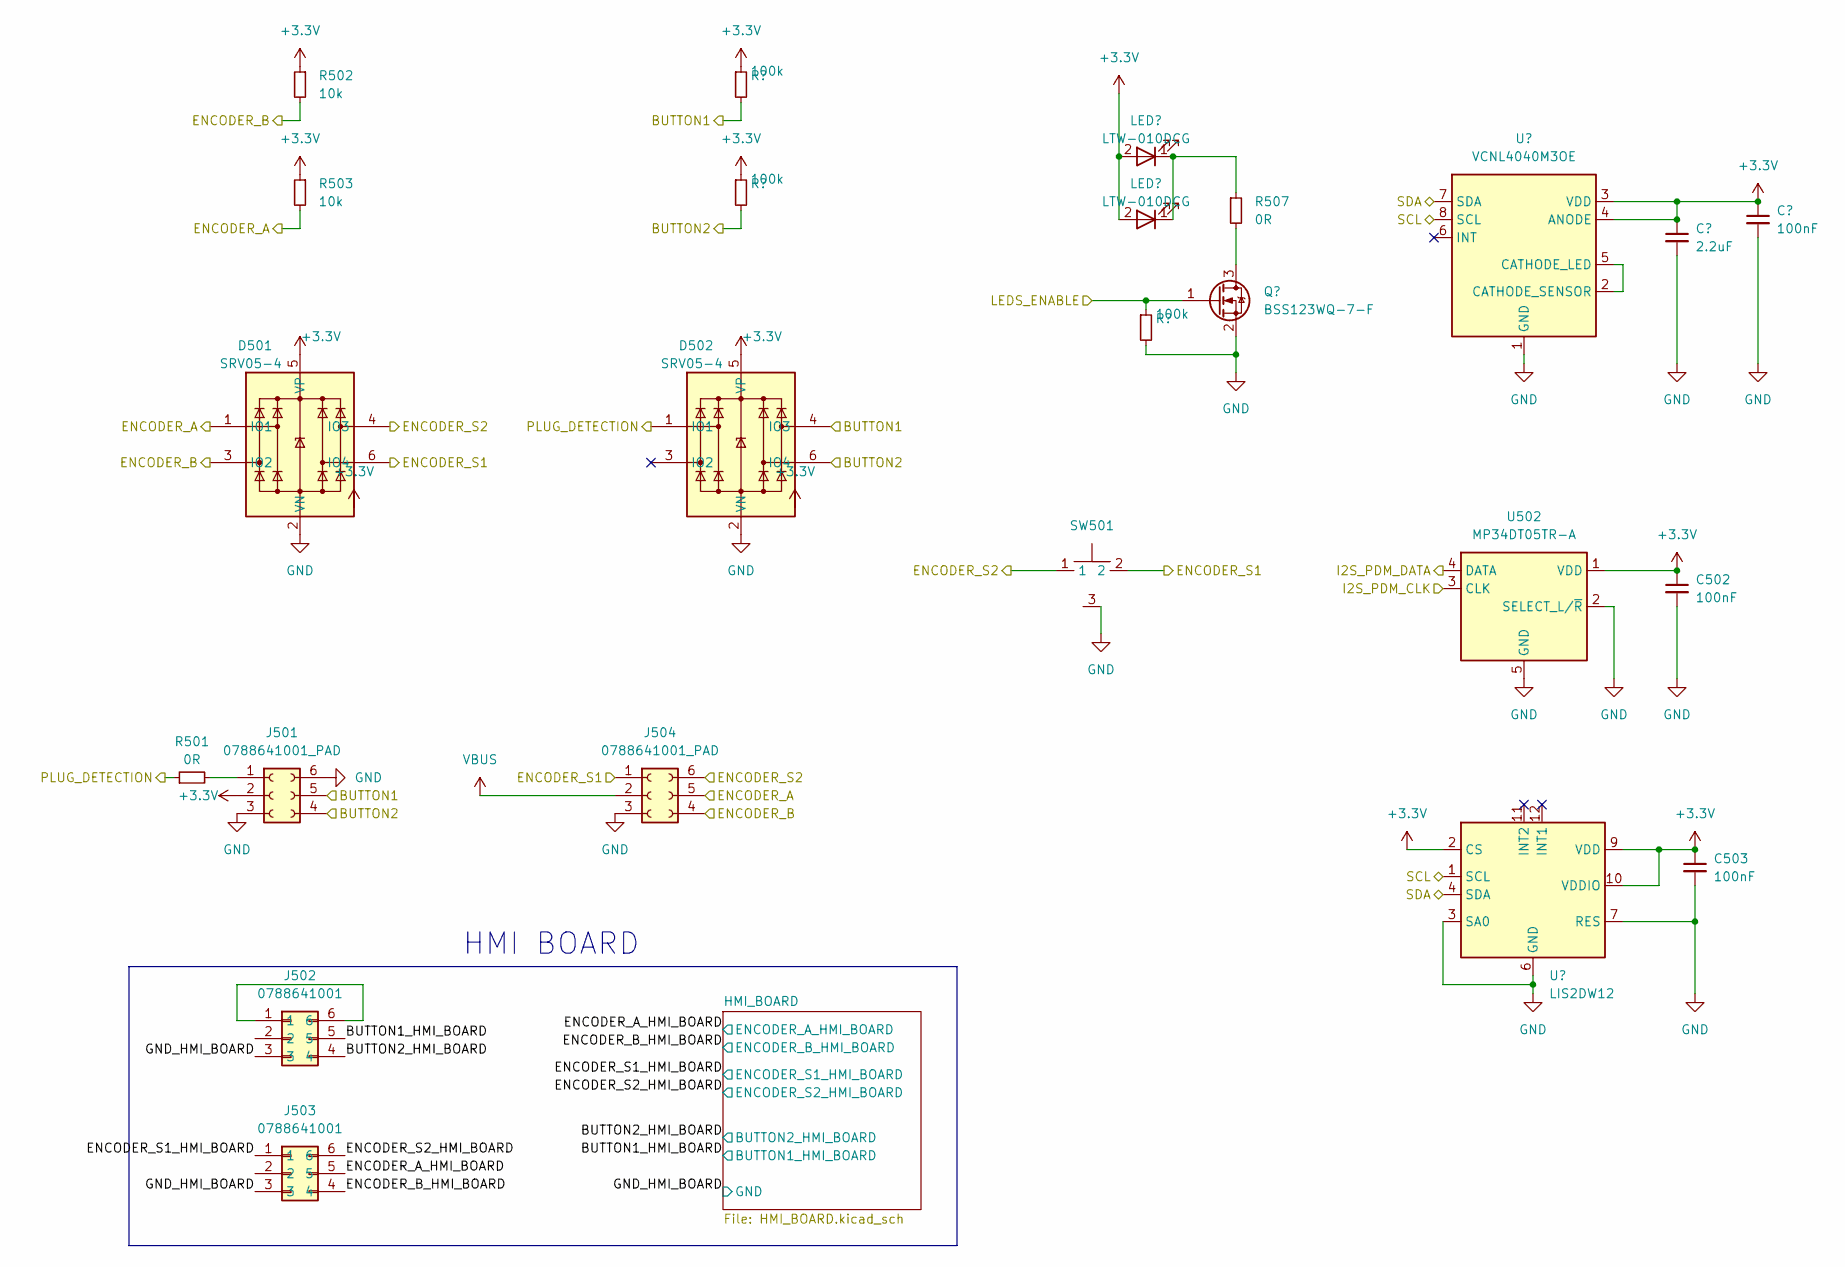
[picture p115: schematic User Input.kicad_sch]

Parts:
C501: C_0603_2.2uF_10V_X7R_10%; C_0603_1608Metric; Voltage 10V; Tolerance 10%
C502, C503, C504: C_0603_100nF_100V_X7R_10%; C_0402_1005Metric; Voltage 50V; Tolerance 10%
D501, D502: D_SRV05-4; SOT-23-6_TECH_PUBLIC; MPN SRV05-4
J501, J504: J_0788641001_PAD; J_788641001_PAD; MPN 0788641001
J502, J503: J_0788641001; J_788641001; MPN 0788641001
LED502, LED503: LED_LTW-010DCG; MPN LTW-010DCG
Q501: Q_BSS123WQ-7-F; SOT-323_SC-70_DIODES_INC; MPN BSS123WQ-7-F
R501, R507: R_0402_0R_1%_0.06W; R_0402_1005Metric; Tolerance 1%
R502, R503: R_0603_10k_1%_0.1W; R_0402_1005Metric; Tolerance 1%
R504, R505, R506: R_0402_100k_1%_0.06W; R_0402_1005Metric; Tolerance 1%
SW501: SW_SKRTLAE010; MPN SKRTLAE010
U501: U_VCNL4040M3OE; VCNL4040_4X2X1.1_VISHAY; MPN VCNL4040M3OE
U502: MP34DT05TR-A; U_MP34DT05TR-A; MPN MP34DT05TR-A
U503: LIS2DW12; LGA-12_2x2mm_P0.5mm; MPN LIS2DW12

Connections:
+3.3V: C501.1, C502.1, C503.1, C504.1, D501.5 (VP), D502.5 (VP), J501.2, LED502.2 (A), LED503.2 (A), R502.1, R503.1, R504.1, R505.1, U501.3 (VDD), U501.4 (ANODE), U502.1 (VDD), U503.2 (CS), U503.9 (VDD), U503.10 (VDDIO); also elsewhere on the board
/BUTTON1: D502.4 (IO3), J501.5, R504.2; also elsewhere on the board
/BUTTON2: D502.6 (IO4), J501.4, R505.2; also elsewhere on the board
/ENCODER_A: D501.1 (IO1), J504.5, R503.2; also elsewhere on the board
/ENCODER_B: D501.3 (IO2), J504.4, R502.2; also elsewhere on the board
/ENCODER_S1: D501.6 (IO4), J504.1, SW501.2; also elsewhere on the board
/ENCODER_S2: D501.4 (IO3), J504.6, SW501.1; also elsewhere on the board
/I2S_PDM_CLK: U502.3 (CLK); also elsewhere on the board
/I2S_PDM_DATA: U502.4 (DATA); also elsewhere on the board
/LEDS_ENABLE: Q501.1 (G), R506.1; also elsewhere on the board
/SCL: U501.8 (SCL), U503.1 (SCL); also elsewhere on the board
/SDA: U501.7 (SDA), U503.4 (SDA); also elsewhere on the board
/User Input/PLUG_DETECTION: D502.1 (IO1), R501.1
GND: C501.2, C502.2, C503.2, C504.2, D501.2 (VN), D502.2 (VN), J501.3, J501.6, J504.3, Q501.2 (S), R506.2, SW501.3, U501.1 (GND), U502.2 (SELECT_L/~R), U502.5 (GND), U503.3 (SA0), U503.6 (GND), U503.7 (RES), U503.8 (GND); also elsewhere on the board
unnamed: J501.1, R501.2
unnamed: J502.1, J502.6
unnamed: J502.3, J503.3
unnamed: LED502.1 (K), LED503.1 (K), R507.1
unnamed: Q501.3 (D), R507.2
unnamed: U501.2 (CATHODE_SENSOR), U501.5 (CATHODE_LED)
VBUS: J504.2; also elsewhere on the board

Notes on the sheet:
HMI BOARD

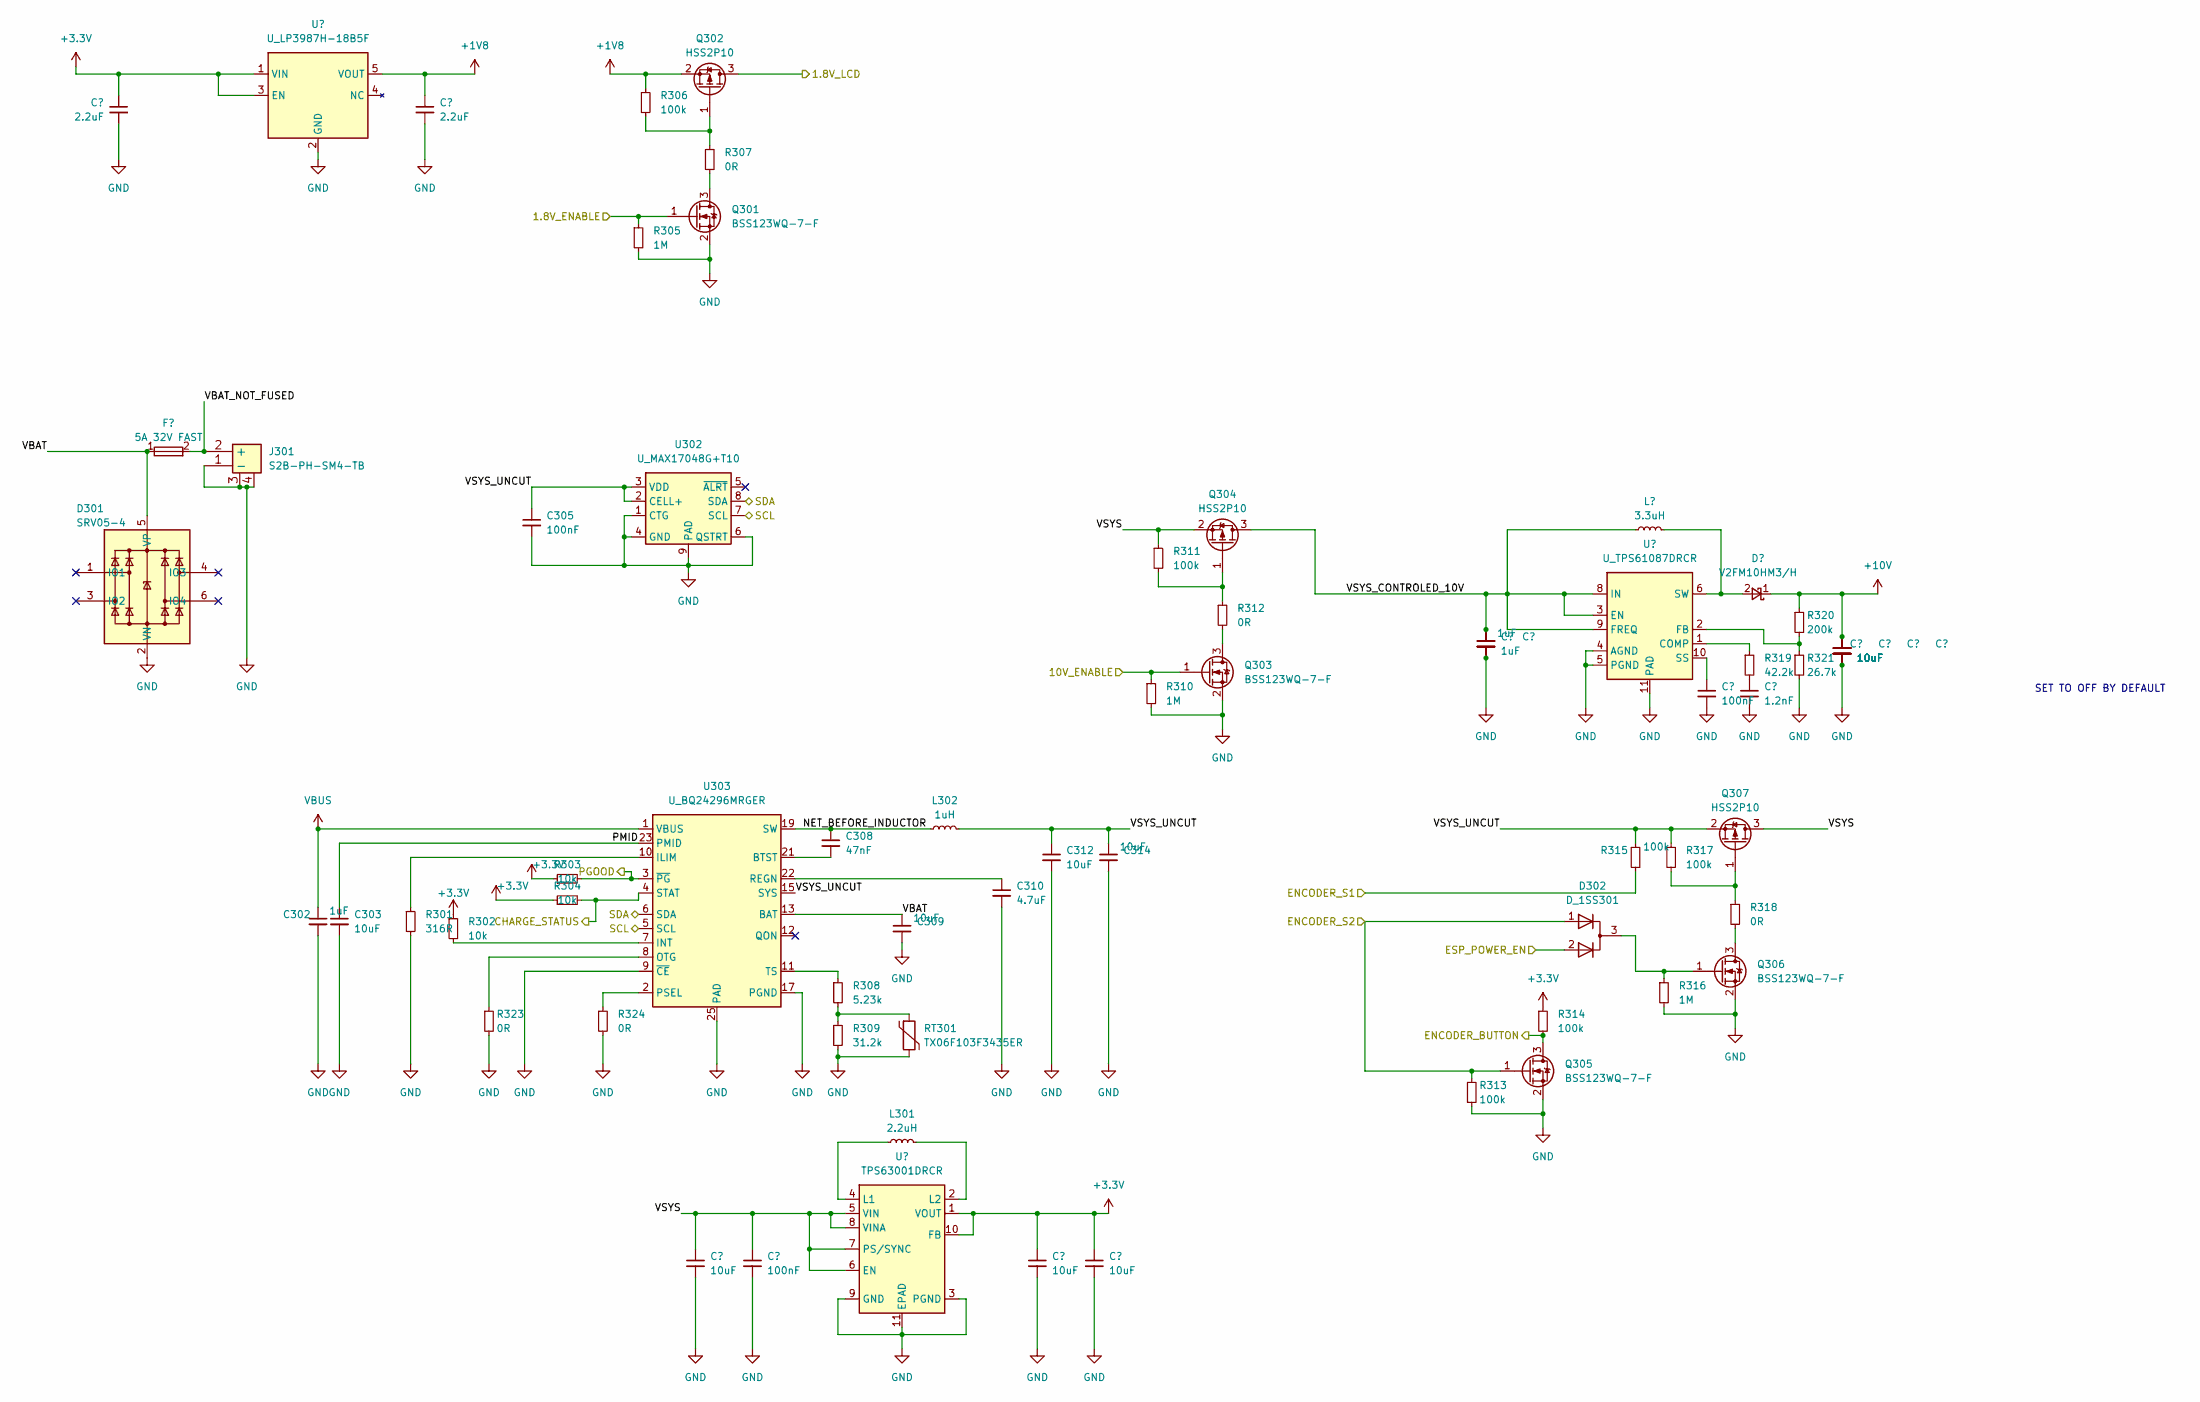
[picture p116: schematic Battery Management.kicad_sch]

Parts:
C301, C304: C_0805_2.2uF_25V_X7R_20%; C_0805_1608Metric; Voltage 25V; Tolerance 20%
C302, C315, C316: C_0402_1uF_10V_X7R_10%; C_0402_1005Metric; Voltage 10V; Tolerance 10%
C303, C306, C309, C311, C312, C313, C314: C_0805_10uF_10V_X7R_10%; C_0805_1608Metric; Voltage 25V; Tolerance 10%
C305, C307, C317: C_0603_100nF_100V_X7R_10%; C_0402_1005Metric; Voltage 50V; Tolerance 10%
C308: C_0402_47nF_50V_X7R_10%; C_0402_1005Metric; Voltage 50V; Tolerance 10%
C310: C_0603_4.7uF_16V_X7R_10%; C_0603_1608Metric; Voltage 16V; Tolerance 10%
C318: C_0402_1.2nF_50V_X7R_10%; C_0402_1005Metric; Voltage 50V; Tolerance 10%
C319, C320, C321, C322: C_1206_10uF_25V_X7R_10%; C_0805_1608Metric; Voltage 25V; Tolerance 10%; PartStatus ___PartStatus
D301: D_SRV05-4; SOT-23-6_TECH_PUBLIC; MPN SRV05-4
D302: D_1SS301; SOT-23_TOSHIBA; MPN 1SS301,LF
D303: D_V2FM10HM3/H; D_SMF_VISHAY; MPN V2FM10HM3/H
F301: F_MFU0603FF05000P100; R_0603_1608Metric; MPN MFU0603FF05000P100
J301: J_JST_S2B-PH-SM4-TB; MPN S2B-PH-SM4-TB
L301: L_FNR3015S2R2MT; Tolerance 20%; MPN FNR3015S2R2MT
L302: L_TFM252012ALMA1R0MTAA; TFM252012ALMA1R0MTAA; MPN TFM252012ALMA1R0MTAA
L303: L_7447789003; Tolerance 20%; MPN 7447789003
Q301, Q303, Q305, Q306: Q_BSS123WQ-7-F; SOT-323_SC-70_DIODES_INC; MPN BSS123WQ-7-F
Q302, Q304, Q307: Q_HSS2P10; SOT-23-3_HUASHUO; MPN HSS2P10
R301: R_0402_316R_1%_0.06W; R_0402_1005Metric; Tolerance 1%
R302, R303, R304: R_0402_10k_1%_0.06W; R_0402_1005Metric; Tolerance 1%
R305, R310, R316: R_0603_1M_1%_0.1W; R_0402_1005Metric; Tolerance 1%
R306, R311, R313, R314, R315, R317: R_0402_100k_1%_0.06W; R_0402_1005Metric; Tolerance 1%
R307, R312, R318, R323, R324: R_0402_0R_1%_0.06W; R_0402_1005Metric; Tolerance 1%
R308: R_0402_5.23k_1%_0.06W; R_0402_1005Metric; Tolerance 1%
R309: R_0603_31.2k_0.5%_0.1W; R_0603_1608Metric; Tolerance 0.5%
R319: R_0402_42.2k_1%_0.06W; R_0402_1005Metric; Tolerance 1%
R320: R_0402_200k_1%_0.06W; R_0402_1005Metric; Tolerance 1%; PartStatus ___PartStatus
R321: R_0402_26.7k_1%_0.06W; R_0402_1005Metric; Tolerance 1%; PartStatus ___PartStatus
RT301: RT_TX06F103F3435ER; NTCG16_XXX_TDK; Tolerance 1%; MPN TX06F103F3435ER
U301: U_LP3987H-18B5F; SOT-23-5_LOW_POWER; MPN LP3987H-18B5F
U302: U_MAX17048G+T10; TDFN-8_MAXIM_INTEGRATED; MPN MAX17048G+T10
U303: U_BQ24296MRGER; VQFN-24_TEXAS_INSTRUMENTS; MPN BQ24296MRGER
U304: U_TPS63001DRCR; PVSON-N10_TEXAS_INSTRUMENTS; MPN TPS63001DRCR
U305: U_TPS61087DRCR; PVSON-N10_TEXAS_INSTRUMENTS; MPN TPS61087DRCR

Connections:
+1V8: C304.1, Q302.2 (S), R306.1, U301.5 (VOUT); also elsewhere on the board
+3.3V: C301.1, C311.1, C313.1, R302.1, R303.1, R304.1, R314.1, U301.1 (VIN), U301.3 (EN), U304.1 (VOUT), U304.10 (FB); also elsewhere on the board
+10V: C319.1, C320.1, C321.1, C322.1, D303.1 (K), R320.1; also elsewhere on the board
/1.8V_LCD: Q302.3 (D); also elsewhere on the board
/Battery Management/1.8V_ENABLE: Q301.1 (G), R305.1; also elsewhere on the board
/Battery Management/10V_ENABLE: Q303.1 (G), R310.1; also elsewhere on the board
/Battery Management/CHARGE_STATUS: R304.2, U303.4 (STAT); also elsewhere on the board
/Battery Management/ENCODER_BUTTON: Q305.3 (D), R314.2; also elsewhere on the board
/Battery Management/ESP_POWER_EN: D302.2 (A2); also elsewhere on the board
/Battery Management/NET_BEFORE_INDUCTOR: C308.1, L302.1, U303.19 (SW), U303.20 (SW)
/Battery Management/PGOOD: R303.2, U303.3 (~PG); also elsewhere on the board
/Battery Management/PMID: C303.1, U303.23 (PMID)
/Battery Management/VBAT: C309.1, D301.5 (VP), F301.1, U303.13 (BAT), U303.14 (BAT)
/Battery Management/VBAT_NOT_FUSED: F301.2, J301.2 (+)
/Battery Management/VSYS: C306.1, C307.1, Q304.2 (S), Q307.3 (D), R311.1, U304.5 (VIN), U304.6 (EN), U304.7 (PS/SYNC), U304.8 (VINA)
/Battery Management/VSYS_CONTROLED_10V: C315.1, C316.1, L303.1, Q304.3 (D), U305.3 (EN), U305.8 (IN), U305.9 (FREQ)
/Battery Management/VSYS_UNCUT: C305.1, C312.1, C314.1, L302.2, Q307.2 (S), R315.1, R317.1, U302.2 (CELL+), U302.3 (VDD), U303.15 (SYS), U303.16 (SYS)
/ENCODER_S1: R315.2; also elsewhere on the board
/ENCODER_S2: D302.1 (A1), Q305.1 (G), R313.1; also elsewhere on the board
/SCL: U302.7 (SCL), U303.5 (SCL); also elsewhere on the board
/SDA: U302.8 (SDA), U303.6 (SDA); also elsewhere on the board
GND: C301.2, C302.2, C303.2, C304.2, C305.2, C306.2, C307.2, C309.2, C310.2, C311.2, C312.2, C313.2, C314.2, C315.2, C316.2, C317.2, C318.2, C319.2, C320.2, C321.2, C322.2, D301.2 (VN), J301.1 (-), J301.3, J301.4, Q301.2 (S), Q303.2 (S), Q305.2 (S), Q306.2 (S), R301.2, R305.2, R309.2, R310.2, R313.2, R316.2, R321.2, R323.2, R324.2, RT301.2, U301.2 (GND), U302.1 (CTG), U302.4 (GND), U302.6 (QSTRT), U302.9 (PAD), U303.9 (~CE), U303.17 (PGND), U303.18 (PGND), U303.25 (PAD), U304.3 (PGND), U304.9 (GND), U304.11 (EPAD), U305.4 (AGND), U305.5 (PGND), U305.11 (PAD); also elsewhere on the board
unnamed: C318.1, R319.2
unnamed: D302.3 (K), Q306.1 (G), R316.1
unnamed: D303.2 (A), L303.2, U305.6 (SW), U305.7 (SW)
unnamed: Q301.3 (D), R307.2
unnamed: Q302.1 (G), R306.2, R307.1
unnamed: Q303.3 (D), R312.2
unnamed: Q304.1 (G), R311.2, R312.1
unnamed: Q306.3 (D), R318.2
unnamed: Q307.1 (G), R317.2, R318.1
unnamed: R308.2, R309.1, RT301.1
unnamed: C308.2, U303.21 (BTST)
unnamed: R301.1, U303.10 (ILIM)
unnamed: R302.2, U303.7 (INT)
unnamed: R323.1, U303.8 (OTG)
unnamed: R324.1, U303.2 (PSEL)
unnamed: C310.1, U303.22 (REGN)
unnamed: R308.1, U303.11 (TS)
unnamed: L301.1, U304.4 (L1)
unnamed: L301.2, U304.2 (L2)
unnamed: R319.1, U305.1 (COMP)
unnamed: R320.2, R321.1, U305.2 (FB)
unnamed: C317.1, U305.10 (SS)
VBUS: C302.1, U303.1 (VBUS), U303.24 (VBUS); also elsewhere on the board

Notes on the sheet:
SET TO OFF BY DEFAULT

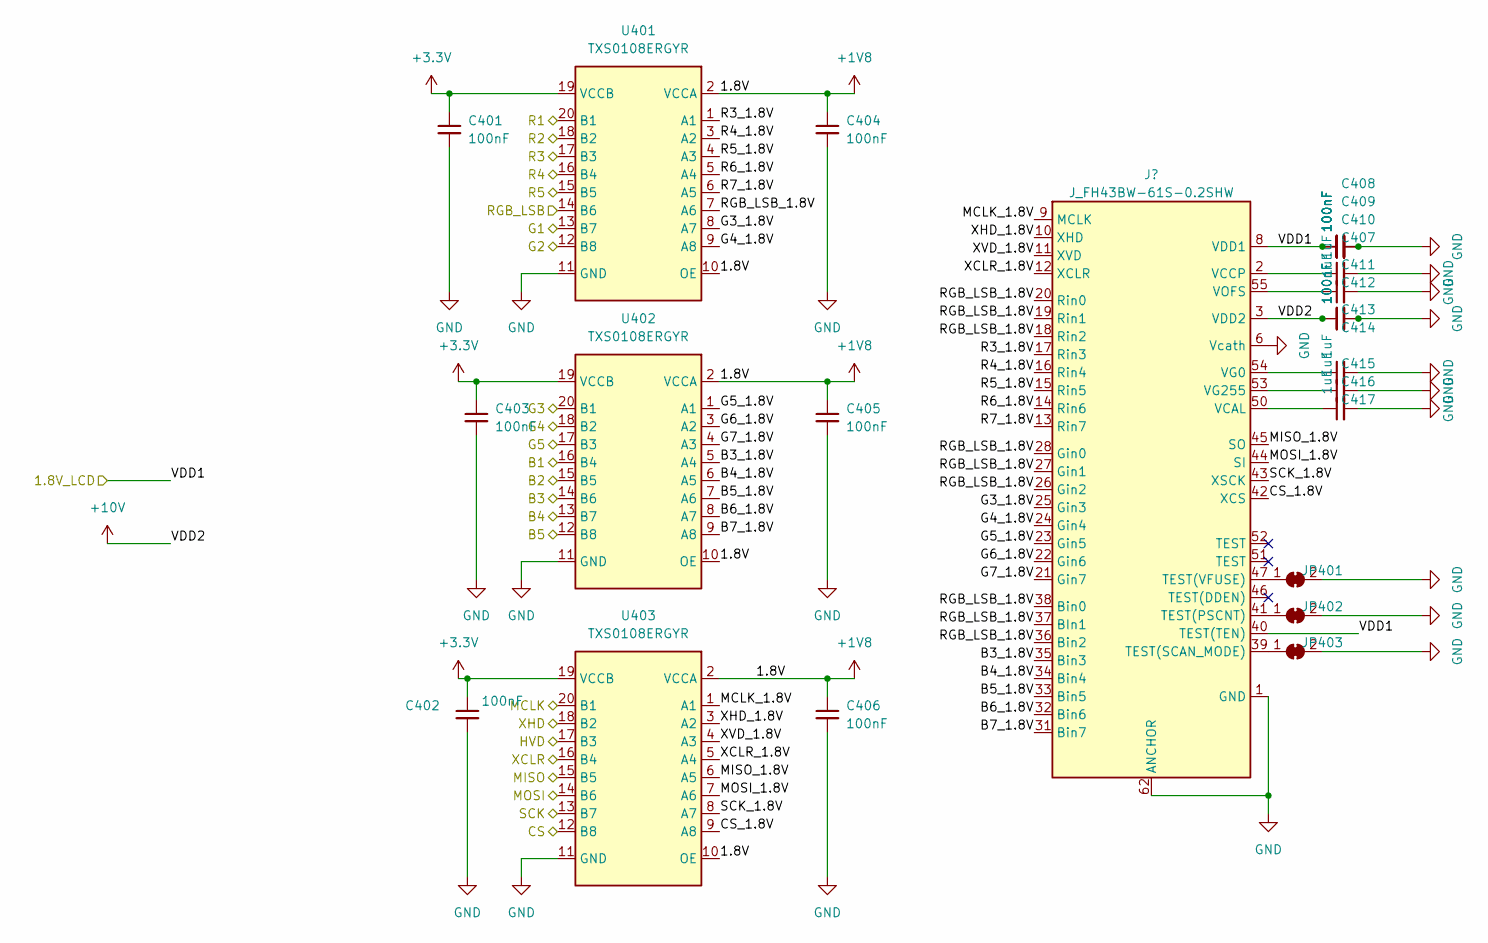
[picture p117: schematic OLED.kicad_sch]

Parts:
C401, C402, C403, C404, C405, C406, C407, C408, C409, C410, C413, C414: C_0603_100nF_100V_X7R_10%; C_0402_1005Metric; Voltage 50V; Tolerance 10%
C411, C412, C415, C416, C417: C_0402_1uF_10V_X7R_10%; C_0402_1005Metric; Voltage 10V; Tolerance 10%
J401: J_FH43BW-61S-0.2SHW; MPN FH43BW-61S-0.2SHW
JP401, JP402, JP403: SolderJumper_2_Bridged; SolderJumper-2_P1.3mm_Bridged_RoundedPad1.0x1.5mm
U401, U402, U403: U_TXS0108E; VQFN-20_TEXAS_INSTRUMENTS; MPN TXS0108ERGYR

Connections:
+1V8: C404.1, C405.1, C406.1, U401.2 (VCCA), U401.10 (OE), U402.2 (VCCA), U402.10 (OE), U403.2 (VCCA), U403.10 (OE); also elsewhere on the board
+3.3V: C401.1, C402.1, C403.1, U401.19 (VCCB), U402.19 (VCCB), U403.19 (VCCB); also elsewhere on the board
+10V: C413.1, C414.1, J401.3 (VDD2), J401.59 (VDD2); also elsewhere on the board
/1.8V_LCD: C407.1, C408.1, C409.1, C410.1, J401.8 (VDD1), J401.29 (VDD1), J401.40 (TEST(TEN)), J401.49 (VDD1); also elsewhere on the board
/B1: U402.16 (B4); also elsewhere on the board
/B2: U402.15 (B5); also elsewhere on the board
/B3: U402.14 (B6); also elsewhere on the board
/B4: U402.13 (B7); also elsewhere on the board
/B5: U402.12 (B8); also elsewhere on the board
/CS: U403.12 (B8); also elsewhere on the board
/G1: U401.13 (B7); also elsewhere on the board
/G2: U401.12 (B8); also elsewhere on the board
/G3: U402.20 (B1); also elsewhere on the board
/G4: U402.18 (B2); also elsewhere on the board
/G5: U402.17 (B3); also elsewhere on the board
/HVD: U403.17 (B3); also elsewhere on the board
/MCLK: U403.20 (B1); also elsewhere on the board
/MCU/RGB_LSB: U401.14 (B6); also elsewhere on the board
/MISO: U403.15 (B5); also elsewhere on the board
/MOSI: U403.14 (B6); also elsewhere on the board
/OLED/B3_1.8V: J401.35 (Bin3), U402.5 (A4)
/OLED/B4_1.8V: J401.34 (Bin4), U402.6 (A5)
/OLED/B5_1.8V: J401.33 (Bin5), U402.7 (A6)
/OLED/B6_1.8V: J401.32 (Bin6), U402.8 (A7)
/OLED/B7_1.8V: J401.31 (Bin7), U402.9 (A8)
/OLED/CS_1.8V: J401.42 (XCS), U403.9 (A8)
/OLED/G3_1.8V: J401.25 (Gin3), U401.8 (A7)
/OLED/G4_1.8V: J401.24 (Gin4), U401.9 (A8)
/OLED/G5_1.8V: J401.23 (Gin5), U402.1 (A1)
/OLED/G6_1.8V: J401.22 (Gin6), U402.3 (A2)
/OLED/G7_1.8V: J401.21 (Gin7), U402.4 (A3)
/OLED/MCLK_1.8V: J401.9 (MCLK), U403.1 (A1)
/OLED/MISO_1.8V: J401.45 (SO), U403.6 (A5)
/OLED/MOSI_1.8V: J401.44 (SI), U403.7 (A6)
/OLED/R3_1.8V: J401.17 (Rin3), U401.1 (A1)
/OLED/R4_1.8V: J401.16 (Rin4), U401.3 (A2)
/OLED/R5_1.8V: J401.15 (Rin5), U401.4 (A3)
/OLED/R6_1.8V: J401.14 (Rin6), U401.5 (A4)
/OLED/R7_1.8V: J401.13 (Rin7), U401.6 (A5)
/OLED/RGB_LSB_1.8V: J401.18 (Rin2), J401.19 (Rin1), J401.20 (Rin0), J401.26 (Gin2), J401.27 (Gin1), J401.28 (Gin0), J401.36 (Bin2), J401.37 (BIn1), J401.38 (Bin0), U401.7 (A6)
/OLED/SCK_1.8V: J401.43 (XSCK), U403.8 (A7)
/OLED/XCLR_1.8V: J401.12 (XCLR), U403.5 (A4)
/OLED/XHD_1.8V: J401.10 (XHD), U403.3 (A2)
/OLED/XVD_1.8V: J401.11 (XVD), U403.4 (A3)
/R1: U401.20 (B1); also elsewhere on the board
/R2: U401.18 (B2); also elsewhere on the board
/R3: U401.17 (B3); also elsewhere on the board
/R4: U401.16 (B4); also elsewhere on the board
/R5: U401.15 (B5); also elsewhere on the board
/SCK: U403.13 (B7); also elsewhere on the board
/XCLR: U403.16 (B4); also elsewhere on the board
/XHD: U403.18 (B2); also elsewhere on the board
GND: C401.2, C402.2, C403.2, C404.2, C405.2, C406.2, C407.2, C408.2, C409.2, C410.2, C411.2, C412.2, C413.2, C414.2, C415.2, C416.2, C417.2, J401.1 (GND), J401.4 (GND), J401.5 (GND), J401.6 (Vcath), J401.7 (GND), J401.30 (GND), J401.48 (GND), J401.56 (Vcath), J401.57 (GND), J401.58 (GND), J401.61 (GND), J401.62 (ANCHOR), J401.63 (ANCHOR), JP401.2 (B), JP402.2 (B), JP403.2 (B), U401.11 (GND), U402.11 (GND), U403.11 (GND); also elsewhere on the board
unnamed: C411.1, J401.2 (VCCP), J401.60 (VCCP)
unnamed: J401.41 (TEST(PSCNT)), JP402.1 (A)
unnamed: J401.39 (TEST(SCAN_MODE)), JP403.1 (A)
unnamed: J401.47 (TEST(VFUSE)), JP401.1 (A)
unnamed: C417.1, J401.50 (VCAL)
unnamed: C415.1, J401.54 (VG0)
unnamed: C416.1, J401.53 (VG255)
unnamed: C412.1, J401.55 (VOFS)
