Mounted-project/AugMounted-electronics/R&D/Zoka-MainBoard_v1.0.0/01_SOURCES/Zoka-MainBoard.kicad_pcb

## KiCad design R&D/Zoka-MainBoard_v1.0.0/01_SOURCES/Zoka-MainBoard.kicad_pcb (continued)

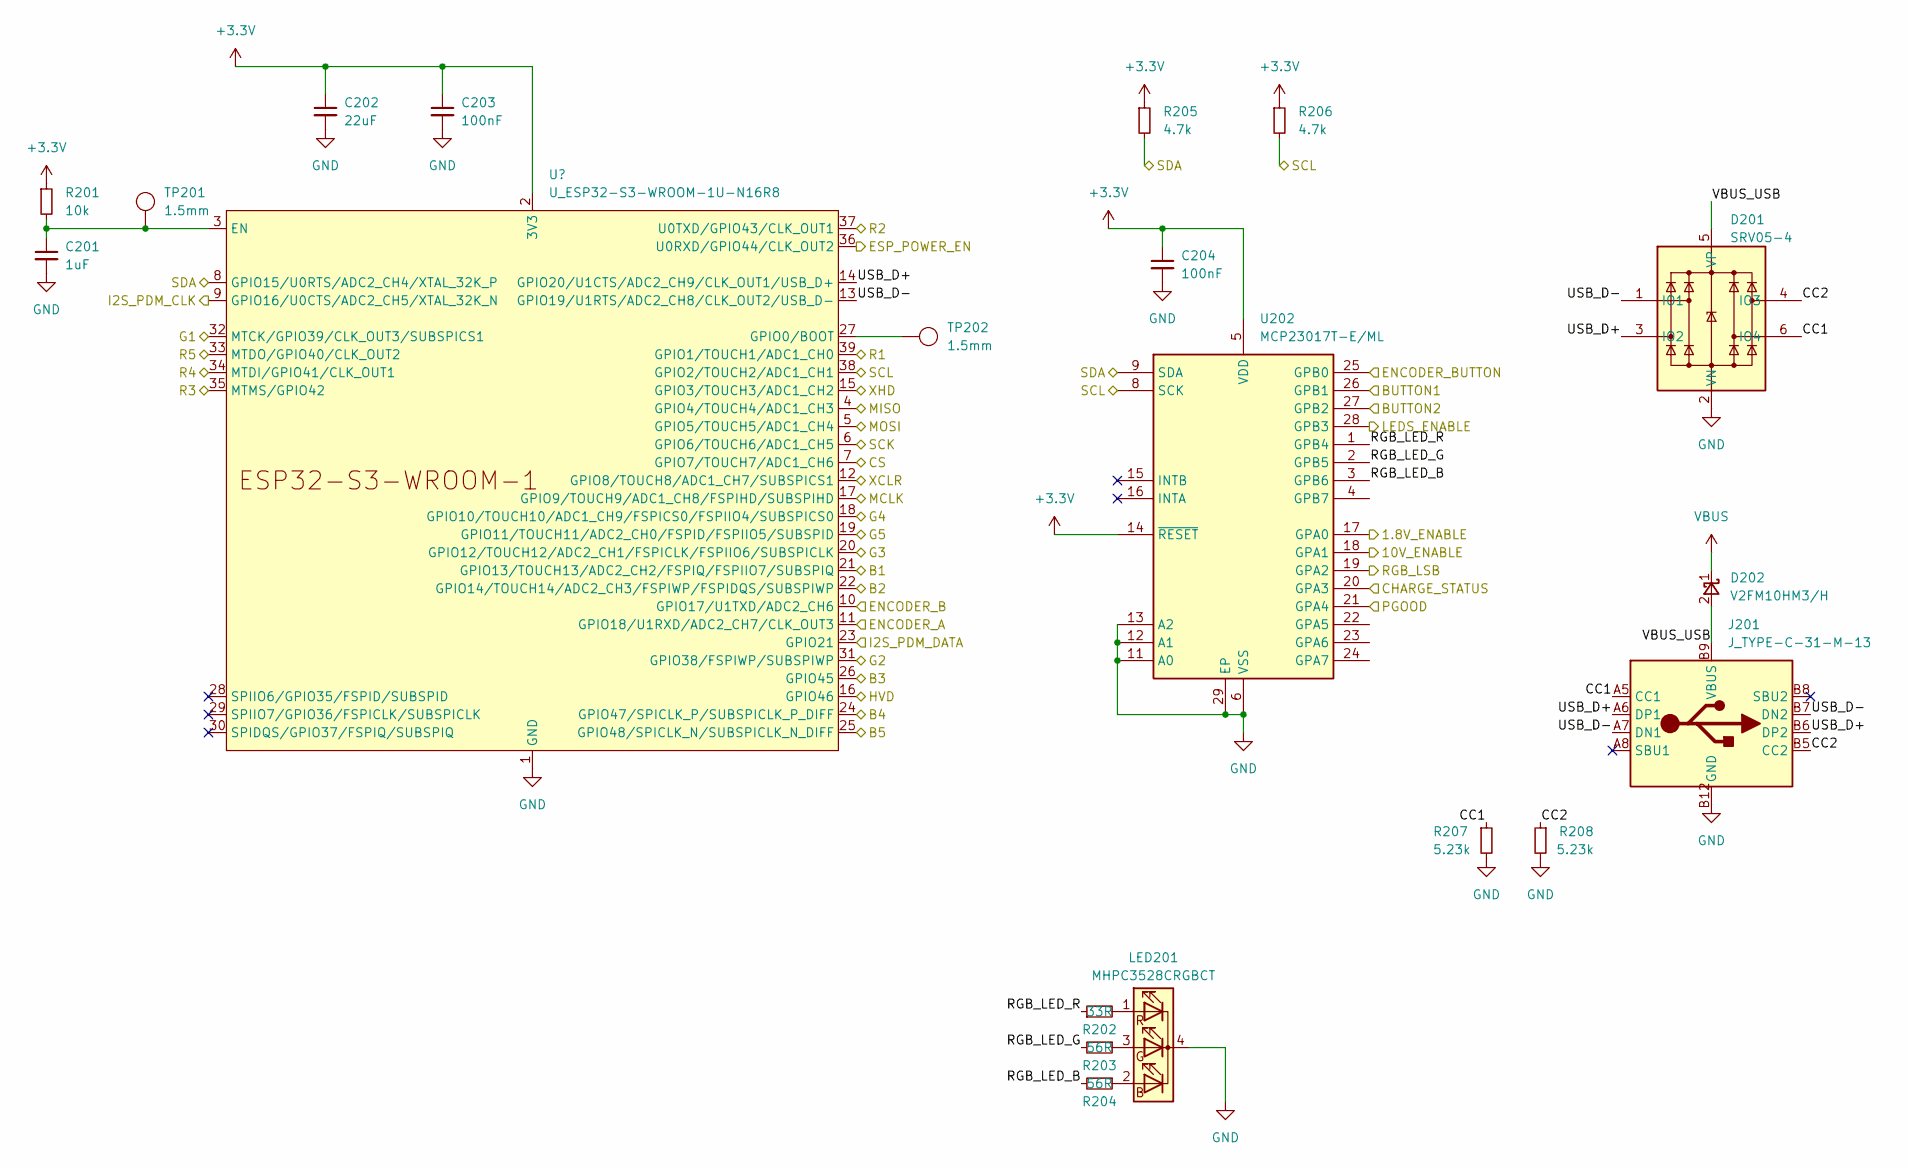
[picture p118: schematic MCU.kicad_sch]

Parts:
C201: C_0402_1uF_10V_X7R_10%; C_0402_1005Metric; Voltage 10V; Tolerance 10%
C202: C_0805_22uF_10V_XR7_20%; C_0805_1608Metric; Voltage 10V; Tolerance 20%; PartStatus ___PartStatus
C203, C204: C_0603_100nF_100V_X7R_10%; C_0402_1005Metric; Voltage 50V; Tolerance 10%
D201: D_SRV05-4; SOT-23-6_TECH_PUBLIC; MPN SRV05-4
D202: D_V2FM10HM3/H; D_SMF_VISHAY; MPN V2FM10HM3/H
J201: J_TYPE-C-31-M-13; MPN TYPE-C-31-M-13
LED201: LED_MHPC3528CRGBCT; MPN MHPC3528CRGBCT
R201: R_0603_10k_1%_0.1W; R_0402_1005Metric; Tolerance 1%
R202: R_0402_33R_1%_0.06W; R_0402_1005Metric; Tolerance 1%
R203, R204: R_0402_56R_1%_0.06W; R_0402_1005Metric; Tolerance 1%
R205, R206: R_0603_4.7k_1%_0.1W; R_0402_1005Metric; Tolerance 1%
R207, R208: R_0603_5.23k_1%_0.1W; R_0402_1005Metric; Tolerance 1%
TP201, TP202: TESTPOINT_1.5MM
U201: ESP32-S3-WROOM-1U-N16R8; ESP32-S3-WROOM-1U; MPN ESP32-S3-WROOM-1U-N16R8
U202: U_MCP23017T-E/ML; QFN-28-1EP_6x6mm_P0.65mm_EP4.25x4.25mm_MICROCHIP; MPN MCP23017T-E/ML

Connections:
+3.3V: C202.1, C203.1, C204.1, R201.1, R205.1, R206.1, U201.2 (3V3), U202.5 (VDD), U202.14 (~RESET); also elsewhere on the board
/B1: U201.21 (GPIO13/TOUCH13/ADC2_CH2/FSPIQ/FSPIIO7/S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); also elsewhere on the board
/B2: U201.22 (GPIO14/TOUCH14/ADC2_CH3/FSPIWP/FSPIDQS/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); also elsewhere on the board
/B3: U201.26 (GPIO45); also elsewhere on the board
/B4: U201.24 (GPIO47/SPICLK_P/SUBSPICLK_P_DIFF); also elsewhere on the board
/B5: U201.25 (GPIO48/SPICLK_N/SUBSPICLK_N_DIFF); also elsewhere on the board
/BUTTON1: U202.26 (GPB1); also elsewhere on the board
/BUTTON2: U202.27 (GPB2); also elsewhere on the board
/Battery Management/1.8V_ENABLE: U202.17 (GPA0); also elsewhere on the board
/Battery Management/10V_ENABLE: U202.18 (GPA1); also elsewhere on the board
/Battery Management/CHARGE_STATUS: U202.20 (GPA3); also elsewhere on the board
/Battery Management/ENCODER_BUTTON: U202.25 (GPB0); also elsewhere on the board
/Battery Management/ESP_POWER_EN: U201.36 (U0RXD/GPIO44/CLK_OUT2); also elsewhere on the board
/Battery Management/PGOOD: U202.21 (GPA4); also elsewhere on the board
/CS: U201.7 (GPIO7/TOUCH7/ADC1_CH6); also elsewhere on the board
/ENCODER_A: U201.11 (GPIO18/U1RXD/ADC2_CH7/CLK_OUT3); also elsewhere on the board
/ENCODER_B: U201.10 (GPIO17/U1TXD/ADC2_CH6); also elsewhere on the board
/G1: U201.32 (MTCK/GPIO39/CLK_OUT3/SUBSPICS1); also elsewhere on the board
/G2: U201.31 (GPIO38/FSPIWP/SUBSPIWP); also elsewhere on the board
/G3: U201.20 (GPIO12/TOUCH12/ADC2_CH1/FSPICLK/FSPIIO6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); also elsewhere on the board
/G4: U201.18 (GPIO10/TOUCH10/ADC1_CH9/FSPICS0/FSPIIO4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); also elsewhere on the board
/G5: U201.19 (GPIO11/TOUCH11/ADC2_CH0/FSPID/FSPIIO5/S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); also elsewhere on the board
/HVD: U201.16 (GPIO46); also elsewhere on the board
/I2S_PDM_CLK: U201.9 (GPIO16/U0CTS/ADC2_CH5/XTAL_32K_N); also elsewhere on the board
/I2S_PDM_DATA: U201.23 (GPIO21); also elsewhere on the board
/LEDS_ENABLE: U202.28 (GPB3); also elsewhere on the board
/MCLK: U201.17 (GPIO9/TOUCH9/ADC1_CH8/FSPIHD/SUBSPIHD); also elsewhere on the board
/MCU/CC1: D201.6 (IO4), J201.A5 (CC1), R207.1
/MCU/CC2: D201.4 (IO3), J201.B5 (CC2), R208.1
/MCU/RGB_LED_B: R204.2, U202.3 (GPB6)
/MCU/RGB_LED_G: R203.2, U202.2 (GPB5)
/MCU/RGB_LED_R: R202.1, U202.1 (GPB4)
/MCU/RGB_LSB: U202.19 (GPA2); also elsewhere on the board
/MCU/USB_D+: D201.3 (IO2), J201.A6 (DP1), J201.B6 (DP2), U201.14 (GPIO20/U1CTS/ADC2_CH9/CLK_OUT1/USB_D+)
/MCU/USB_D-: D201.1 (IO1), J201.A7 (DN1), J201.B7 (DN2), U201.13 (GPIO19/U1RTS/ADC2_CH8/CLK_OUT2/USB_D-)
/MCU/VBUS_USB: D201.5 (VP), D202.2 (A), J201.A4 (VBUS), J201.A9 (VBUS), J201.B4 (VBUS), J201.B9 (VBUS)
/MISO: U201.4 (GPIO4/TOUCH4/ADC1_CH3); also elsewhere on the board
/MOSI: U201.5 (GPIO5/TOUCH5/ADC1_CH4); also elsewhere on the board
/R1: U201.39 (GPIO1/TOUCH1/ADC1_CH0); also elsewhere on the board
/R2: U201.37 (U0TXD/GPIO43/CLK_OUT1); also elsewhere on the board
/R3: U201.35 (MTMS/GPIO42); also elsewhere on the board
/R4: U201.34 (MTDI/GPIO41/CLK_OUT1); also elsewhere on the board
/R5: U201.33 (MTDO/GPIO40/CLK_OUT2); also elsewhere on the board
/SCK: U201.6 (GPIO6/TOUCH6/ADC1_CH5); also elsewhere on the board
/SCL: R206.2, U201.38 (GPIO2/TOUCH2/ADC1_CH1), U202.8 (SCK); also elsewhere on the board
/SDA: R205.2, U201.8 (GPIO15/U0RTS/ADC2_CH4/XTAL_32K_P), U202.9 (SDA); also elsewhere on the board
/XCLR: U201.12 (GPIO8/TOUCH8/ADC1_CH7/SUBSPICS1); also elsewhere on the board
/XHD: U201.15 (GPIO3/TOUCH3/ADC1_CH2); also elsewhere on the board
GND: C201.2, C202.2, C203.2, C204.2, D201.2 (VN), J201.A1 (GND), J201.A12 (GND), J201.B1 (GND), J201.B12 (GND), J201.GND, LED201.4 (K), R207.2, R208.2, U201.1 (GND), U201.40 (GND), U201.41 (GND), U202.6 (VSS), U202.11 (A0), U202.12 (A1), U202.13 (A2), U202.29 (EP); also elsewhere on the board
unnamed: LED201.3 (BA), R203.1
unnamed: LED201.2 (GA), R204.1
unnamed: LED201.1 (RA), R202.2
unnamed: C201.1, R201.2, TP201.1, U201.3 (EN)
unnamed: TP202.1, U201.27 (GPIO0/BOOT)
VBUS: D202.1 (K); also elsewhere on the board

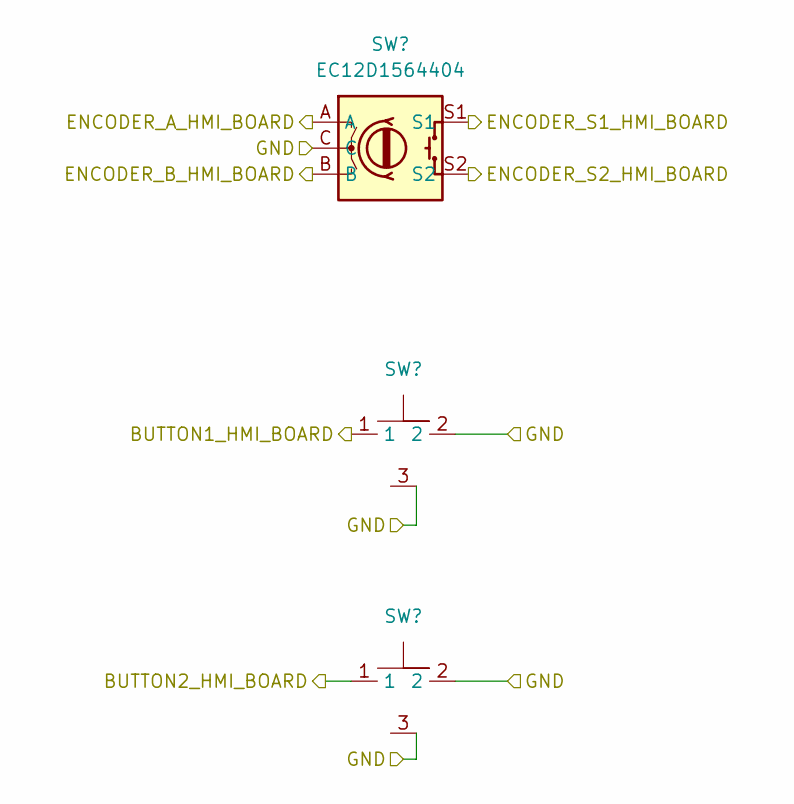
[picture p119: schematic HMI_BOARD.kicad_sch]

Parts:
SW601: SW_EC12D1564404; MPN EC12D1564404
SW602, SW603: SW_SKRTLAE010; MPN SKRTLAE010

Connections:
unnamed: SW601.C, SW602.2, SW602.3, SW603.2, SW603.3

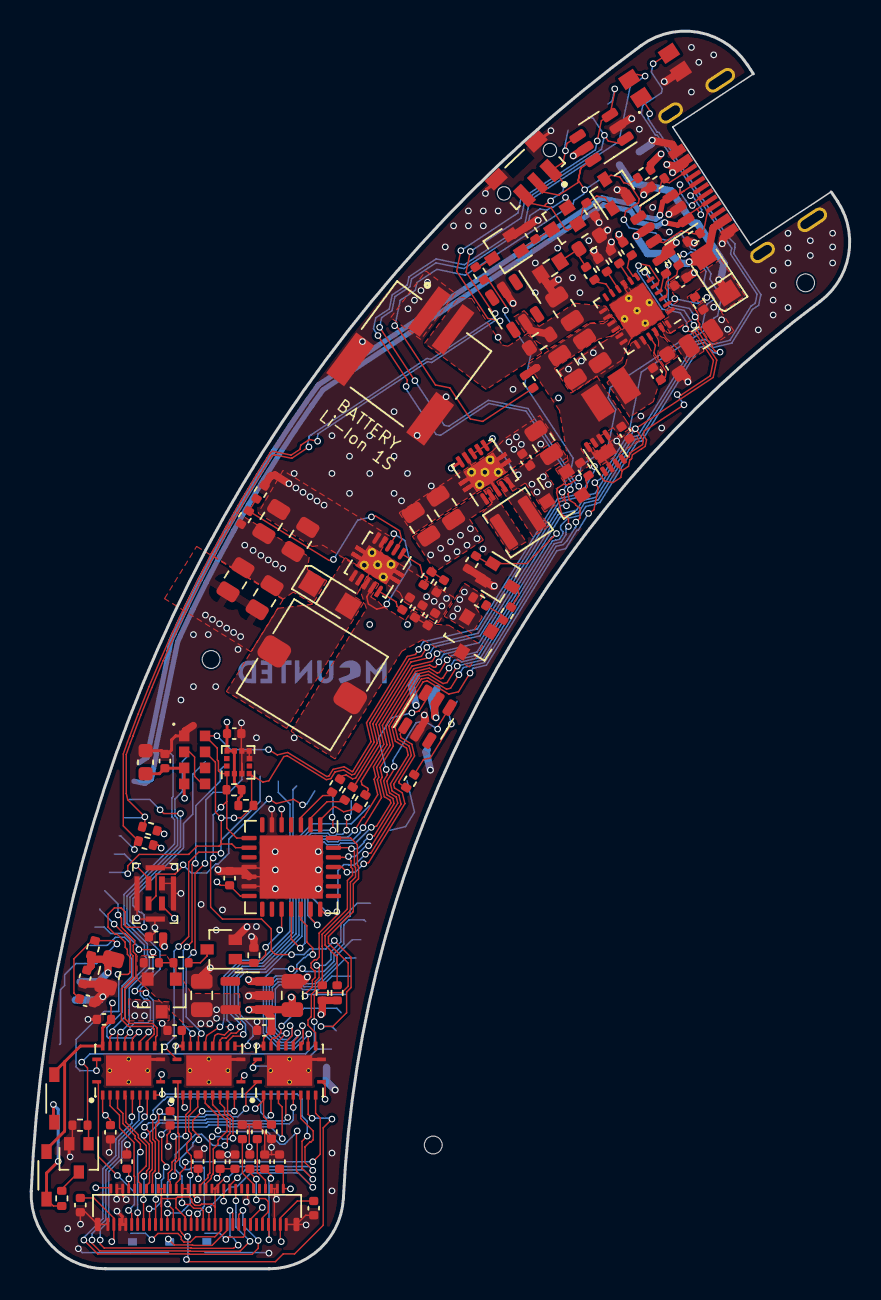
[picture p120: board Zoka-MainBoard.kicad_pcb from above]

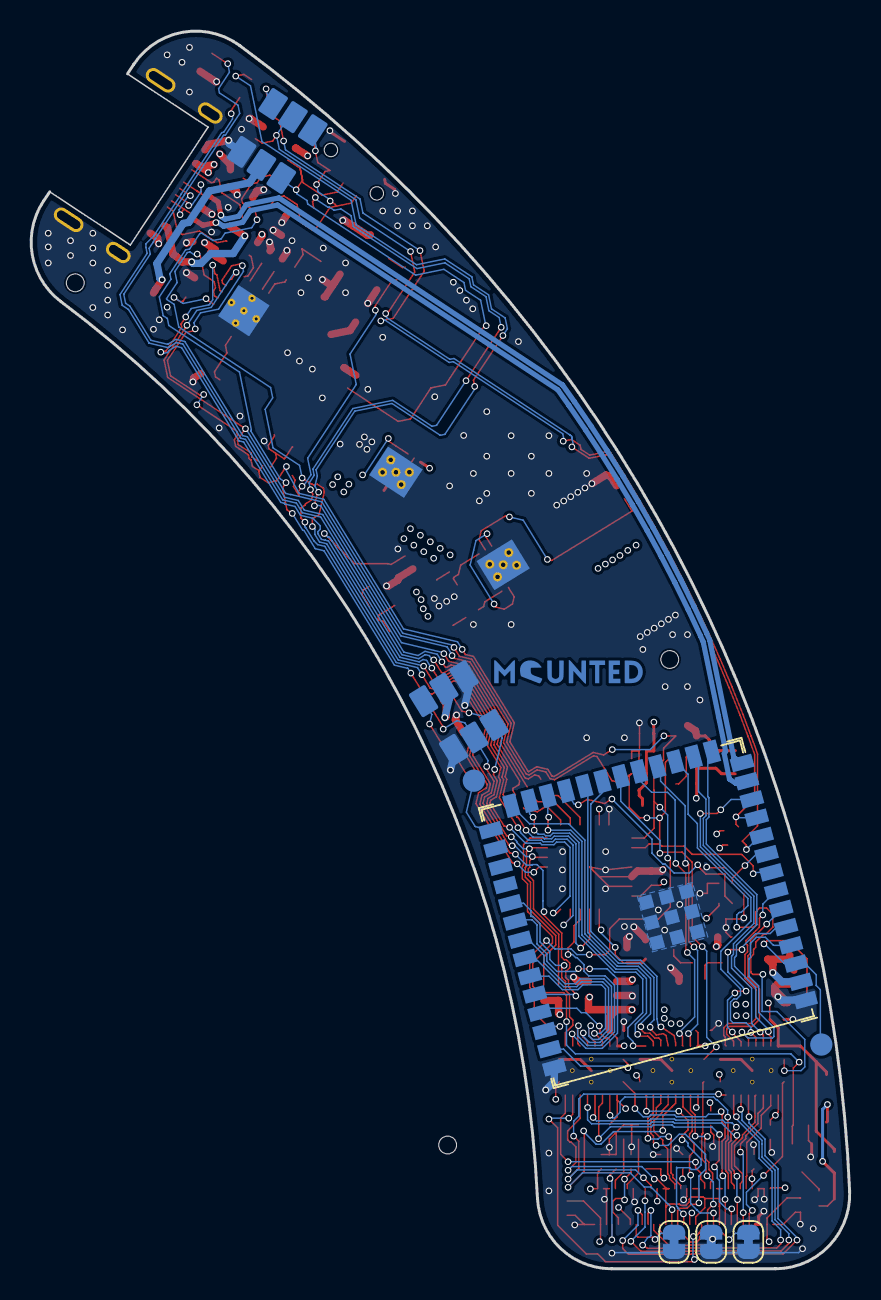
[picture p121: board Zoka-MainBoard.kicad_pcb from below]

Board: 4 copper layers, 55.1 x 83.3 mm, 136 parts (9 on the bottom side), 126 nets.
