Mounted-project/AugMounted-electronics/R&D/HMI-PlugBoard_v1.0.0/01_SOURCES/HMI-PlugBoard.kicad_pcb

## KiCad design R&D/HMI-PlugBoard_v1.0.0/01_SOURCES/HMI-PlugBoard.kicad_pcb (2024-01-17)

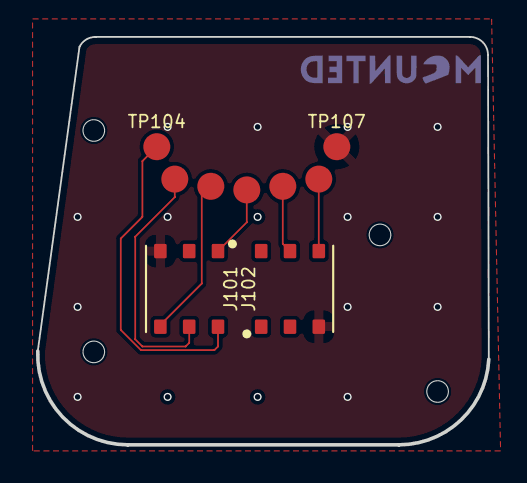
[picture p122: board HMI-PlugBoard.kicad_pcb from above]

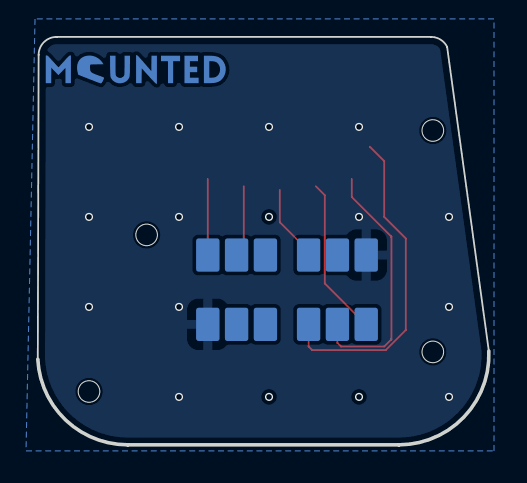
[picture p123: board HMI-PlugBoard.kicad_pcb from below]

Board: 2 copper layers, 25.1 x 22.7 mm, 16 parts (3 on the bottom side), 8 nets.

Parts:
H101, H103, H104, H104#2: H_MOUNTING_HOLE_M1; MountingHole_1.2mm_M1
J101, J102: J_0788641001; J_788641001
J101#2, J102#2: J_0788641001_PAD; J_788641001_PAD
LOGO101: mounted_logo
TP101, TP102, TP103, TP104, TP105, TP106, TP107: TESTPOINT_1.5MM

Connections:
/BUTTON1_HMI_BOARD: J101.5, J101#2.5, TP106.1
/BUTTON2_HMI_BOARD: J101.4, J101#2.4, TP105.1
/ENCODER_A_HMI_BOARD: J102.5, J102#2.5, TP101.1
/ENCODER_B_HMI_BOARD: J102.4, J102#2.4, TP102.1
/ENCODER_S1_HMI_BOARD: J102.1, J102#2.1, TP103.1
/ENCODER_S2_HMI_BOARD: J102.6, J102#2.6, TP104.1
GND: J101.3, J101#2.3, J102.3, J102#2.3, TP107.1
VBUS: J102.2, J102#2.2
