Mounted-project/AugMounted-electronics/R&D/HMI_v1.0.0/01_SOURCES/HMI.kicad_pcb

## KiCad design R&D/HMI_v1.0.0/01_SOURCES/HMI.kicad_pcb (2024-01-17)

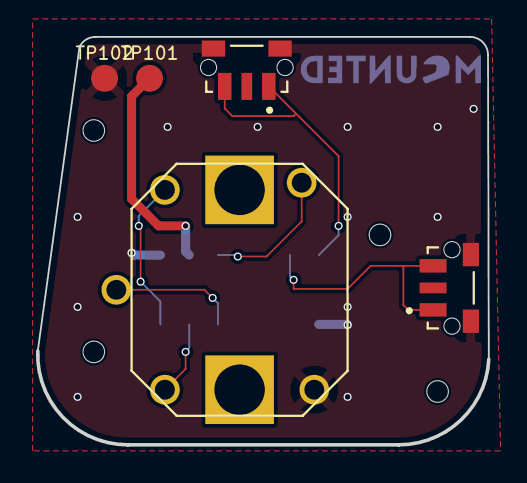
[picture p124: board HMI.kicad_pcb from above]

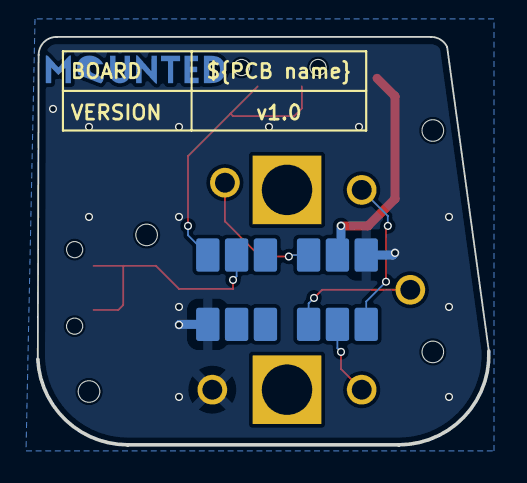
[picture p125: board HMI.kicad_pcb from below]

Board: 2 copper layers, 25.1 x 22.7 mm, 13 parts (4 on the bottom side), 8 nets.

Parts:
CART101: Cartouche_IO
H101, H103, H104, H104#2: H_MOUNTING_HOLE_M1; MountingHole_1.2mm_M1
J101, J102: J_0788641001_PAD; J_788641001_PAD
LOGO101: mounted_logo
SW101: SW_EC12D1564404
SW102, SW103: SW_SKRTLAE010
TP101, TP102: TESTPOINT_1.5MM

Connections:
/BUTTON1_HMI_BOARD: J101.5, SW102.1
/BUTTON2_HMI_BOARD: J101.4, SW103.1
/ENCODER_A_HMI_BOARD: J102.5, SW101.A
/ENCODER_B_HMI_BOARD: J102.4, SW101.B
/ENCODER_S1_HMI_BOARD: J102.1, SW101.S1
/ENCODER_S2_HMI_BOARD: J102.6, SW101.S2
GND: J101.3, J102.3, SW101.C, SW102.2, SW102.3, SW103.2, SW103.3, TP102.1
VBUS: J102.2, TP101.1
