Mounted-project/AugMounted-electronics/prototype_v1.0.0/prototype.kicad_pcb

## KiCad design prototype_v1.0.0/prototype.kicad_pcb (2023-09-18)

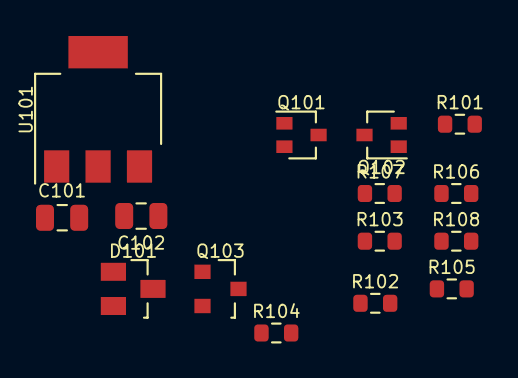
[picture p126: board prototype.kicad_pcb from above]

Board: 2 copper layers, 15 parts (0 on the bottom side), 10 nets, no tracks yet.

Parts:
C101, C102: C_0805_4.7uF_16V_X7R_10%; C_0805_1608Metric
D101: D_MMBD1404; SOT-23_ONSEMI
Q101, Q102: Q_BSS123WQ-7-F; SOT-323_SC-70_DIODES_INC
Q103: Q_HSS2P10; SOT-23-3_DIODES_INCORPORATED
R101, R102, R103, R104, R105, R107, R108: R_0603_100k_1%_0.1W; R_0603_1608Metric
R106: R_0603_10k_1%_0.1W; R_0603_1608Metric
U101: U_AP2114HA-3.3TRG1; SOT-223-3_TABPIN2_DIODES_INC

Connections:
3.3V: C102.1, R101.2, U101.3 (VOUT)
/BATTERY_MEASURE: R107.2, R108.1
/BUTTON_PIN: Q101.3 (D), R101.1
BAT+: Q103.2 (S), R103.2, R105.1
GND: C101.2, C102.2, Q101.2 (S), Q102.2 (S), R102.2, R104.2, R108.2, U101.2 (GND)
unnamed: C101.1, Q103.3 (D), R107.1, U101.1 (VIN)
unnamed: D101.1 (A1), Q101.1 (G), R102.1
unnamed: D101.3 (K), Q102.1 (G), R104.1
unnamed: Q102.3 (D), R106.2
unnamed: Q103.1 (G), R105.2, R106.1
