Mounted-project/AugMounted-electronics/(commit log)

2023-09-18 Added existing schematics of the prototype_v1.0.0
    [prototype.kicad_pcb, prototype.kicad_sch]
2023-11-05 started project
    [BM02B-SRSS-TB.STEP, BM04B-SRSS-TB.STEP, CLX6F-FKC-CKNNQDGBB7A363 v2.step, CP_Elec_8x10.5_KNSCHA.step, C_0201_0603Metric.step, C_0402_1005Metric.step, C_0603_1608Metric.step, C_0805_2012Metric.step]
2023-11-05 Added Kicad project files
    [AugMounted_DevBoard.kicad_pcb, AugMounted_DevBoard.kicad_sch, MCU.kicad_sch]
2023-11-05 Major components are done in library
    [MCU.kicad_sch]
2023-11-05 Created all components, placed them, and added images of typical applications. ECX334A and ESP32-S3 pdf are available in 00_RESOURCES
    [AugMounted_DevBoard.kicad_sch, Battery Management.kicad_sch, MCU.kicad_sch, OLED.kicad_sch, TDFN-8_MAXIM_INTEGRATED.step, VQFN-24_TEXAS_INSTRUMENTS.step]
2023-11-08 Oled driving circuit done, need to connect everything to the ESP32
    [AugMounted_DevBoard.kicad_sch, L_7447789003.step, OLED.kicad_sch]
2023-11-15 Schematic 90% done
    [AugMounted_DevBoard.kicad_pcb, AugMounted_DevBoard.kicad_sch, Battery Management.kicad_sch, J_JST_S2B-PH-SM4-TB.step, L_FNR3015S2R2MT.step, MCU.kicad_sch, OLED.kicad_sch, SOT-23_TOSHIBA.step]
2023-11-15 Moved components
    [AugMounted_DevBoard.kicad_sch, Battery Management.kicad_sch, MCU.kicad_sch]
2023-11-16 Schematic done
    [AugMounted_DevBoard.kicad_pcb, AugMounted_DevBoard.kicad_sch, Battery Management.kicad_sch, MCU.kicad_sch, OLED.kicad_sch, QFN-28-1EP_6x6mm_P0.65mm_EP4.25x4.25mm_MICROCHIP.step, SW_SKRTLAE010.step, U_ICS-41350.step]
2023-11-17 First revision of the layout
    [AugMounted_DevBoard.kicad_pcb, AugMounted_DevBoard.kicad_sch, Battery Management.kicad_sch, LGA-12_2x2mm_P0.5mm_ST.step, MCU.kicad_sch, OLED.kicad_sch, User Input.kicad_sch]
2023-11-23 Changed layout to a banana shape
    [25mm.3mf, AugMounted_DevBoard.kicad_pcb, AugMounted_DevBoard.kicad_sch, Battery Management.kicad_sch, HMI_BOARD.kicad_sch, J_788641001.stp, LED_LTW-010DCG.step, LED_MHPC3528CRGBCT.step]
2023-11-23 Added resistors for CC1 and CC2 pins, layout is started on the high part of the board
    [AugMounted_DevBoard.kicad_pcb, AugMounted_DevBoard.kicad_sch, Battery Management.kicad_sch, MCU.kicad_sch, outline5.dxf, outlne6.dxf]
2023-11-24 Changed layout + all passive to 0402
    [AugMounted_DevBoard.kicad_pcb, AugMounted_DevBoard.kicad_sch, Battery Management.kicad_sch, MCU.kicad_sch, OLED.kicad_sch, R_0402_1005Metric.step, User Input.kicad_sch, VQFN-20_TEXAS_INSTRUMENTS.step]
2023-11-28 Component layout is done, routing video signals is done too.
    [25mm.3mf, AugMounted_DevBoard.kicad_pcb, AugMounted_DevBoard.kicad_sch, MCU.kicad_sch, OLED.kicad_sch, U_ICS-41350.step, U_MP34DT05TR-A.step, User Input.kicad_sch]
2023-12-08 Layout almost done
    [AugMounted_DevBoard.kicad_pcb, MCU.kicad_sch, OLED.kicad_sch, User Input.kicad_sch]
2023-12-08 Layout done
    [AugMounted_DevBoard.kicad_pcb]
2023-12-13 Excluded violations, added via stiching for GND. Ready for review/Production
    [AugMounted_DevBoard.kicad_pcb]
2023-12-13 Stated receptacle board, need to change the name from HMI to receptacle
    [25mm.3mf, AugMounted_HMI.kicad_pcb, AugMounted_HMI.kicad_sch, Battery Management.kicad_sch, HMI_BOARD.kicad_sch, MCU.kicad_sch, OLED.kicad_sch, User Input.kicad_sch]
2023-12-13 Library changes
    [68710814522.step]
2024-01-17 Pushing all boards
    [25mm.3mf, AugMounted_DevBoard.kicad_pcb, AugMounted_DevBoard.kicad_sch, AugMounted_HMI.kicad_pcb, AugMounted_HMI.kicad_sch, Battery Management.kicad_sch, HMI-PlugBoard.kicad_pcb, HMI-PlugBoard.kicad_sch]
