Mounted-project/AugMounted-electronics/(notices)

Notices in the files:
mounted-lib/3D/C_1206_3216Metric.step:
Copyright (C) 2017, kicad StepUp
This work is licensed under the [Creative Commons CC-BY-SA 4.0 License](https://creativecommons.org/licenses/by-sa/4.0/legalcode),
with the following exception:
To the extent that the creation of electronic designs that use 'Licensed Material' can be considered to be 'Adapted Material',
You are free to use the library data in your own projects without the obligation to share your project files under this or any other license agreement.
mounted-lib/3D/D_SMA_BOURNS.step:
This program is free software: you can redistribute it and/or modify
it under the terms of the GNU General Public License as published by
the Free Software Foundation, either version 3 of the License, or
any later version.
itself might be covered by the GNU General Public License.
mounted-lib/3D/NTCG16_XXX_TDK.step:
Copyright (C) 2018, kicad StepUp
mounted-lib/3D/TO-252-3_TabPin2_DIODES_INC.step:
Copyright (C) 2017, Ray Benitez
mounted-lib/3D/LED_WS2812B.step:
Copyright (C) 2019, kicad StepUp
mounted-lib/3D/HTSSOP-14-1EP_TI_PWP0014A.step:
Copyright (C) 2020, kicad StepUp
mounted-lib/3D/TDFN-8_MAXIM_INTEGRATED.step:
Copyright (C) 2022, kicad StepUp
This work is licensed under the
[Creative Commons CC-BY-SA 4.0 License](https://creativecommons.org/licenses/by-sa/4.0/legalcode),
project files under this or any other license agreement. However, if you wish to distribute
mounted-lib/3D/J_ERF8-010-01-X-D-RA-XX.step:
FILE_NAME( 'e:/temp/worker_907/temp/exporttempdir_7764_126_E78Fc/format_0/ERF8-010-01-S-D-RA-TR.stp', '2022-06-03T14:13:39', ( 'License CC BY-ND 4.0' ), ( 'CADENAS' ), ' ', 'PARTsolutions', ' ' );
mounted-lib/3D/J_DWM-13-53-L-D-200.stp:
author */ ('License CC BY-ND 4.0'),
mounted-lib/3D/J_RSM-113-02-L-D.step:
FILE_NAME( 'e:/temp/worker_153/temp/exporttempdir_6392_130_JC5UB/format_0/RSM-113-02-L-D.stp', '2022-06-08T09:01:46', ( 'License CC BY-ND 4.0' ), ( 'CADENAS' ), ' ', 'PARTsolutions', ' ' );
